lili-lines/ratatouille/README.md

# 🐭 Ratatouille

Lien du blog : https://lili-lines.github.io/ratatouille/

Micromouse with Analog Whiskers
