lili-lines/ratatouille/note.txt

lancer le blog
> bundle exec jekyll serve

selon la date du titre les articles sont affiche, Jekyll n'affiche pas les articles écrire dans le futur
> bundle exec jekyll serve --future

Ref compo :
. https://www.pjrc.com/store/teensy40.html
. https://arduino.blaisepascal.fr/codeur-absolu-as5600/
. gyro : https://components101.com/sensors/mpu6050-module

## References global

- [The Inception of Chedda: A detailed design and analysis of Micromouse](https://www.physics.unlv.edu/~bill/ecg497/Drew_Tondra_report.pdf)
- [Timothy Boger's Engineering Blog — Micromouse](https://timsengineeringblog.weebly.com/micromouse.html)
- [Ian Hoffman — Micromouse Project Introduction](https://ianmhoffman.github.io/Micromouse/)
- [Embedded System Engineering — Micromouse Robot](http://embeddedsystemengineering.blogspot.com/2015/03/micromouse-robot.html)
- [Micromouse exemple design](https://ukmars.org/contests/micromouse/)

. Post 3D print et pièce à construire
retour impression 3D : pour les petites pièce c'était pas tres précis
mais en recoupant eu cuteur ça passe.
et les trop petites pièces se décolle
. Post test moteur + vitesse : shema branchage
. Post composant : utiliser le power du labo + multimetre pour verif chaque IN/OUT

bio-inspiration

Ref :
. https://github.com/prometheux-ar/cyberpunk

Idées :
. Key Takeaways
. What I Learned This Week
. Life Hacks

Legend :
🚧 todo
🐭 for mouse
💡 idées, astuces
👀 resultats
📌 rappel
🔍 zoom
🎓 acquis

### Pour le post Takeaways, composants :
Fichier,	Contenu,	Rôle

_data/components.yml	
les infos (titres, textes, images, IN/OUT) 
ce que tu édites au quotidien

_includes/component-carousel.html	
la structure HTML (boucle Liquid)	
tu n'y touches presque jamais

assets/main.scss	
le CSS .compo-*	style global, 
réutilisable

### 🎨 Style preview — UMBRA theme

Normal text with a [link](#), some **bold**, and inline `code`. You can also
<mark>highlight</mark> an important word.

> ⚠️ Important message — a callout styled like a cyberpunk terminal.

```cpp
int v = analogRead(A0);   // code block, terminal look
```

<ul class="post-tags">
  <li><a href="#">#electronics</a></li>
  <li><a href="#">#algo</a></li>
  <li><a href="#">#whisker</a></li>
</ul>

---

Exemple concret : lire ta moustache (AS5600 → Teensy)
La moustache se plie → l'aimant tourne → l'AS5600 met une tension 
sur sa broche OUT. Convention : 0 V = angle mini, 
3,3 V = angle maxi. 
→ moustache à moitié pliée = ~1,65 V.
Ce fil arrive sur la broche A0 du Teensy.
Le ADC du Teensy mesure cette tension et la transforme en nombre : 
analogRead(A0) → ~2048 (sur 0–4095).
Le Teensy « reconnaît » l'info parce que ton code sait que 
« la tension sur A0 = l'angle de la moustache ». C'est toi qui as 
fixé cette convention en le programmant.

moustache pliée ─► AS5600 sort 1,65 V ─► A0 ─► ADC lit 2048 ─► 
                          "moustache à moitié pliée"
                         (la convention : V ∝ angle)

Information = what we want to know or command, e.g. "the whisker 
is bent", "go at 80%".
L'information est codée dans une grandeur physique du signal : 
une tension 3.3$V$, la vune durée, une suite de bits)
→ Le composant « reconnaît » parce qu'il applique la même 
convention que l'émetteur. C'est comme deux personnes qui 
parlent la même langue.

Signal = the physical carrier of the information on a wire: a 
voltage or a pulse (e.g. 3.3 V = "on"). It carries the information, 
not energy, so its current is tiny.

PARTI 2 MOUSTACHE AS5600

XP:
. aimant + structure stable (proto moustache)
. teensy
. as5600
. power = USB

⚠️ faire une structure ajustable : determiner l'espace optimale entre l'aimant et la puce

result:
. shema du proto
. lecture de la valeur pour chaque angle de la moustache
. estimation des seuils (~)

🚧 TODO: <br>
. mesure avec la piece 3D <br> 
. log the angle → value curve while bending the rod by known amounts, real grah data value (py)

#### 2.1 What do we do with the number ?
Once the angle is a number, we watch for the release: the moment a whisker, bent against a wall, springs back. Two cases:

1. the robot drifts slightly from the wall → the whisker releases slowly
2. the wall ends: intersection → the whisker releases suddenly

#### 2.2 Derivative + threshold
We tell the two apart with the derivative, how fast the signal changes: <br>
. slow release → small derivative <br>
. sudden release → large derivative, a spike <br>

So we put a threshold on the derivative: <br>
. above it → "The wall just ended, there is an opening here" <br>
. below → "I'm just drifting, keep following the wall"

Detecting one specific event by a criterion like this is called discrimination.

PROTOCOLE XP :
1. Baseline, moteur OFF, AVEC les 4 défenses → référence propre
2. AVEC les 4 défenses, moteur ON → compare à la référence
3. Retire le RC filter SEUL, moteur ON → compare, remets-le
4. Retire le découplage SEUL, moteur ON → compare, remets-le
5. Retire le réservoir SEUL, moteur ON → compare, remets-le
6. Casse la masse en étoile, moteur ON → compare, restaure-la

branchement UBS
ouvrir arduino

Tools → Board → Teensy 4.0        (vérifie que c'est coché)
Tools → Port → select le port du Teensy ("Teensy", COMx Serial Port)

Upload code 

Tools → Serial Monitor    (affiche les chiffres en texte)
Tools → Serial Plotter    (affiche un graphique en temps réel — plus visuel)

pour l'enregistrement des valeurs il faut fermer arduino et lancer le script python :
> python xp_log_whisker.py

XP :
. cablage
. branchement USB : code tourne
upload code
> serial monitor = lecture valeur moustache en continu
test tourner la moustache = valeur change
au multimetre :
  STBY	~3,3V (HIGH)
  AIN1	~3,3V (HIGH)
  AIN2	~0V (LOW)
  PWMA	une tension intermédiaire, le multimètre moyenne le PWM, ~1,5-2V pour un duty de 51%

. seulement apres = alim de labo = OUTPUT bouton

motor xp n°1 vitesse = 130, 130 / 255 ≈ 51% duty cycle, 7,4V × 0,51 ≈ 3,8V (bat 7.4V)
motor xp n°2 vitesse = 206
0,81 × 255 ≈ 206

vitesse moteur :
0   = moteur à l'arrêt (0% duty cycle)
128 = environ demi-vitesse (~50%)
255 = vitesse maximale (100% duty cycle)
