lili-lines/ratatouille/roadmap.md

## 🐭 Roadmap Micromouse : June 12 → August 22, 2026

### 🗓️ Week 1 — June 12 to 18

**Target**
- **Elec :** BOM + diagram
- **Mecha :** Design the moustache module x4: base plate of the whisker module + whisker arm + chassis + motor brackets ×2. <br>
*Lang&Tools : Fusion 360*
- **Algo :** maze-solving algo, clone simu [**mms**](https://github.com/mackorone/mms)
*Lang&Tools : Python, mms*
- **Test :** sim plan → real

**Progress files**
- BOM.md
- 3D files

### 🗓️ Week 2 — June 19 to 25

**Target**
- **Elec/Mecha :** assemble prototype mustache module (pivot + magnet + AS5600) and read the angle in analog mode on a test bench. Characterize the rod displacement → read value. <br>
*Lang&Tools : Python*
- **Algo :** full flood-fill in MMS : exploration, BFS from the center, re-flood. Plan now for the separation of exploration and speed runs <br>
*Lang&Tools : C++*

**Progress files**
- flood-Fill
- 1 mustache module : outputs a specific analog value corr to the bending
- angle → distance, curve plotted (py)

### 🗓️ Week 3 — June 26 to July 2

### 🗓️ Week 4 — July 3 to 9

### 🗓️ Week 5 — July 10 to 16

### 🗓️ Week 6 — July 17 to 23

### 🗓️ Week 7 — July 24 to 30

### 🗓️ Week 8 — July 31 to August 6

### 🗓️ Week 9 — August 7 to 13

### 🗓️ Week 10 — August 14 to 21
