lili-lines/ratatouille/_posts/2026-07-25-as5600-analog.md

---
layout: post
title: The whisker ⚞ • ⚟
date: 2026-07-25 10:00:00 +0200
tags: [electronics, hardware, experiment]
---

* TOC
{:toc}

First sensor on the bench: the whisker, from a magnet angle to a number. The contact process consists of 2 steps: first, read the whisker, then decide what it means.

## 1. Acquisition, from angle to a number

#### 1.1 AS5600 output
The AS5600 angle sensor can output its value in 3 ways[^1]:

| Mode | What the chip outputs | How you read it |
|---|---|---|
| **PWM** | a pulse whose width = the angle | a timer pin |
| **I2C** | a digital number in a register | the I2C bus |
| **Analog** 🐭 | a voltage (0–3.3 $V$) = the angle | an ADC (Analog-to-Digital Converter) pin |

**PWM (Pulse Width Modulation)** = a signal switched on/off very fast. The angle is encoded by the duration of the "on" time, not by the voltage level. It gives the full angle, but to read it you must time a whole pulse, so each reading waits one full cycle → slow read speed and a low sampling rate (few readings/s).

**I2C (Inter-Integrated Circuit)** = the AS5600 has a fixed I2C address (0x36) you cannot change, so two of them (left + right whisker) cannot share one bus: they would clash, or need an extra switching chip (a multiplexer).

🐭 **Analog**[^2] = each sensor gets its own wire to its own ADC pin. Two sensors = two pins, no clash. Analog is also faster: the read is instant, so the robot reacts quickly when a whisker hits a wall. And it is easy to clean: being an analog signal, a simple RC filter removes the motor noise. <br>

RC = a Resistor + a Capacitor wired together, it lets the slow useful signal pass and blocks the fast noise.

#### 1.2 Experiment, read the whiskers over USB

**Goal** <br>
The goal is to read the AS5600 angle on the Teensy, no motors yet, powered over USB.

<aside style="float:right; width:220px; margin:4px -300px 8px 18px; padding:10px 14px; background:#f6e9fb; border:1px solid #a21caf; border-radius:6px; font-size:0.9rem;">
<strong> 🧲 MAGNET, diametric or axial, how to know?</strong><br>
Bring another magnet (or a paperclip) close:
<ul style="margin:6px 0; padding-left:18px;">
<li>sticks mostly on the 2 flat faces → axial ❌</li>
<li>sticks on one side of the round face and repels the opposite side → diametric ✅</li>
</ul>
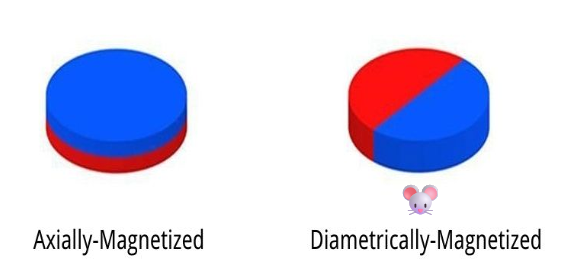
[picture p10: assets/img/magnet.png]

<span style="font-size:0.75rem;">Image source: <a href="https://www.stanfordmagnets.com/what-is-the-magnetization-direction-for-permanent-magnets.html" target="_blank" rel="noopener">Stanford Magnets</a></span>
</aside>

**Material**
<div class="two-col">
<div class="col">
. Teensy 4.0 + USB cable<br>
. 1–2 AS5600 modules + a diametric Ø4 magnet <br>
. 830-point breadboard (MB-102) <br>
. male-to-male Dupont jumper wires<br>
. soldering iron + solder <br>
</div>
<div class="col" style="flex:0.5;">
Software: <br>
. Arduino IDE <br>
</div>
</div>
<br>

**Setup** <br>
Wiring per whisker ×2, so two ADC pins, 14/A0 & 15/A1:

<figure style="margin:0;">
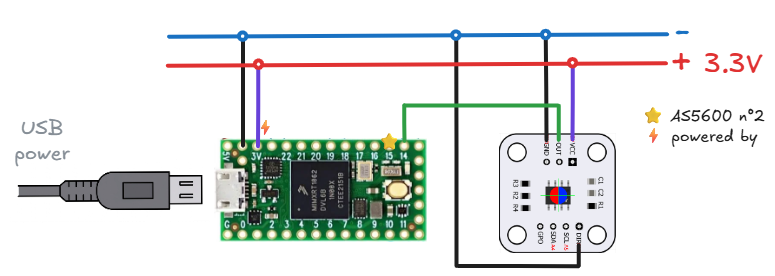
[picture p11: assets/img/xp_as5600.png]
  
  <figcaption style="text-align:center; font-size:0.85rem;">Breadboard example for 1 whisker (14/A0)</figcaption>
</figure>

. VCC = the + power pin 3.3V <br>
. GND = ground, the − pin common reference <br>
. OUT = the signal output, just speaks, 0 to 3.3 V depending on the angle <br>
. DIR = GND, it sets the counting direction

<aside style="float:right; width:240px; margin:4px -300px 8px 18px; padding:10px 14px; background:#0c0c0c; border:1px solid #333333; border-radius:5px; font-family:'Cascadia Code','Consolas','Courier New',monospace; font-size:0.75rem; color:#cccccc; line-height:1.5;">
<strong style="color:#e5e5e5;">Arduino IDE memo</strong><br><br>
<span style="color:#23d18b;"> >File → Preferences → "Additional boards manager URLs"</span> → paste:<br>
<span style="color:#29b8db;">https://www.pjrc.com/teensy/package_teensy_index.json</span><br>
<span style="color:#23d18b;"> >Tools → Board → Boards Manager</span> → search "Teensy" → Install<br>
<span style="color:#23d18b;"> >Tools → Board → Teensy → Teensy 4.0</span><br>
Your code runs <span style="color:#dcdcaa;">Serial.print(rawL)</span> → it sends a number 0 to 4095 several times per second.<br>
<span style="color:#23d18b;"> >Tools → Port</span> → you should be able to tick a port (often "Teensy" or COMx)<br><br>
<span style="color:#23d18b;"> >File → Examples → 01.Basics → Blink</span> → a code window opens<br>
Click <span style="color:#23d18b;">Upload</span> the arrow, top left<br>
Then the LED blinks
</aside>

**Protocol** <br>
. solder the header pins on the Teensy and on the AS5600 modules <br>
. wire as in the diagram: VCC → 3.3 V, GND → GND, DIR → GND, OUT → A0 <br>
. turn the magnet by hand in front of the chip and watch the value <br>
. read the signal on the Serial Monitor & Plot

. upload on the Teensy: <br>
[xp1_as5600.cpp]({{ site.repo }}/algo/xp1_as5600.cpp) <br>

**Success criteria** <br>
. at rest the value does not drift <br>
. a full turn of the magnet sweeps the whole scale, not a fraction of it. If it is truncated, the magnet is too far or off-centre <br>
. back to the same magnet position → back to the same value, approximately <br>

For this first experiment the magnet is turned by hand & the values are read by eye on the Serial Monitor, so everything here is approximate. So the criteria are validated qualitatively. The precise angle & value curve comes later, once the whisker sits on a fixed structure.

**Result**

The wiring in pictures:

<div style="display:flex; gap:8px;">
  <figure style="flex:1; margin:0;">
    
    <figcaption style="text-align:center; font-size:0.85rem;">converted female cable to male by adding a connector pin</figcaption>
  </figure>
  <figure style="flex:1; margin:0;">
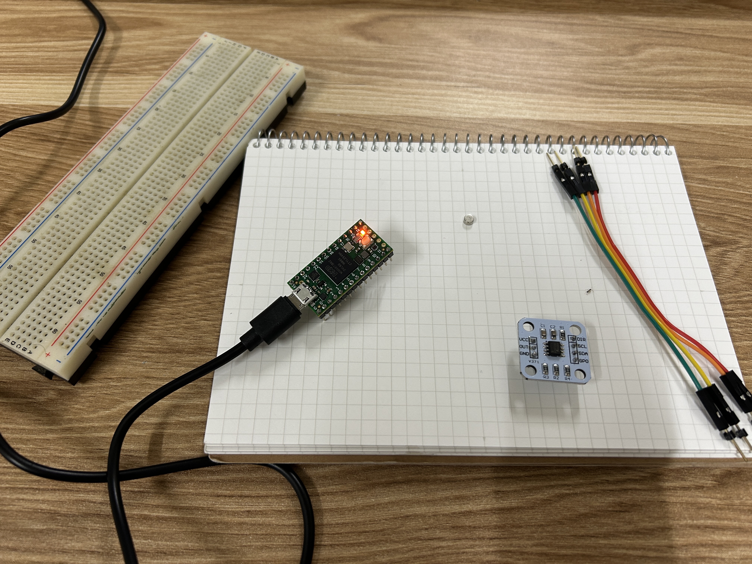
[picture p13: assets/img/xps_as2.jpg]
    
    <figcaption style="text-align:center; font-size:0.85rem;">the components</figcaption>
  </figure>
  <figure style="flex:1; margin:0;">
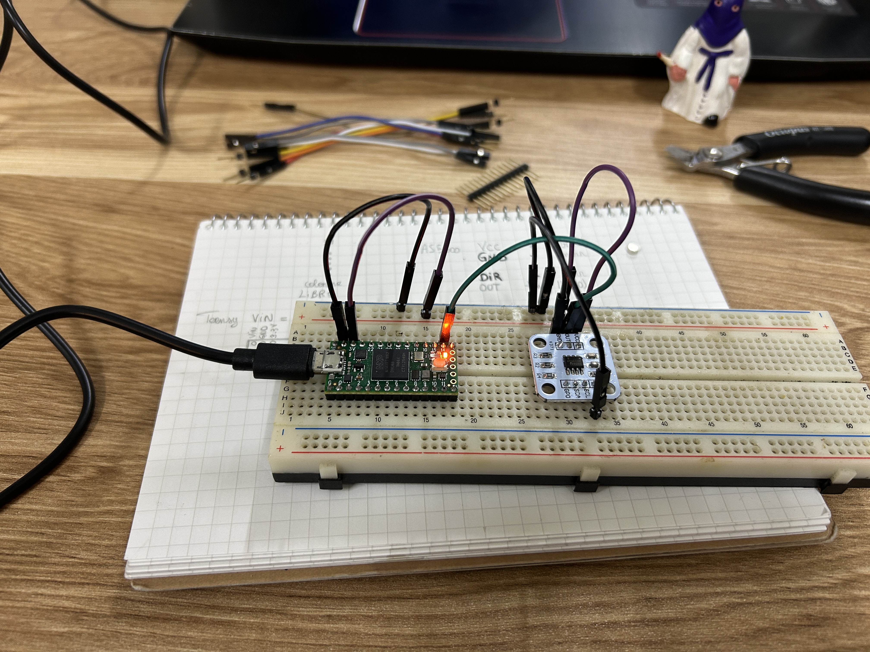
[picture p14: assets/img/xps_as1.JPG]
    
    <figcaption style="text-align:center; font-size:0.85rem;">the connection</figcaption>
  </figure>
  <figure style="flex:1; margin:0;">
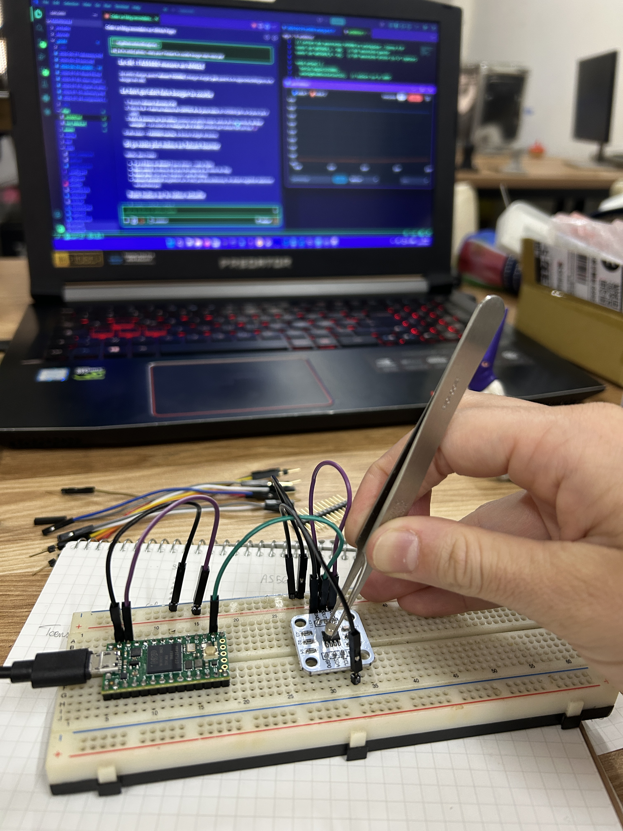
[picture p15: assets/img/xps_as0.JPG]
    
    <figcaption style="text-align:center; font-size:0.85rem;">magnet reading test</figcaption>
  </figure>
</div>

The 3 criteria are met: <br>
. at rest the value holds still <br>
. a full turn of the magnet sweeps the whole range <br>
. coming back to the same position gives back the same value

<div style="display:flex; flex-wrap:wrap; gap:16px; align-items:flex-start; margin:24px 0;">
  <figure style="flex:1; min-width:260px; margin:0;">
    <div style="position:relative; width:100%; aspect-ratio:16/9; border-radius:6px; overflow:hidden;">
      <iframe src="https://x.com/i/videos/tweet/2100535141982482580" style="position:absolute; inset:0; width:100%; height:100%; border:0;" allowfullscreen allow="autoplay; fullscreen; picture-in-picture"></iframe>
    </div>
    <figcaption style="text-align:center; font-size:0.85rem;">Reading the diametric magnet with the AS5600 — <a href="https://x.com/lili_lines/status/2100535141982482580">see on X</a> analogRead(A0) returns 0…4095. The sketch sets analogReadResolution(12) because the AS5600 is natively 12-bit. </figcaption>
  </figure>
  <figure style="flex:1; min-width:260px; margin:0;">
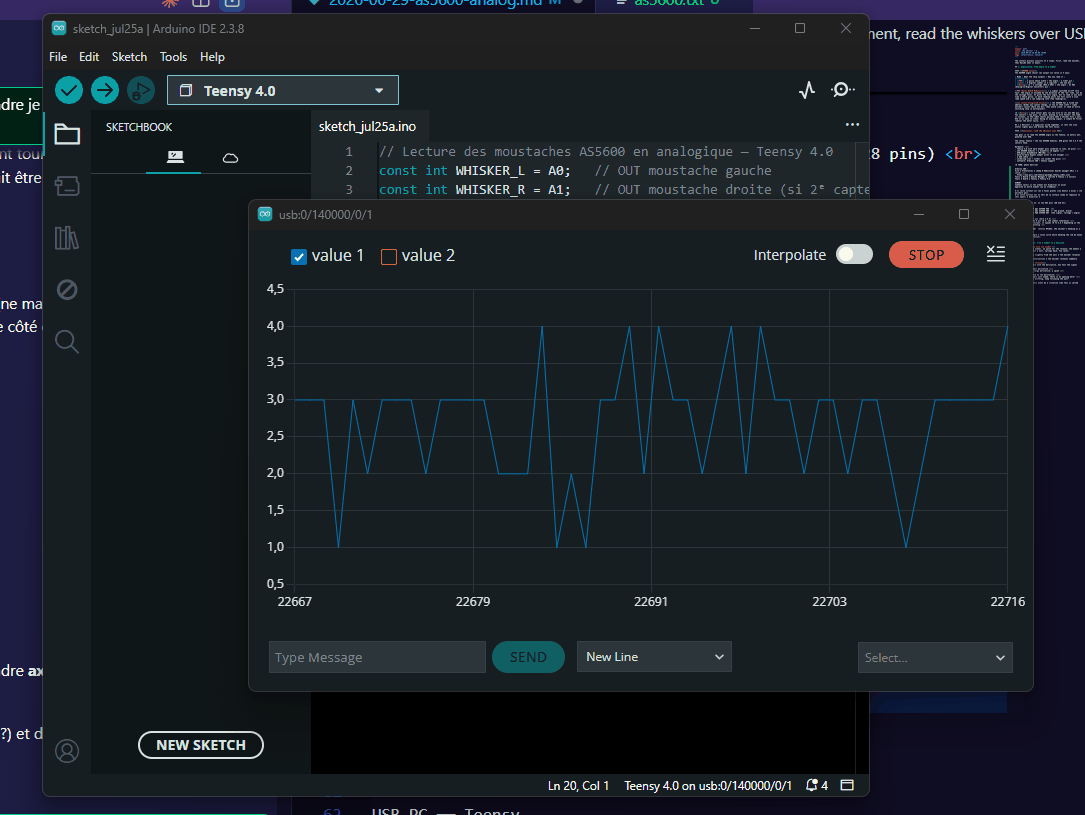
[picture p16: assets/img/as5600.gif]
    
    <figcaption style="text-align:center; font-size:0.85rem;">AS5600 reading the magnet angle</figcaption>
  </figure>
</div>

## 2. Interpretation, from a number to a decision

**Material** <br>
. same as section 1

**Goal** <br>
Quantify and visualise what a push and a release of a whisker look like.

**Protocol** <br>
<div class="two-col">
<div class="col" markdown="1">
. set the AS5600 rest value around 2048 <br>
. record the baseline at rest <br>
. imitate a fast release of the whisker <br>
. imitate a slow release of the whisker <br>
. for the front whisker, a simple push
</div>
<div class="col" markdown="1">
Upload on the Teensy: <br>
[xp1_as5600.cpp]({{ site.repo }}/algo/xp1_as5600.cpp) <br>
Run the script to record the values in a CSV <br>
[xp1_log_as5600_2.py]({{ site.repo }}/algo/xp1_log_as5600_2.py)
</div>
</div>

**Success criterion** <br>
The 3 actions must be visible in the data.

**Results** <br>

<figure style="margin:0;">
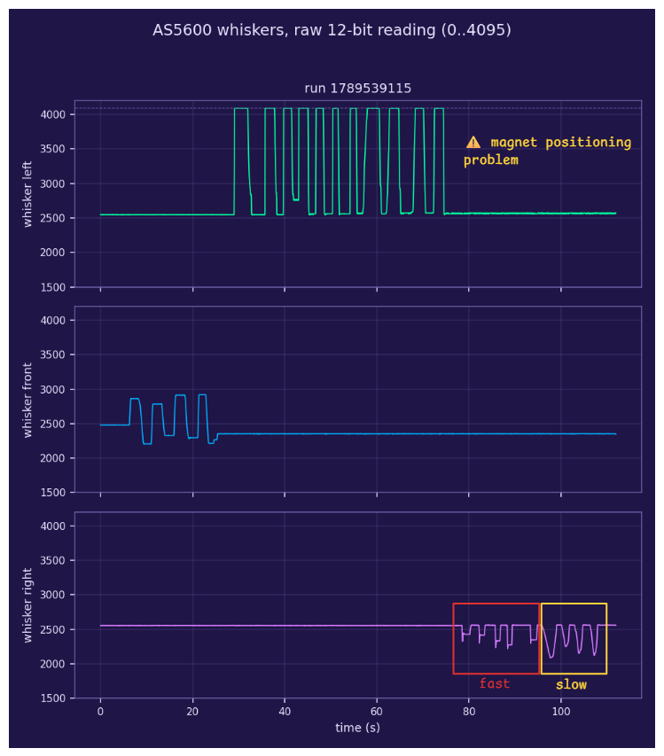
[picture p17: assets/plot_xp/xp1_as5600_plot.png]
The three whiskers pushed and released one after the other, raw 12-bit reading
  
  <figcaption style="text-align:center; font-size:0.85rem;">The three whiskers pushed and released one after the other: front t = 6-26s, left 29-75s, right 78-108s. Each plot on its own range. Data: [xp1_as5600_log_1789539115.csv]({{ '/assets/data_xp/xp1_as5600_log_1789539115.csv' | relative_url }})</figcaption>
</figure>

The criteria are met: the data show the difference between a fast movement steep slope & slow gentle slope. They also give the thresholds: at rest the noise is under 10 counts, a push moves the value by 250 to 470, so a contact is a deviation from rest of more than 150, and the return to rest marks the release. <br>
One problem shows up on the left magnet: a contact sends the value to 4090, the maximum of the ADC, the signal is clipped. The magnet position is to be reviewed for the v2. The whisker reads well at rest. Now, how the signal behaves with the motors ON.

<br>

[^1]: [RobTillaart/AS5600 — Arduino library documentation](https://github.com/RobTillaart/AS5600/blob/master/README.md), the three output modes, and why the address forces our hand: *"The I2C address of the AS5600 is always 0x36 and cannot be changed"*, while the AS5600L variant can
[^2]: [AS5600 analog out problem — Digi-Key TechForum](https://forum.digikey.com/t/as5600-angle-magnetic-sensor-analog-out-problem/3325), the fix when OUT stays stuck high on the common breakout board
