lili-lines/ratatouille/_posts/2026-07-28-clean-signal-under-pwm.md

---
layout: post
title: Clean whisker signal, PWM
date: 2026-07-28 10:00:00 +0200
tags: [electronics, hardware, signal, experiment]
---

<div class="learned">
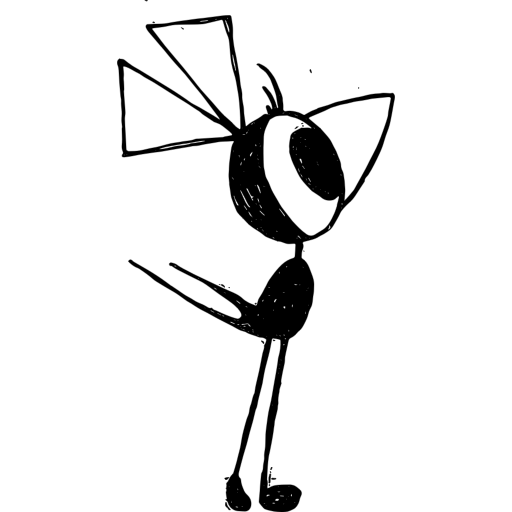
[picture p18: assets/img/line.png]

<div class="learned-text" markdown="1">
**What I learned** <br>
The noise on the whisker line is real (~3.5 mV rms, the same at 10-bit and 12-bit). One defender matters: the star ground, which alone gives the cleanest reading, the RC filter and the capacitors make no measurable difference on the breadboard. The experiment gives the value of the normal noise, ~90 counts peak-to-peak, which becomes the whisker tolerance for the rest of the project.
</div>
</div>

* TOC
{:toc}

First, what PWM is. Then a close look at how the AS5600 sensors behave with the motor ON, testing one by one how well each noise defender in the circuit does its job.

## 1. Pulse Width Modulation (PWM)

Continuously varying the motor's voltage is hard. Instead, the Teensy generates a PWM signal, a simple on/off command 3.3 V logic. The motor driver TB6612FNG follows it and switches the motor's 7.4 V supply on/off thousands of times per second.
What sets the power is the duty cycle = the share of time the signal stays **on**. <br>
80% **on** ≈ 80% max speed. Fast, and with no voltage regulation needed.

<div class="two-col">
<div class="col" style="text-align:center">
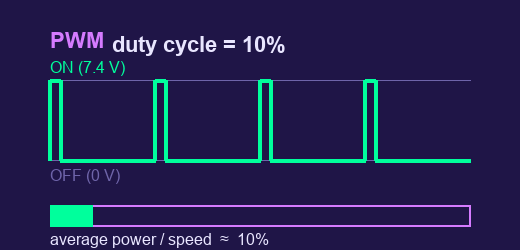
[picture p19: assets/img/pwm_duty.gif]
PWM duty cycle animation

</div>
<div class="col" style="text-align:center">
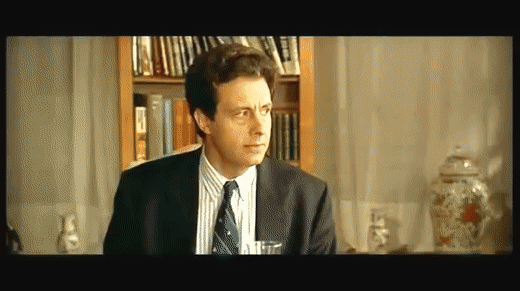
[picture p20: assets/img/jour_nuit.gif]
Day / night analogy

<br><small><em>Les Visiteurs, 1993 - jour, nuit, jour, nuit</em></small>
</div>
</div>

These fast switches create electrical noise that leaks into the whole circuit and can pollute the AS5600 whisker's fragile analog signal → the reading shakes. This is the signal side and the power side of [Signal vs power]({% post_url 2026-07-07-signal-vs-power %}) sharing the same circuit, and here the power side wins.

🐭 In the MicroMouse: this is the "PWM-limited so the average stays ≈ 6 V" line from the BOM. The battery is 7.4 V, but at a duty cycle of ~81% the average the motor sees ≈ 6 V.

## 2. Clean whisker signal under PWM

It means the reading stays clean while the motors run, that's the challenge, since a clean signal at standstill is easy.

The noise defenses[^2]:
- the RC filter, resistor + capacitor, on each whisker line,
- the decoupling capacitors next to each chip[^1],
- the reservoir capacitor on the motor rail,
- the star ground, one common ground point.

#### 2.1 Experiment

**Goal** <br>
Read the AS5600 signal while the motors are ON, and test how well the noise filters work.

**Material** <br>
. a bench power supply: voltage 7.4 V, current limit 300-500 mA <br>

<div class="two-col">
<div class="col">
. Teensy <br>
. 1-2 AS5600 + magnet <br>
. 1 motor N20 <br>
. driver <br>
. Breadboard + Dupont wires <br>
. Multimeter, check the voltages before wiring everything together <br>
</div>
<div class="col">
The noise defenses: <br>
. RC filter / whisker (R 1 kΩ + C 100 nF) <br>
. decoupling capacitor (100 nF) next to each chip <br>
. reservoir capacitor (≥ 470 µF) <br>
. wiring: star ground, one common GND point <br>
</div>
</div>

<div style="display:flex; flex-wrap:wrap; gap:16px; align-items:flex-start;">
  <figure style="flex:1; min-width:260px; margin:0;">
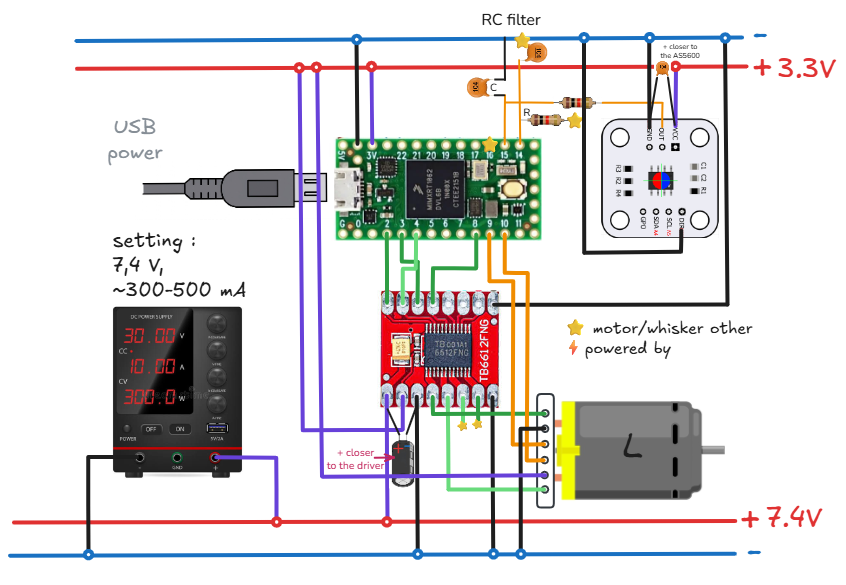
[picture p21: assets/img/xp_signal_PWM.png]
Wiring schematic of the experiment
    
    <figcaption style="text-align:center; font-size:0.85rem;">Schematic to wire the components of the experiment</figcaption>
  </figure>
  <figure style="flex:1; min-width:260px; margin:0;">
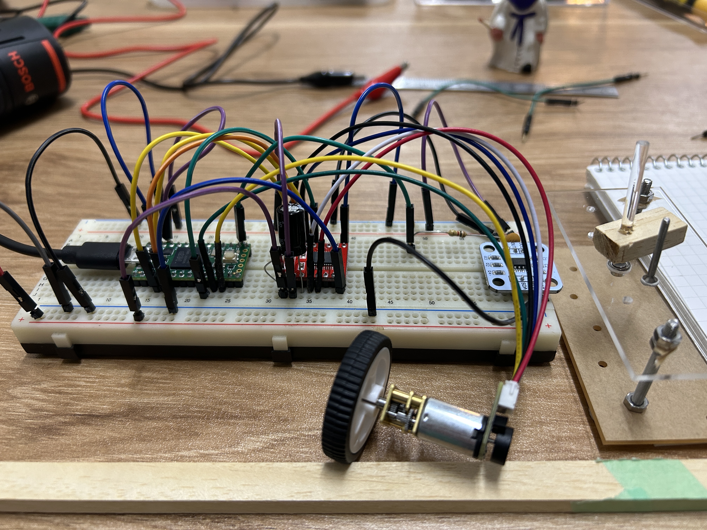
[picture p22: assets/img/IMG_9324.JPG]
The experiment on the breadboard: Teensy, driver, reservoir capacitor, RC filter, AS5600 and the N20 motor
    
    <figcaption style="text-align:center; font-size:0.85rem;">The breadboard, the magnet on its holder facing the AS5600</figcaption>
  </figure>
</div>

**Protocol:** <br>
Each step changes only one thing at a time, at 2 motor speeds, PWM 130 and 206. <br>

<div class="two-col">
<div class="col">
. baseline = motor OFF, with 4 defenders <br>
. 4 defenders, motor ON PWM running <br>
. no defenders, motor ON <br>
. star ground only, motor ON <br>
</div>
<div class="col">
. remove RC filter only, motor ON <br>
. remove decoupling capacitor only, motor ON <br>
. remove reservoir capacitor only, motor ON <br>
. break star ground (daisy-chain), motor ON <br>
</div>
</div>
<br>

Upload on the Teensy: <br>
[xp2_pwm.cpp]({{ site.repo }}/algo/xp2_pwm.cpp) <br>
To record the data: [xp2_pwm_log.py]({{ site.repo }}/algo/xp2_pwm_log.py) <br>
To extract the stats: [xp2_compare_12bit.py]({{ site.repo }}/algo/xp2_compare_12bit.py)

**Success criterion** <br>
With the motor ON, removing a defender makes the reading measurably noisier than with all four

**Result** <br>
A first run was done at 10-bit (see Appendix A). Since the AS5600 is a 12-bit sensor, the experiment was redone at 12-bit, `analogReadResolution(12)` 0–4095.

<figure style="margin:0;">
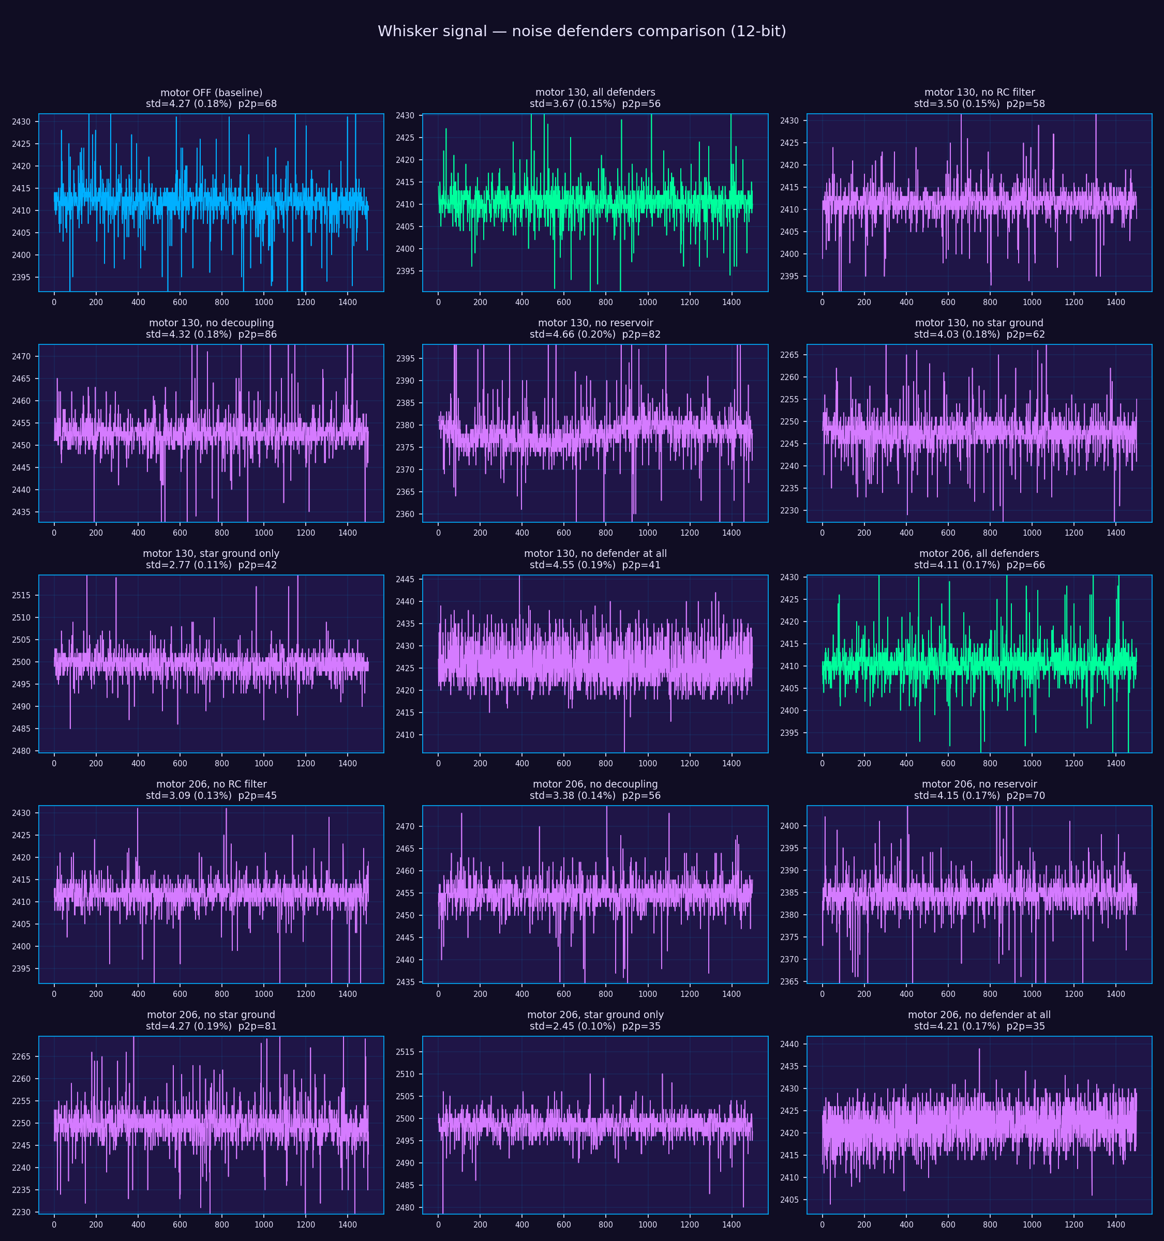
[picture p23: assets/plot_xp/xp_compare_all_12b.png]
Whisker signal for the 11 conditions at 12-bit, each centered on its own mean
  
  <figcaption style="text-align:center; font-size:0.85rem;">12-bit, in blue the baseline, in green all defenders, in purple one defender removed at a time.</figcaption>
</figure>
<br>

<figure style="margin:0;">
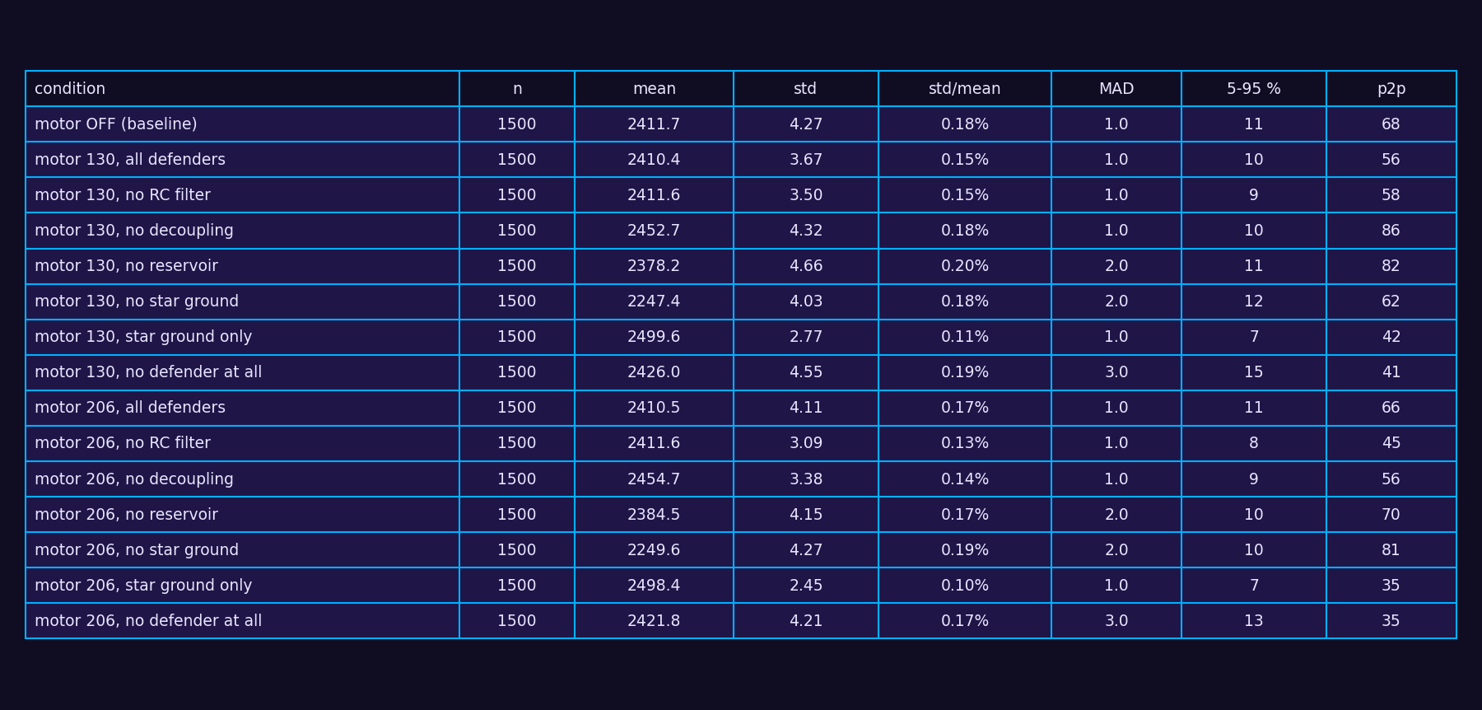
[picture p24: assets/plot_xp/xp_stats_table.png]
Table of the mean, standard deviation, relative std and peak-to-peak per condition at 12-bit
  
  <figcaption style="text-align:center; font-size:0.85rem;">The same numbers as a table. std/mean rather than std alone, because the magnet moves a little between conditions. MAD = median absolute deviation, the constant fuzz, blind to the rare spikes. 5-95 % = width of the band that holds 90 % of the samples. Data: the 15 recordings and the stats table, in [data_xp/as5600_12bit]({{ site.repo }}/assets/data_xp/as5600_12bit)</figcaption>
</figure>
<br>

The noise is real, std ~3.5 mV, and the defenders do not all matter. One stands out: the star ground. Alone, it gives the cleanest reading of the whole table, std 2.5-2.8 mV, 5-95 % band 7 counts, peak-to-peak 35-42, better than the four defenders together. Removing it is what hurts: the constant fuzz (MAD) doubles and the band widens to 12 counts. The RC filter, the decoupling and the reservoir capacitors make no measurable difference on this breadboard. <br>
Success criterion partly met: removing the star ground makes the reading measurably noisier; removing any other defender does not.

<br>

What the experiment gives instead is the value of the normal noise: motor ON or OFF, the reading stays within ~90 counts peak-to-peak. This is the whisker tolerance used in [Flash the critter]({% post_url 2026-08-20-flash-the-critter %}). It was measured on a breadboard with one unloaded motor, so it must be checked again on the assembled mouse. The whisker is settled. The other question a mouse must answer: Where's Wally?

<br>

[^1]: [TI — Four ways to improve your ADC system power supply rejection](https://e2e.ti.com/blogs_/archives/b/precisionhub/posts/four-ways-to-protect-your-adc-system-power-supply-rejection)
[^2]: [Solo — Electrical Noise Reduction Techniques for Motor Controllers](https://www.solomotorcontrollers.com/blog/electrical-noise-reduction/)

<details class="appendix" markdown="1">
<summary>Appendix A — the 10-bit run, for comparison</summary>

<figure style="margin:0;">
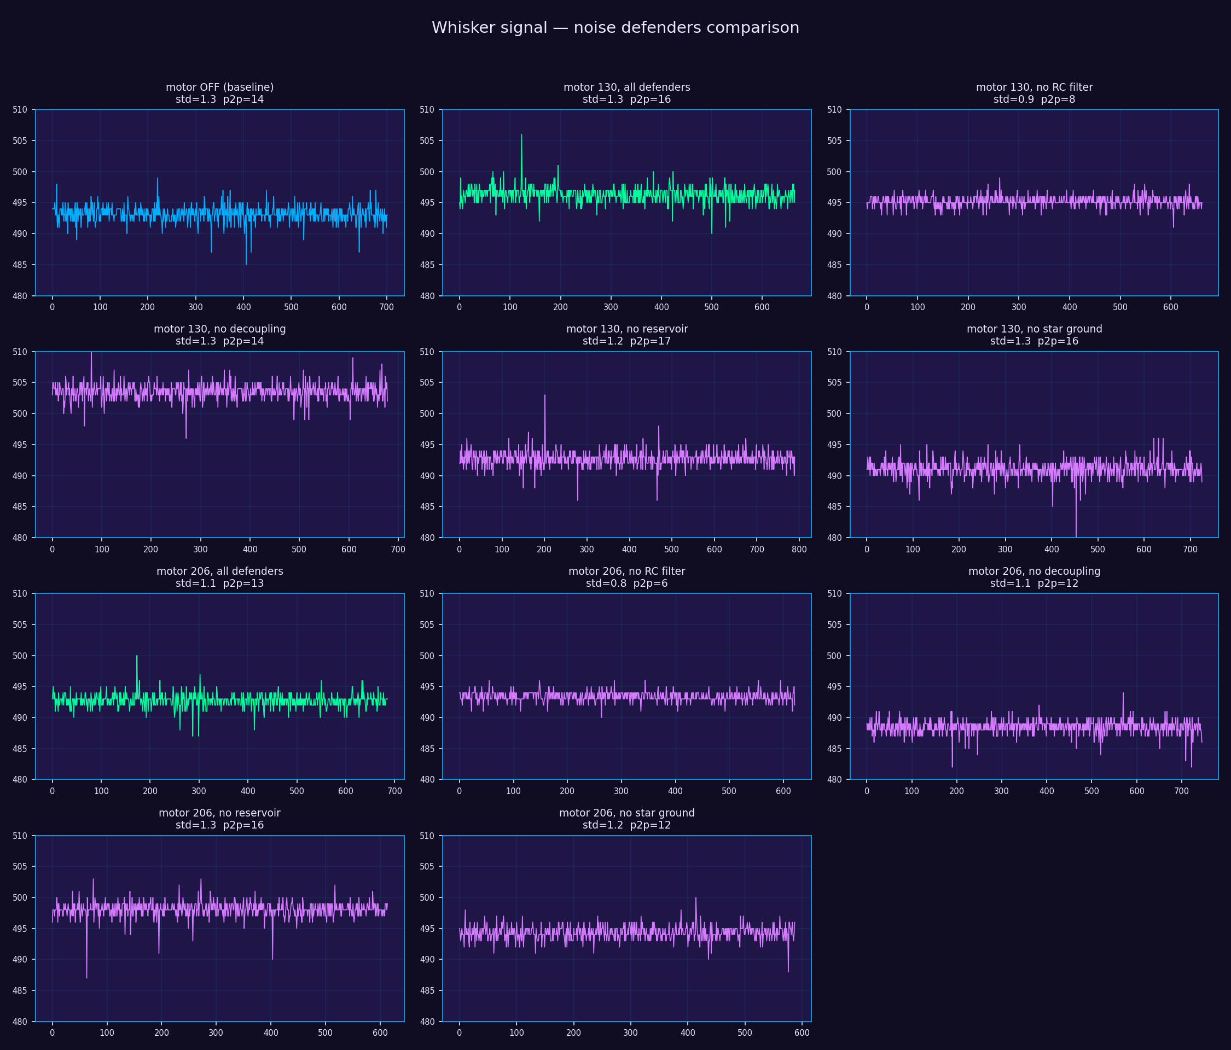
[picture p25: assets/plot_xp/xp_compare_all.png]
Whisker signal for the 11 conditions, with std and peak-to-peak
  
  <figcaption style="text-align:center; font-size:0.85rem;">10bits precision, in blue the baseline, in green all defenders, in purple one defender removed at a time</figcaption>
</figure>
<br>

<figure style="margin:0;">
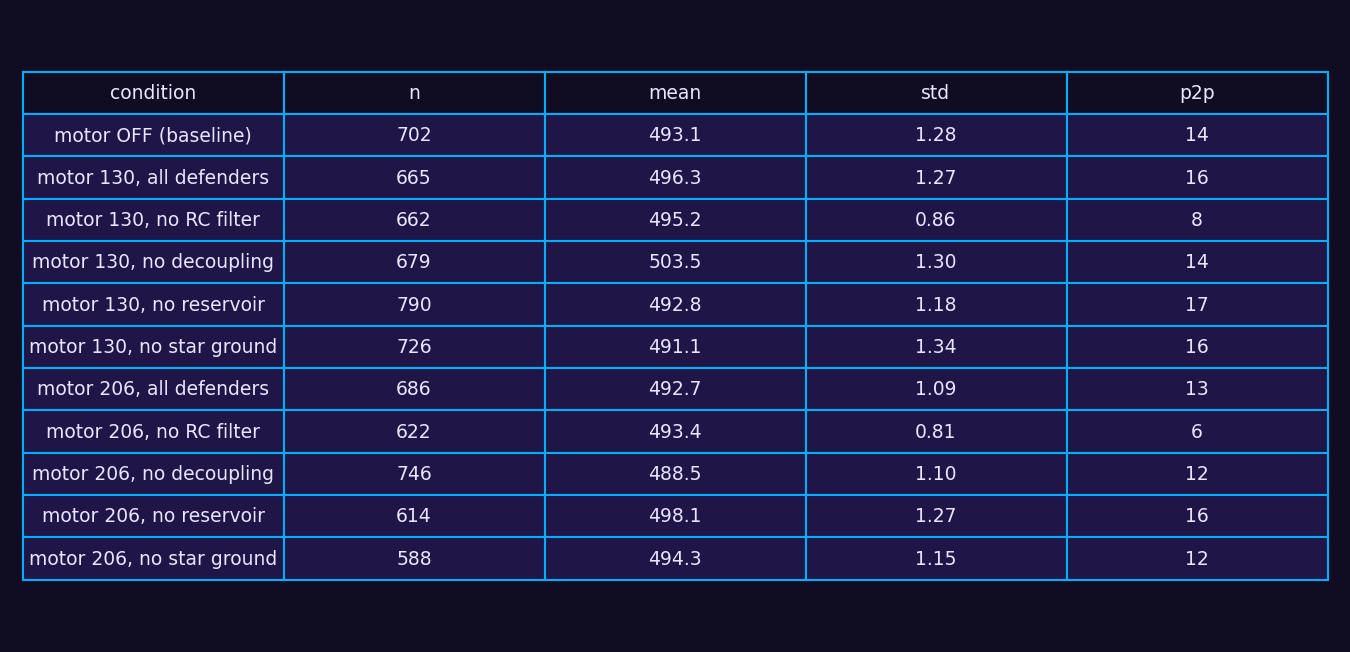
[picture p26: assets/plot_xp/xp_stats_table_10b.png]
Table of the mean, standard deviation and peak-to-peak per condition
  
  <figcaption style="text-align:center; font-size:0.85rem;">The same numbers as a table</figcaption>
</figure>
<br>
</details>

*[MAD]: Median Absolute Deviation, gives the thickness of the background noise
