lili-lines/ratatouille/_posts/2026-08-01-odometry.md

---
layout: post
title: Odometry ? 🧭
date: 2026-08-01 10:00:00 +0200
tags: [hardware, navigation, experiment]
---

<div class="learned">

<div class="learned-text" markdown="1">
**What I learned** <br>
The gyro has a bias, −2°/s at rest: measured at startup and subtracted, only 0.007°/s remain. The encoders give 1151 counts per wheel turn, so 0.087 mm per tick, and they only see the wheel, not the floor. The position they compute is the middle of the axle, not the nose.
</div>
</div>

* TOC
{:toc}

This post is about how the mouse knows its position in the maze. Two kinds of sensors give two things: the wheel encoders the position $(x, y)$, the Inertial Measurement Unit (IMU) the orientation, the heading. I also test the reading and the calibration of each one on the breadboard.

⏰ Plan B, without wheel encoder: an optical flow sensor PMW3901 that measures displacement. Its advantage is being more precise, but it must be mounted on a mast at ≥80 mm above the ground.

## 1. IMU and wheel encoder sensors

The mouse has 3 sensors to know its position and navigate in the maze. 2 wheel encoders measuring the distance travelled by their wheel. These sensors give the position $(x, y)$, the one of the point halfway between the 2 wheels, at the axle[^2]. And the IMU gyro, which gives the heading, which way the robot faces. <br>
Each one covers the other's weakness, encoders drift when a wheel slips, so spin without moving, and the gyro drifts slowly over time.

#### 1.1 Experiment

**Goal** <br>
Wire the gyro and the wheel encoder to the Teensy. Do the first calibrations and check that they return a correct position and heading. For the gyro, correct the bias shown at rest. For the wheel encoder, compute the Counts Per Revolution (CPR).

**Material**
<div class="two-col">
<div class="col">
. Teensy + USB cable <br>
. gyro MPU-6050 / GY-521, IMU, I2C bus, address 0x68 <br>
. breadboard + dupont wires <br>
. ruler, protractor, floor marking <br>
. 1-2 N20 motors with built-in hall encoder <br>
. driver TB6612FNG <br>
</div>
<div class="col">
Software: <br>
. Arduino IDE, serial monitor <br>
. Python <br>
</div>
</div><br>
**Setup**
<div style="display:flex; flex-wrap:wrap; gap:16px; align-items:flex-start;">
  <figure style="flex:1; min-width:260px; margin:0;">
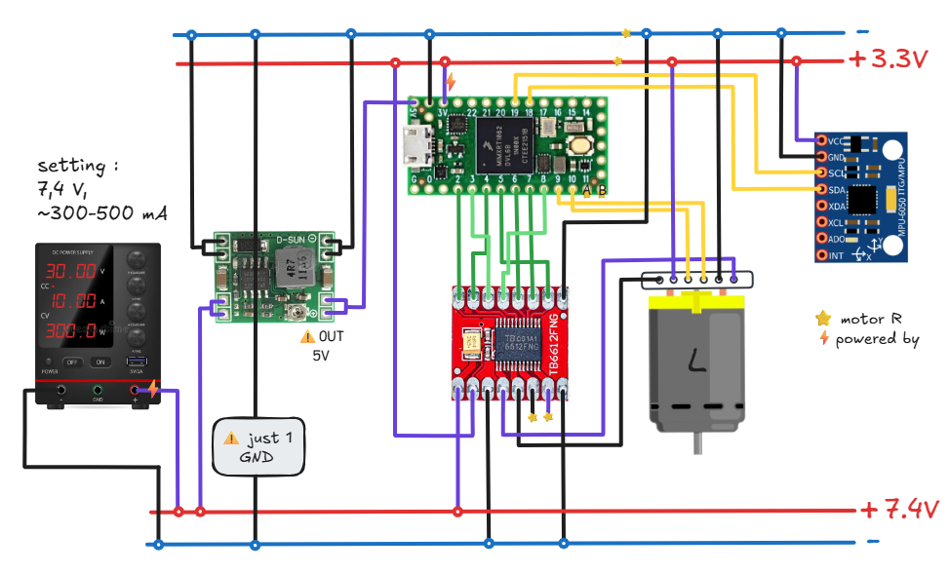
[picture p27: assets/img/xp_odometre_A.png]
Wiring schematic with N20 and hall encoder
    
    <figcaption style="text-align:center; font-size:0.95rem;">Schematic to wire the components of the experiment with N20 & hall encoder</figcaption>
  </figure>
  <figure style="flex:1; min-width:260px; margin:0;">
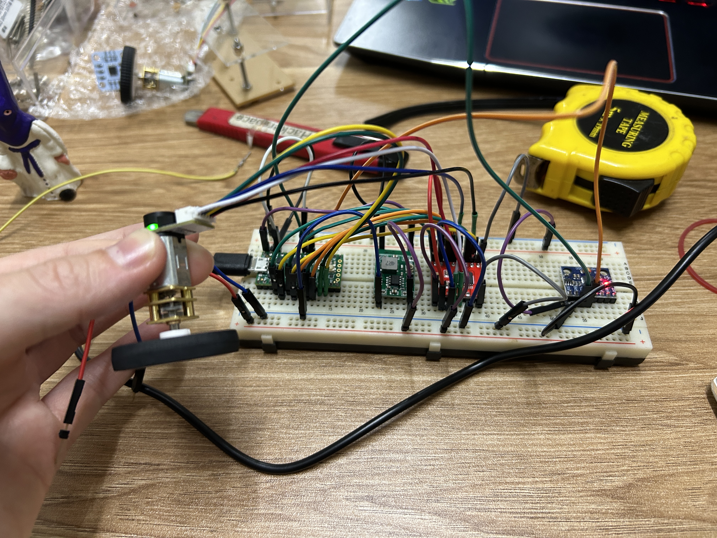
[picture p28: assets/img/xp2_odometrie.JPG]
Gyro and encoder wired on the breadboard
    
    <figcaption style="text-align:center; font-size:0.95rem;">The wiring on the breadboard</figcaption>
  </figure>
</div><br>
<div class="two-col">
<div class="col" markdown="1">
**Protocol** <br>
. gyro without calibration, to watch the drift at rest <br>
. calibrated gyro, the bias is measured at startup then subtracted <br>
. encoder alone, turn the wheel by hand for 10 full turns to get the CPR <br>
. Known rotation, turn the robot on itself by a known angle. Compare with the heading computed by the gyro. <br>
. measure the angle with the motor running

Upload on the Teensy: <br>
[xp3_gyro.cpp]({{ site.repo }}/algo/xp3_gyro.cpp) <br>
[xp3_odometry_a.cpp]({{ site.repo }}/algo/xp3_odometry_a.cpp) <br>
[xp3_encoder_cpr.cpp]({{ site.repo }}/algo/xp3_encoder_cpr.cpp) <br>

</div>
<div class="col" markdown="1">
**Success criteria** <br>
. the gyro bias is corrected <br>
. the CPR of the wheel encoder is obtained <br>
. the angles computed by the Teensy match the real measured angles, with an acceptable error of ±5° for this first test. The real tolerance, ±2°, is derived from the error budget in [Flash the critter]({% post_url 2026-08-20-flash-the-critter %})
</div>
</div>

**Results**
<div class="two-col">
<div class="col">
<figure style="margin:0;">
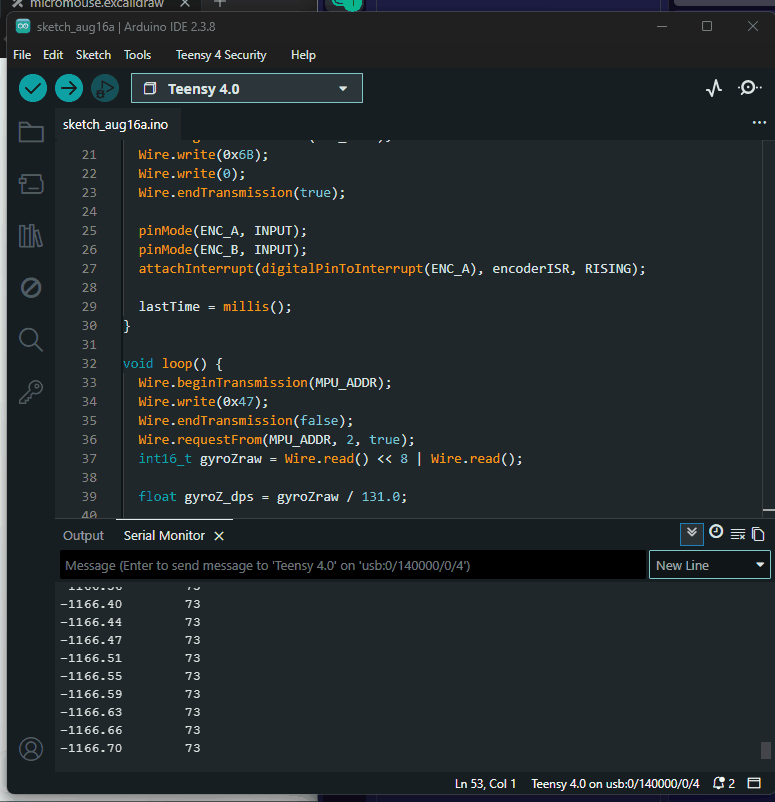
[picture p29: assets/img/xp_gyro_hall.gif]
Serial Monitor before the bias correction
  
  <figcaption style="text-align:center; font-size:0.95rem;">Serial Monitor, before the gyro correction, on the left the gyro heading, on the right the wheel encoder</figcaption>
</figure>
</div>
<div class="col" markdown="1">
We can see the gyro bias: (→ The gyro bias is visible:) the sensor returns -2°/s between each value while the gyro is not moving.
To correct this, we calibrate the gyro value at startup, then in the loop we subtract the bias before integrating: (→ To correct this, I calibrate the gyro value at startup, then in the loop I subtract the bias before integrating:)

```cpp
float gyroZ_dps = (gyroZraw / 131.0) - gyroZ_bias;
```

After this correction there is still a drift, but a small one: even calibrated, the gyro drifts slowly. To correct this in the v2 we can use the wheel encoder. (→ The v2 can correct this with the wheel encoders.)
</div>
</div><br>

<div class="two-col">
<div class="col" markdown="1">
init value ~ 0 & turn of 90° clockwise <br>
value = -88.87 <br>
error = |headingDeg_measured − real_angle| <br>
error = |90 − 88.87| = 1.13° < 5° so ✅ <br>
</div>
<div class="col" markdown="1">
Now let's compute the CPR, for this we turn the wheel by hand, exactly 10 full turns. (→ Now the CPR: I turn the wheel by hand, exactly 10 full turns.) <br>
init value -166 <br>
value after 10 turns -11677 <br>
CPR = (final value − init value) / 10 <br>
CPR[^1] ≈ 1151
</div>
</div>

So we can now compute the mm per count: (→ From this, the mm per count:)
the number of mm the mouse travels in one wheel turn, circumference ≈ 100mm (Ø32mm) <br>
mm per count = 100mm / 1151 ≈ 0.087mm per pulse

```cpp
const float MM_PER_TICK = 100.0 / 1151.0;               // ≈ 0.087 mm
const long TICKS_TARGET = (long)(300.0 / MM_PER_TICK);  // 30cm → 3452 ticks
```

This converts a distance in mm into a number of pulses, which is the unit of the wheel counter. So the mouse will count up to 3452 to travel 30cm.

#### 1.2 Reading the logs

Three recordings, with `MOTOR_SPEED` at 0, then 130, then 206.

Upload on the Teensy: [xp3_odometry_b.cpp]({{ site.repo }}/algo/xp3_odometry_b.cpp), it sends the heading and the counter to the serial port <br>
Record in CSV: [xp3_log_odometry.py]({{ site.repo }}/algo/xp3_log_odometry.py) <br>
Plot: [xp3_plot_odometry.py]({{ site.repo }}/algo/xp3_plot_odometry.py) <br>

<figure style="margin:0;">
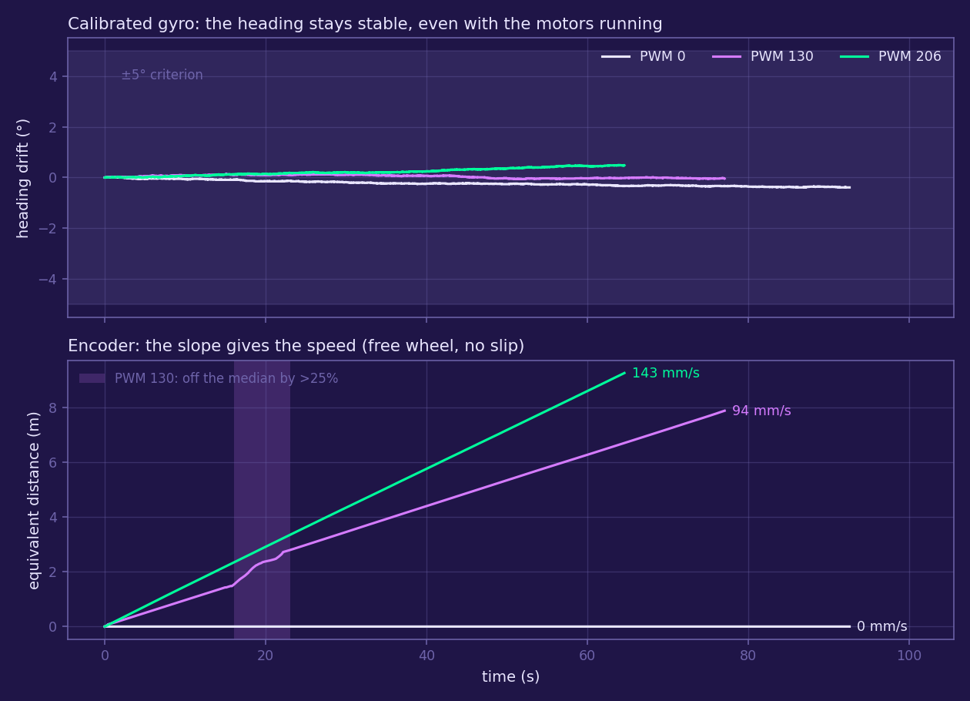
[picture p30: assets/plot_xp/xp_odometry_plot.png]
Heading and distance for three motor speeds
  
  <figcaption style="text-align:center; font-size:0.95rem;">Heading and distance for three motor speeds, after the bias correction. The highlighted zone shows that something released the wheel. Data: [data_xp/odometry]({{ site.repo }}/assets/data_xp/odometry)</figcaption>
</figure>
<br>

For the gyro, the 3 curves stay within the thickness of the line around 0. The maximum drift is 0.48° in 65 s, so 0.007°/s, against the −2°/s read before calibration. The ±5° criterion is met. And the motor noise does not significantly disturb the heading.

For the encoder, the mouse is on a stand and the wheels turn free, so this is the rotation converted into mm and not a real travel. The slope is the forward speed of the wheel, median over 1 s windows: <br>
PWM 130 = 94 mm/s <br>
PWM 206 = 143 mm/s <br>

<br>

All sensors validated on the breadboard. Time to connect everything together and build the mouse.

<br>

[^1]: [Pololu — Quadrature encoders](https://www.pololu.com/docs/0J83/5.4)
[^2]: [Calculating Wheel Odometry for a Differential Drive Robot](https://automaticaddison.com/calculating-wheel-odometry-for-a-differential-drive-robot/)

<details class="appendix" markdown="1">
<summary>Appendix A — plan B with the PMW3901, not used in the end</summary>

Material: <br>
. 1-2 simple N20 motors (no encoder) <br>
. driver TB6612FNG <br>
. PMW3901 optical flow sensor + mast (≥80 mm above the ground) <br>

The PMW3901 needs enough light and a minimum height (≥80 mm) to focus, and it also drifts over long distances.

<figure style="margin:0;">
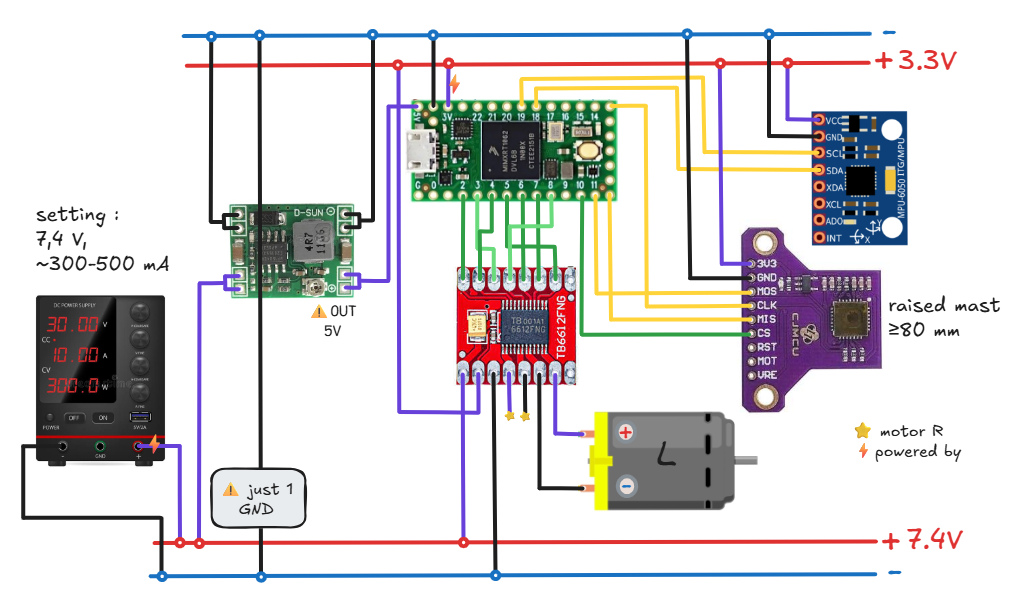
[picture p31: assets/img/xp_odometre_B.png]
  
  <figcaption style="text-align:center; font-size:0.95rem;">Schematic to wire the components of the experiment with PMW3901</figcaption>
</figure>
<br>

The idea was the same as with the wheel encoders: use it together with the gyro instead of trusting one sensor alone. PMW3901 for the distance, gyro for the heading, each one doing what it does best.
</details>
