lili-lines/ratatouille/index.md

---
layout: home
title: Micromouse
---

Micromouse with Analog Whiskers. Project posts, step by step. <br>

<a href="https://sites.google.com/gm.lhu.edu.tw/tmirc2026/News?authuser=0" target="_blank" rel="noopener"
   style="text-decoration:none; border-bottom:1px solid #a21caf;">🏁 TMIRC 2026 link contest</a>

<figure style="margin:0;">
  maze
</figure>
