lili-lines/ratatouille/assets/img/river/river_back2.pdf

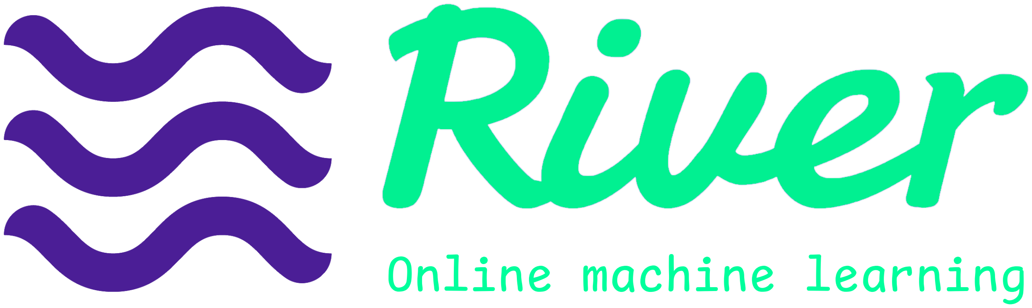
[picture p34: figure]
Online machine learning

from river import model
for x, y in stream:

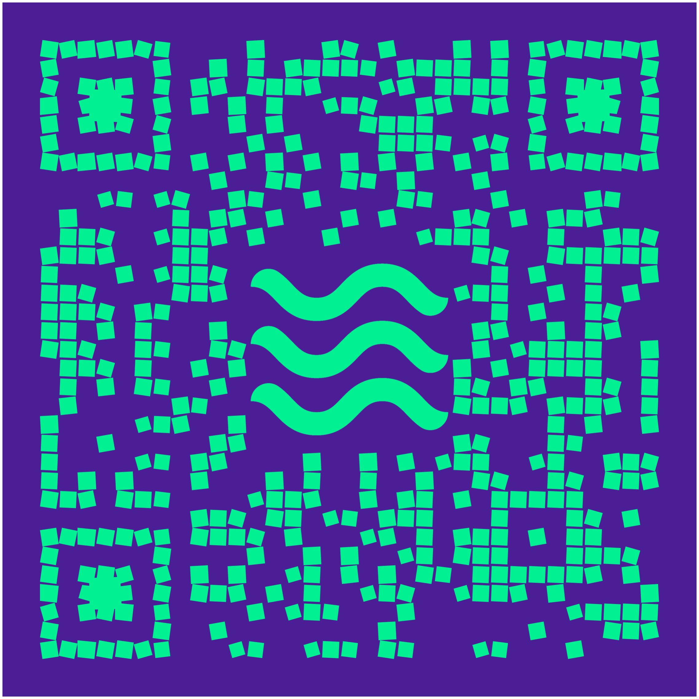
[picture p35: figure]

model.predict_one(x) | # learn
model.learn_one(x, y) | # forever

python & rust
