lili-lines/ratatouille/assets/img/river/river_front2.pdf

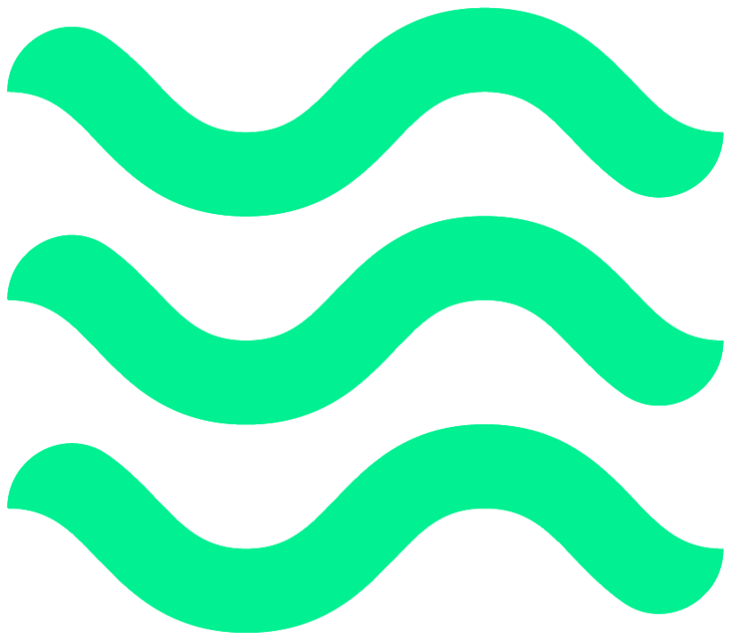
[picture p36: figure]
