lili-lines/ratatouille/as5600_3Dprint.gif

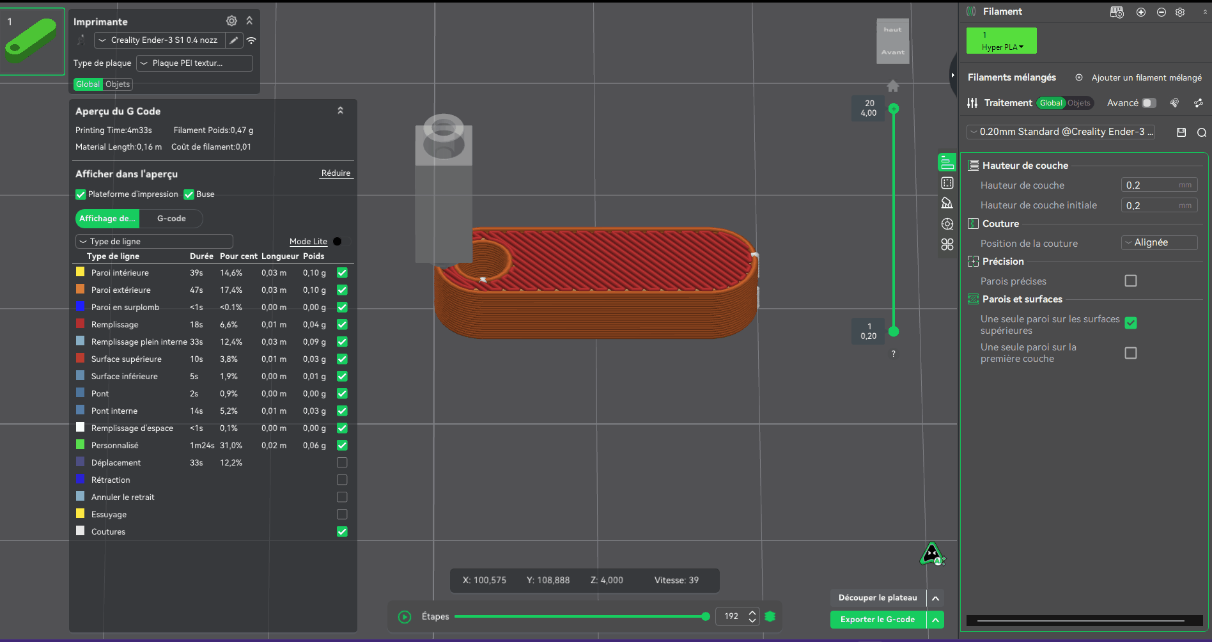
as5600_3Dprint.gif
