lili-lines/ratatouille/assets/img/alim_labo.jpg

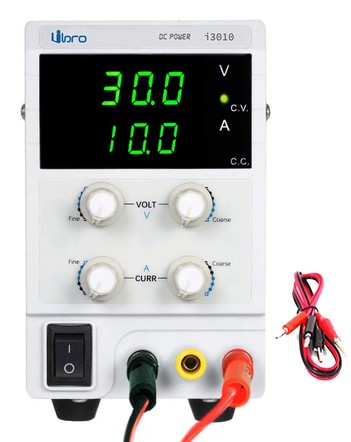
assets/img/alim_labo.jpg
