lili-lines/ratatouille/assets/img/arduino_xp_gyro.jpg

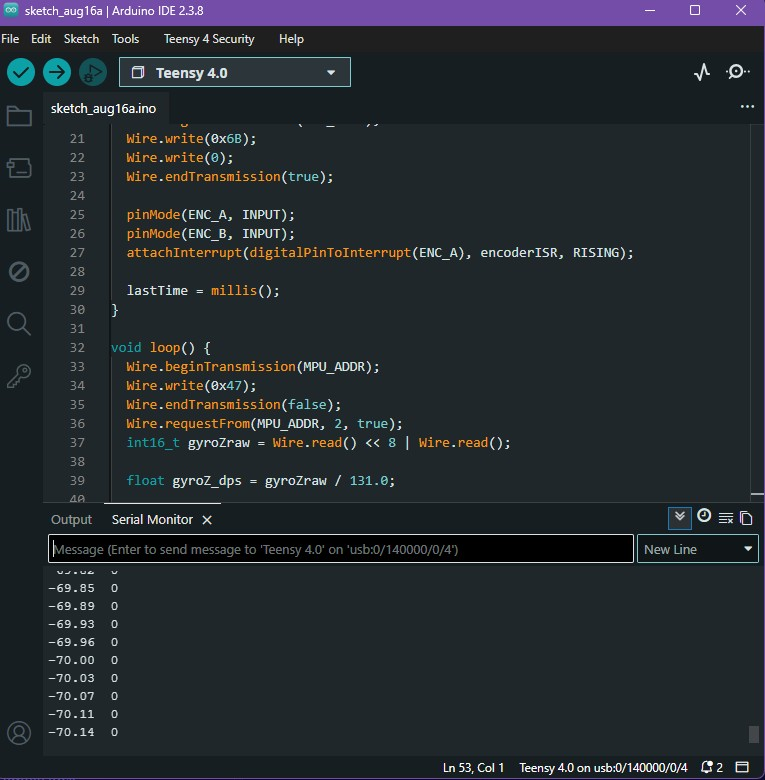
assets/img/arduino_xp_gyro.jpg
