lili-lines/ratatouille/assets/img/as56_soudure.png

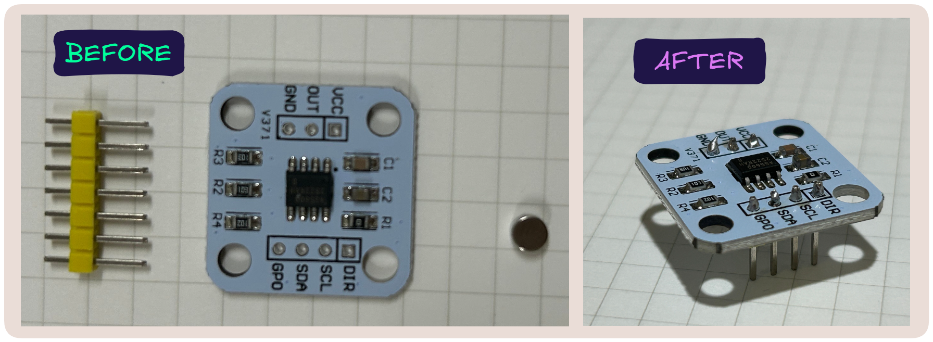
assets/img/as56_soudure.png
