lili-lines/ratatouille/assets/img/as5600.jpg

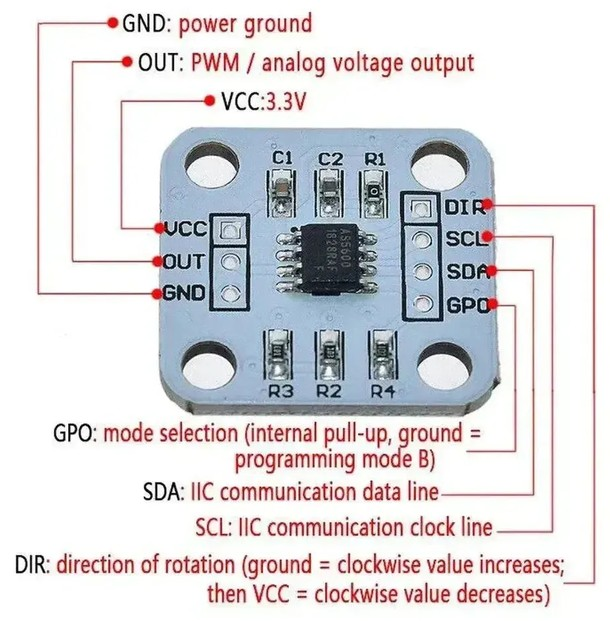
assets/img/as5600.jpg
