lili-lines/ratatouille/assets/img/AS5600_angle.png

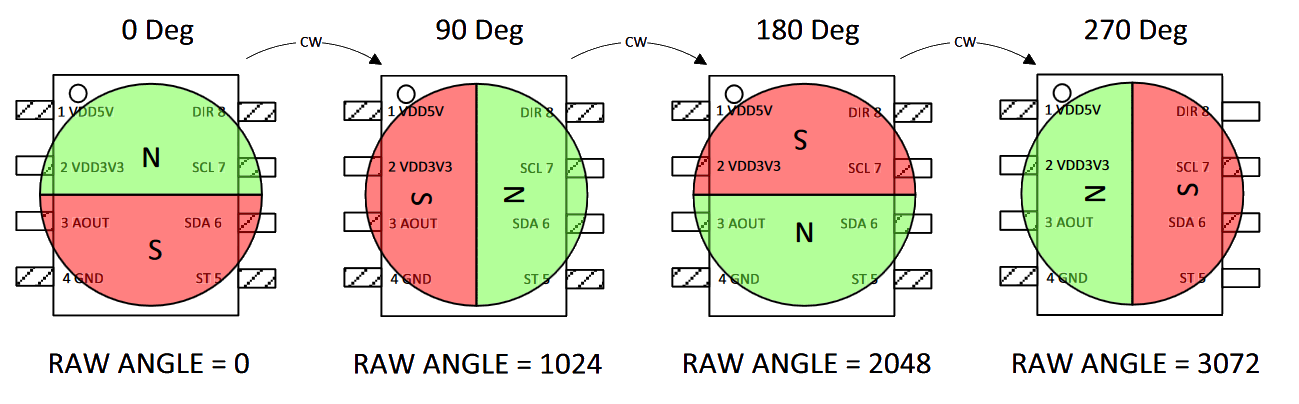
assets/img/AS5600_angle.png
