lili-lines/ratatouille/assets/img/battery_lipo.jpg

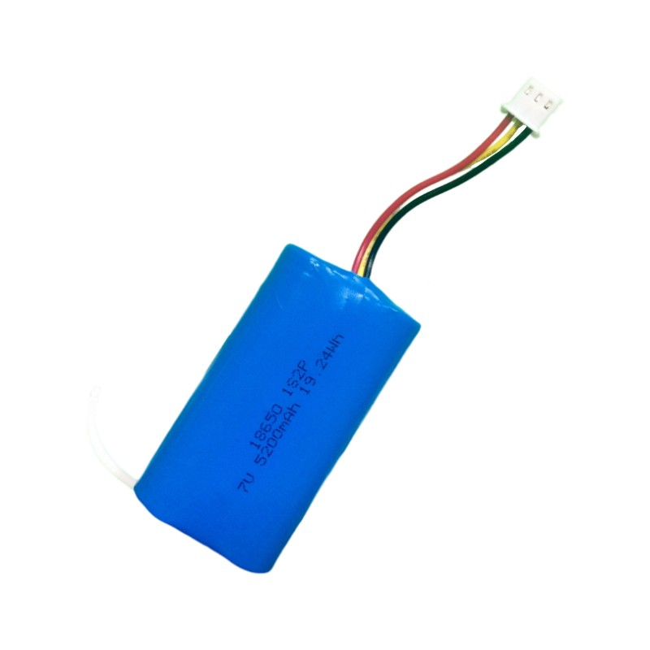
assets/img/battery_lipo.jpg
