lili-lines/ratatouille/assets/img/breadboard.jpg

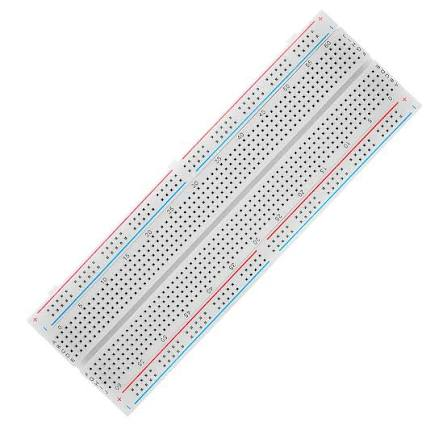
assets/img/breadboard.jpg
