lili-lines/ratatouille/assets/img/check_system_lecture.gif

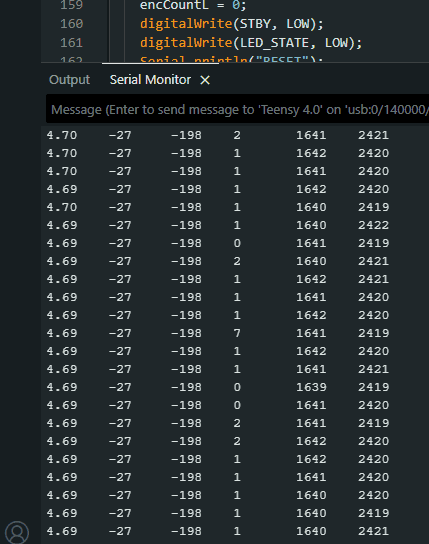
assets/img/check_system_lecture.gif
