lili-lines/ratatouille/assets/img/condensateur.jpg

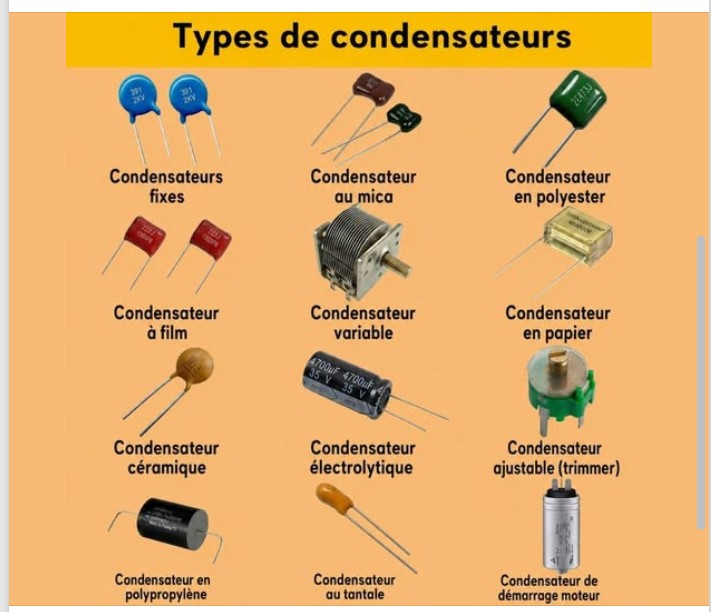
assets/img/condensateur.jpg
