lili-lines/ratatouille/assets/img/condensateur_reservoir470uF25V.jpg

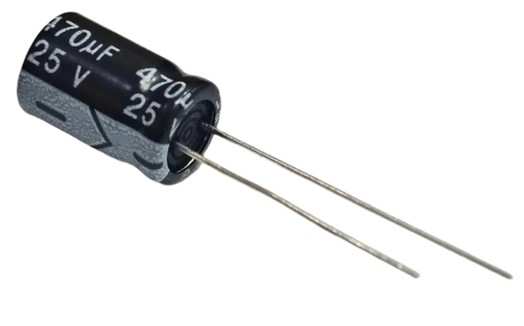
assets/img/condensateur_reservoir470uF25V.jpg
