lili-lines/ratatouille/assets/img/driver_schema.jpg

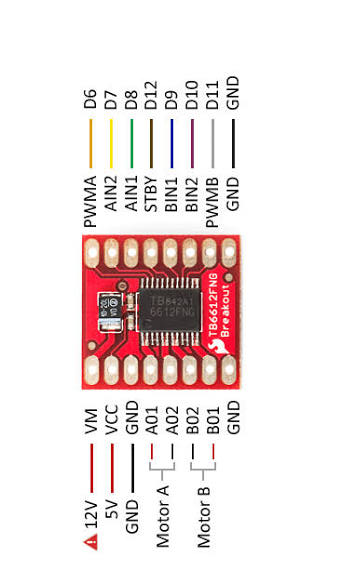
assets/img/driver_schema.jpg
