lili-lines/ratatouille/assets/img/driver_schema_h.jpg

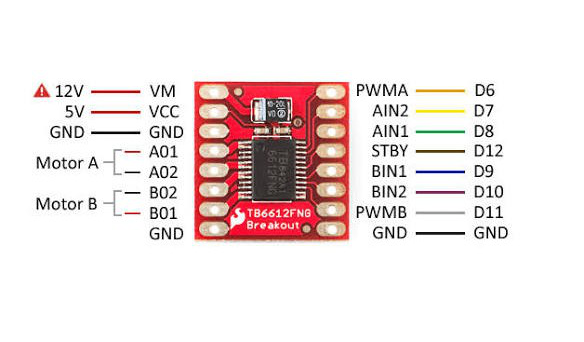
assets/img/driver_schema_h.jpg
