lili-lines/ratatouille/assets/img/driver_soudure.png

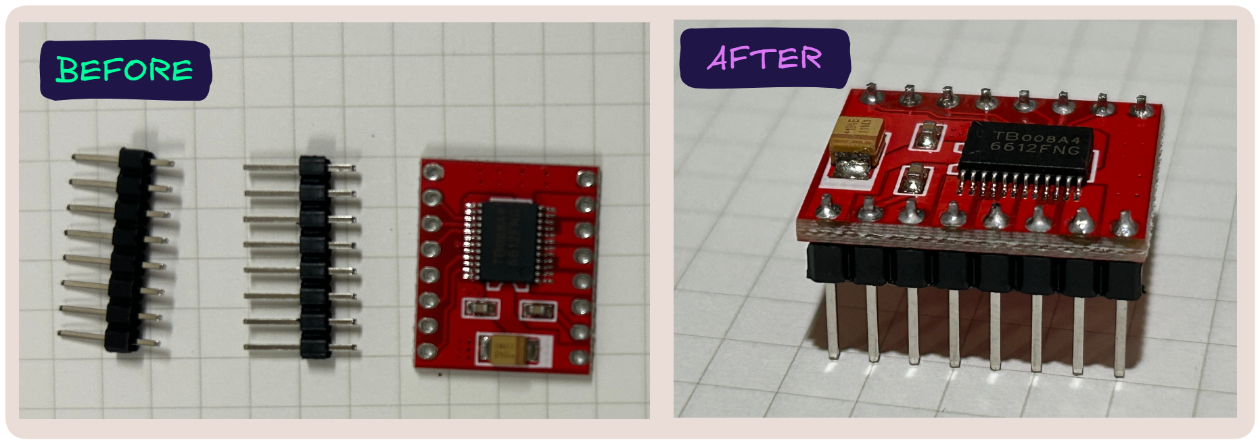
assets/img/driver_soudure.png
