lili-lines/ratatouille/assets/img/ecran_arduino2.jpg

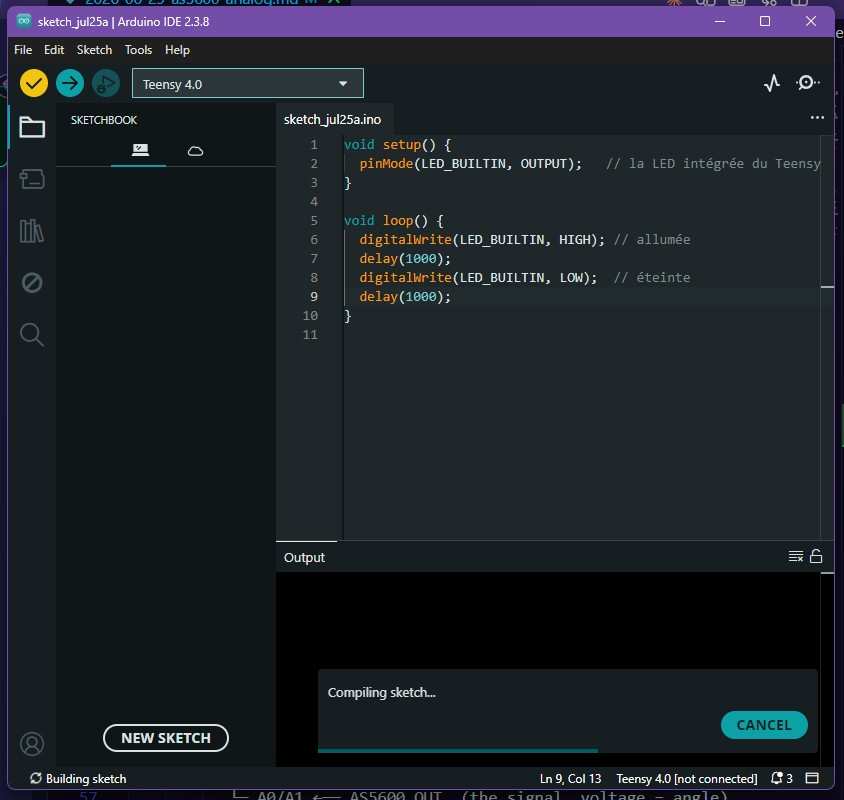
assets/img/ecran_arduino2.jpg
