lili-lines/ratatouille/assets/img/ecran_arduino.jpg

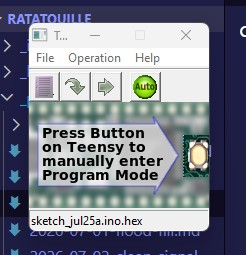
assets/img/ecran_arduino.jpg
