lili-lines/ratatouille/assets/img/exemple_board_schema.jpg

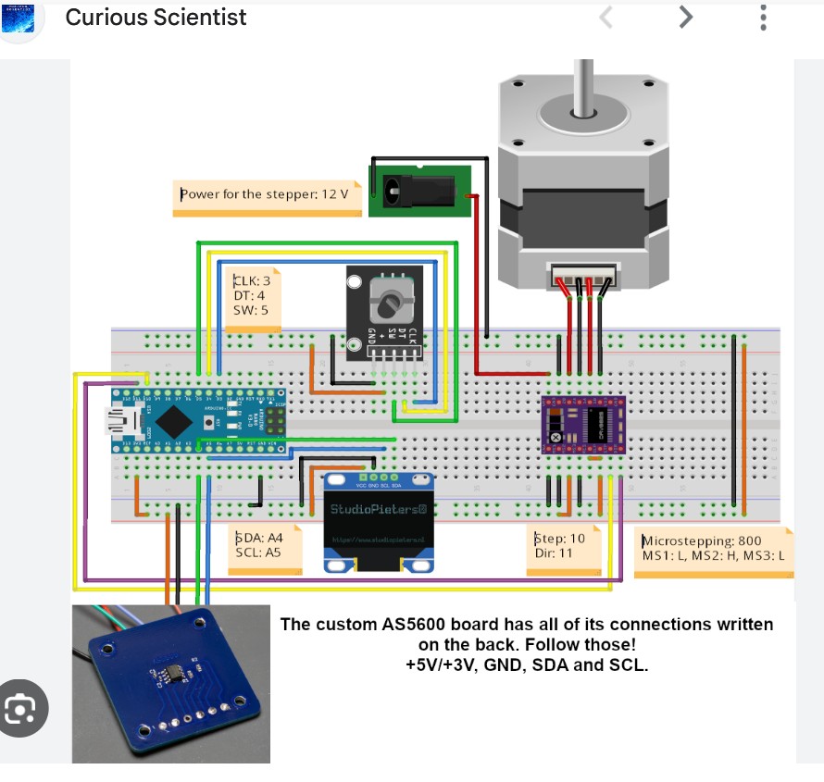
assets/img/exemple_board_schema.jpg
