lili-lines/ratatouille/assets/img/gyro_soudure.png

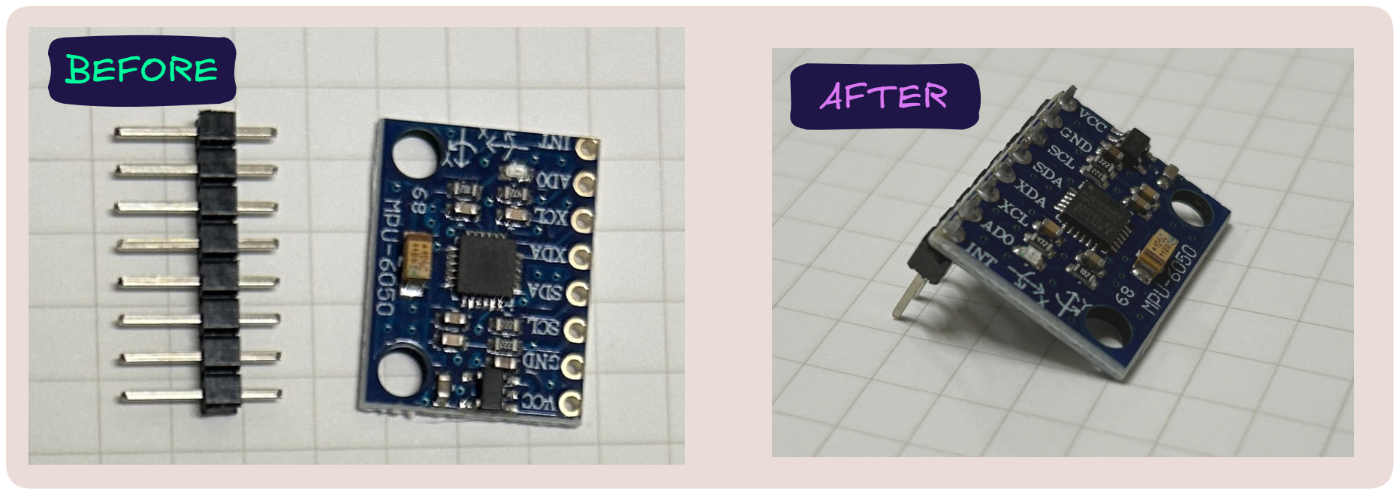
assets/img/gyro_soudure.png
