lili-lines/ratatouille/assets/img/IMG_8894.jpg

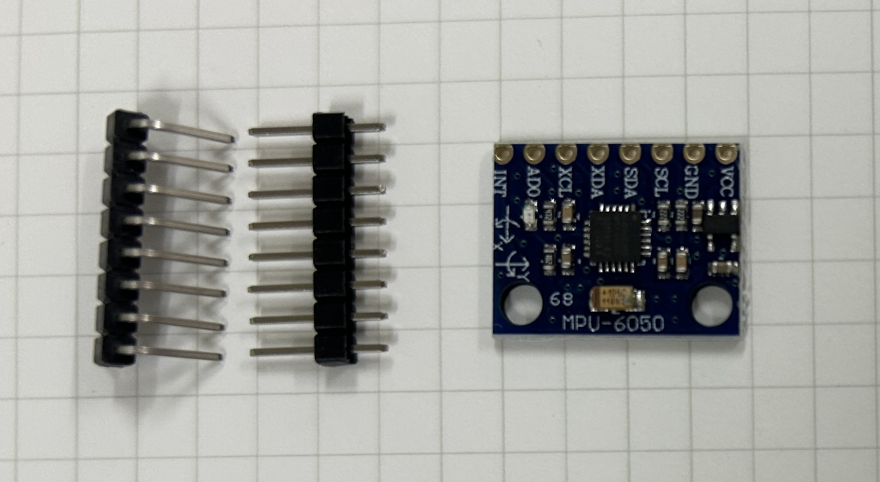
assets/img/IMG_8894.jpg
