lili-lines/ratatouille/assets/img/IMG_8901.jpg

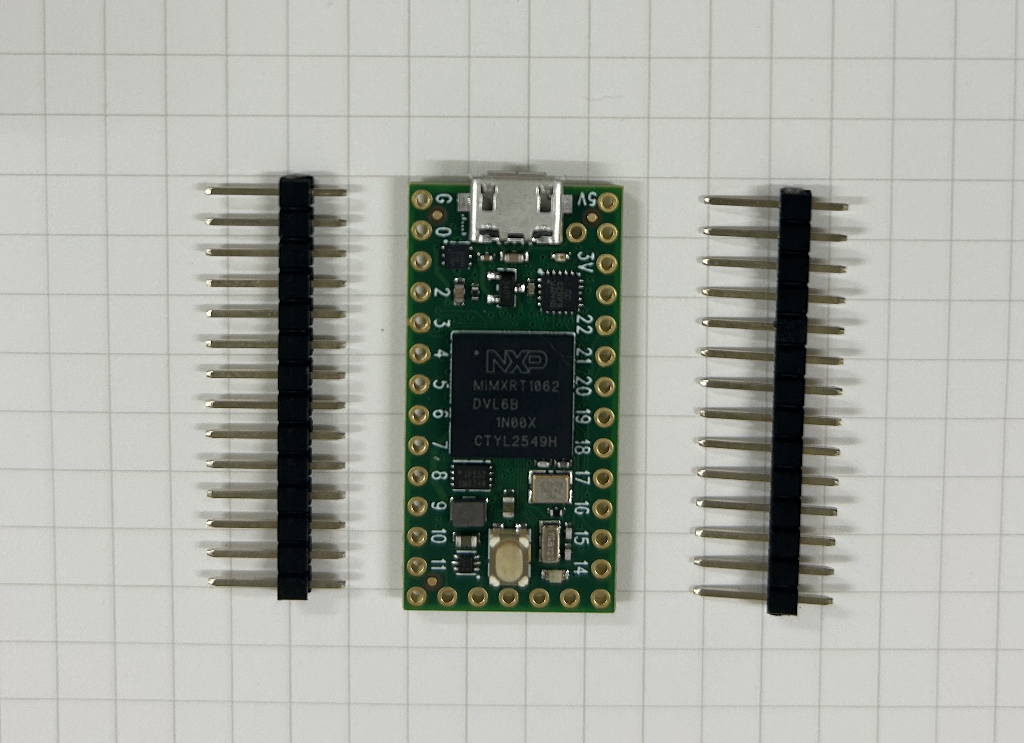
assets/img/IMG_8901.jpg
