lili-lines/ratatouille/assets/img/IMG_8908.jpg

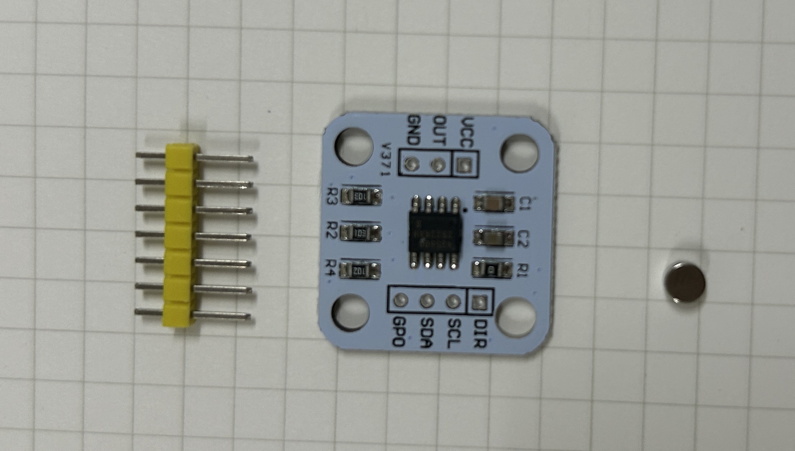
assets/img/IMG_8908.jpg
