lili-lines/ratatouille/assets/img/IMG_8918.jpg

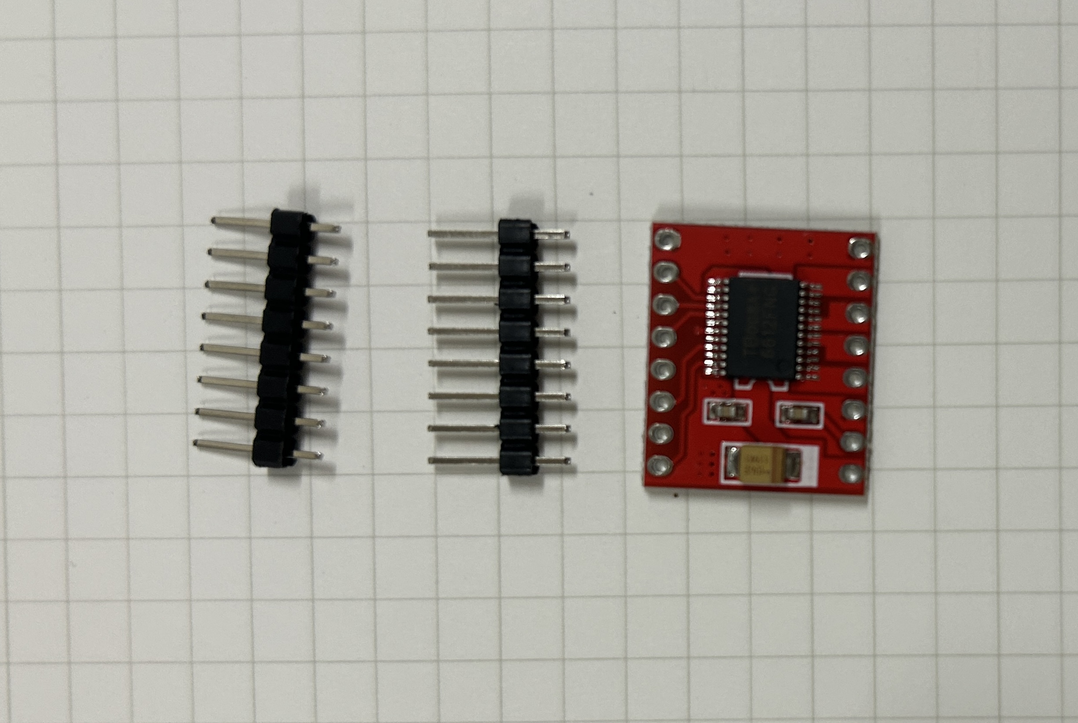
assets/img/IMG_8918.jpg
