lili-lines/ratatouille/assets/img/IMG_8960.JPG

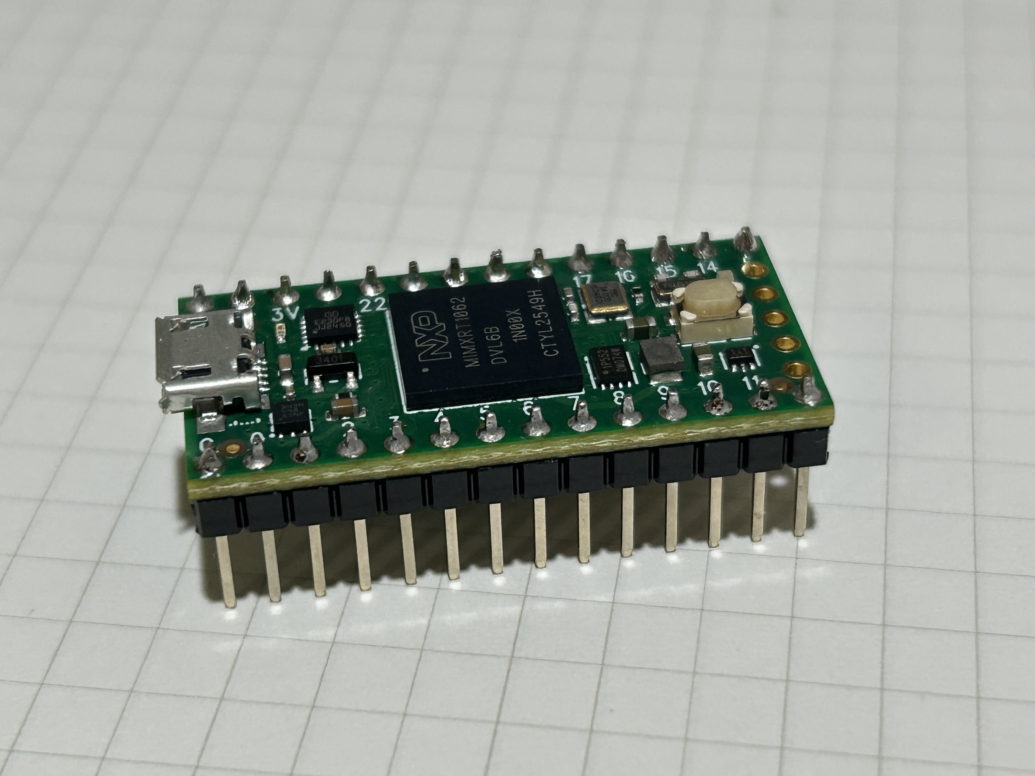
assets/img/IMG_8960.JPG
