lili-lines/ratatouille/assets/img/IMG_8961.JPG

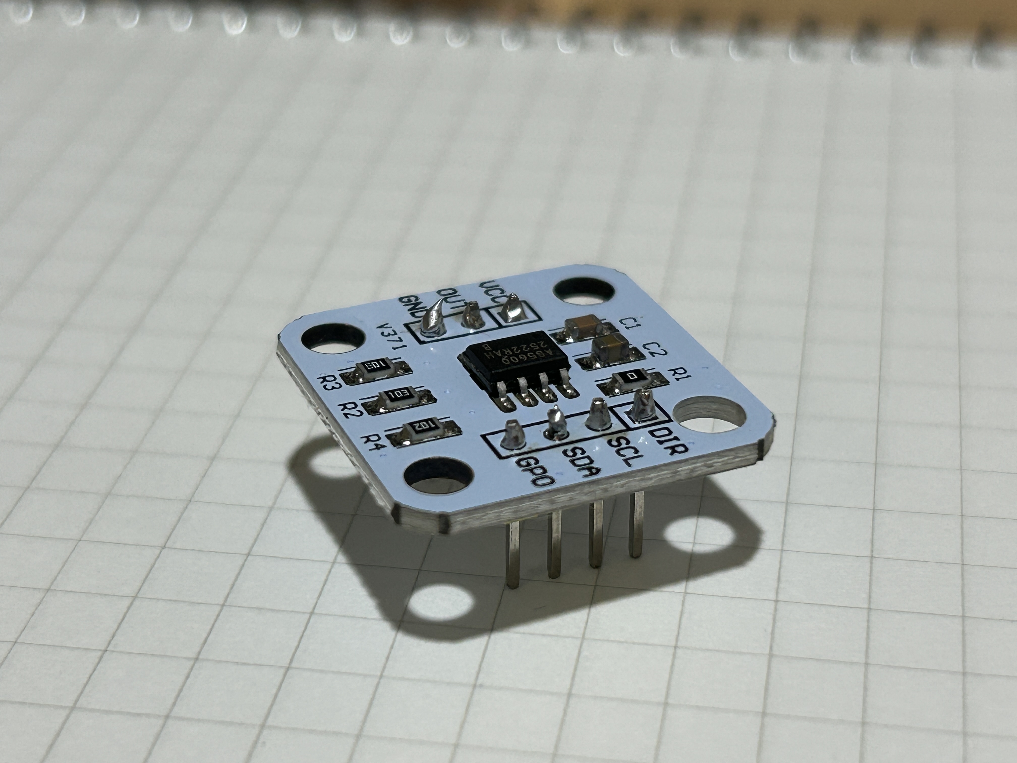
assets/img/IMG_8961.JPG
