lili-lines/ratatouille/assets/img/IMG_8962.jpg

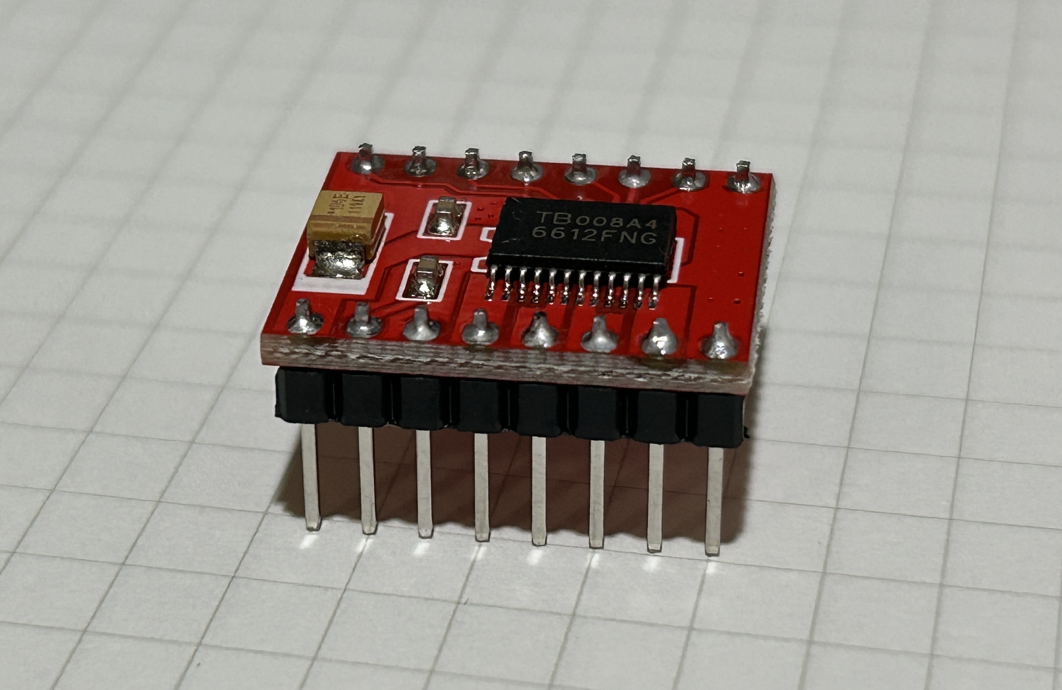
assets/img/IMG_8962.jpg
