lili-lines/ratatouille/assets/img/IMG_9719.JPG

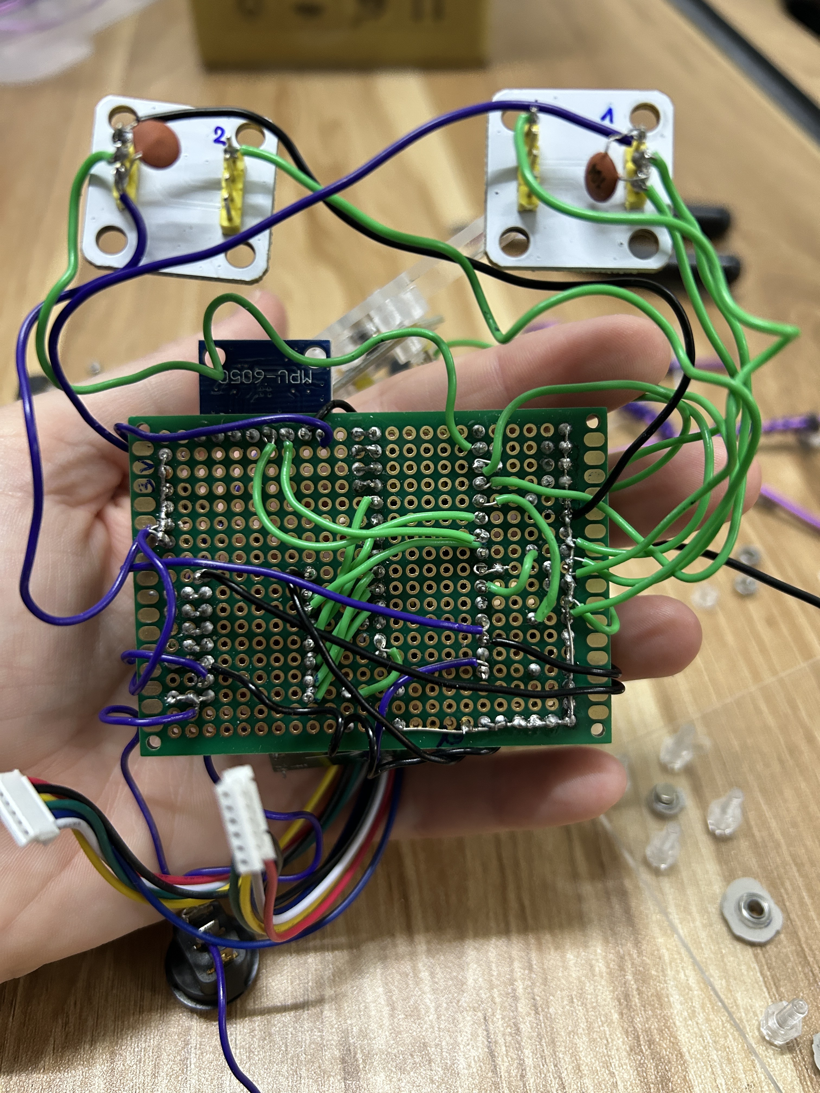
assets/img/IMG_9719.JPG
