lili-lines/ratatouille/assets/img/LiPo.jpg

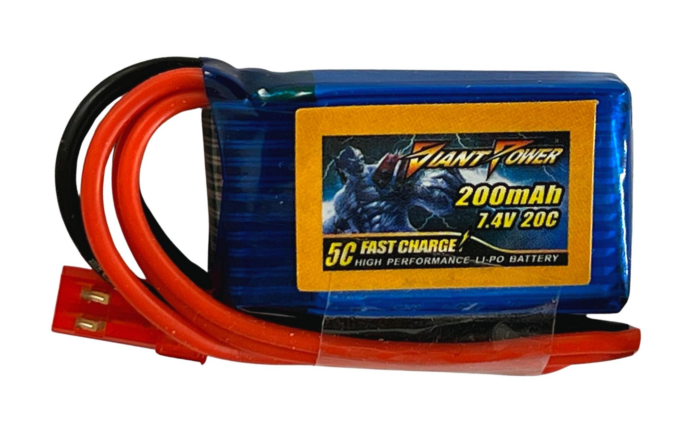
assets/img/LiPo.jpg
