lili-lines/ratatouille/assets/img/micorusb.jpg

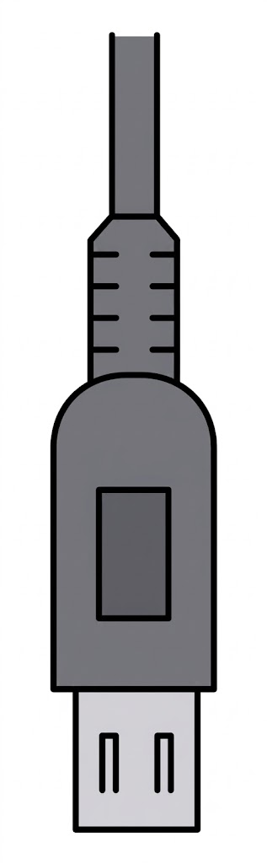
assets/img/micorusb.jpg
