lili-lines/ratatouille/assets/img/micro_ball.jpg

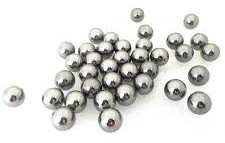
assets/img/micro_ball.jpg
