lili-lines/ratatouille/assets/img/micro_sd_module.jpg

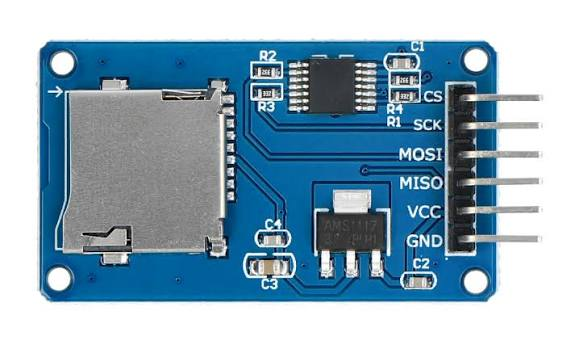
assets/img/micro_sd_module.jpg
