lili-lines/ratatouille/assets/img/micro_spring.png

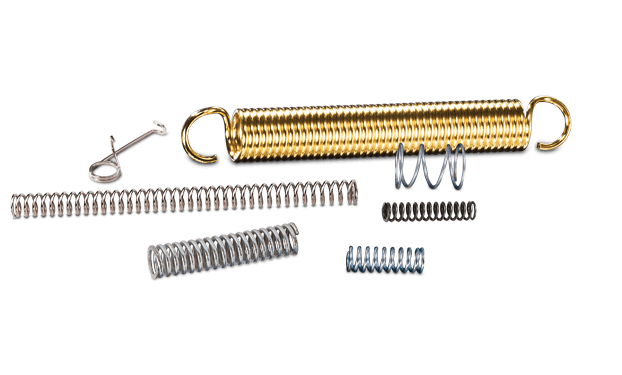
assets/img/micro_spring.png
