lili-lines/ratatouille/assets/img/motorN20.jpg

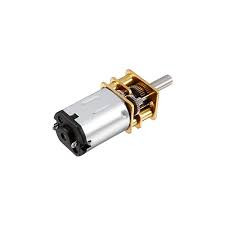
assets/img/motorN20.jpg
