lili-lines/ratatouille/assets/img/moustache.png

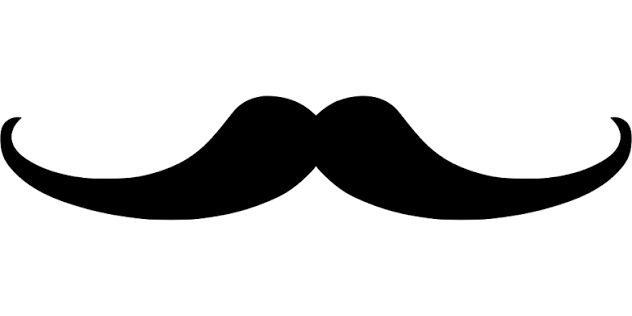
assets/img/moustache.png
