lili-lines/ratatouille/assets/img/MR63_bearing.jpg

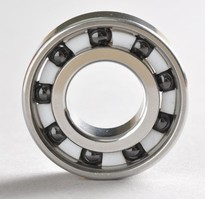
assets/img/MR63_bearing.jpg
