lili-lines/ratatouille/assets/img/N20-Gear-motor_encoder_pinout_3.jpg

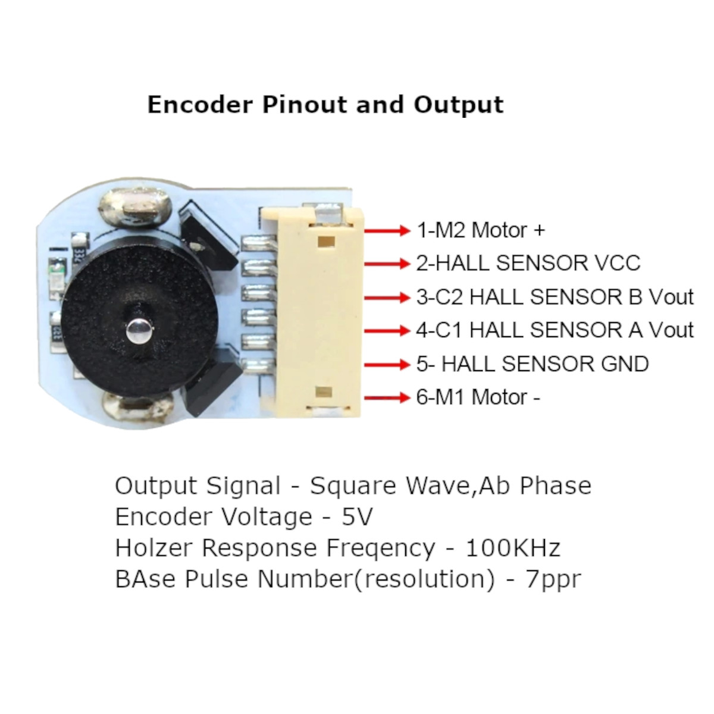
assets/img/N20-Gear-motor_encoder_pinout_3.jpg
