lili-lines/ratatouille/assets/img/pandas.gif

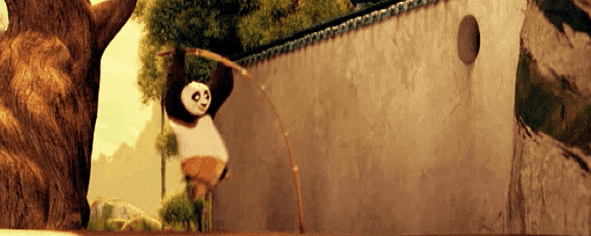
assets/img/pandas.gif
