lili-lines/ratatouille/assets/img/PMW3901_schema.png

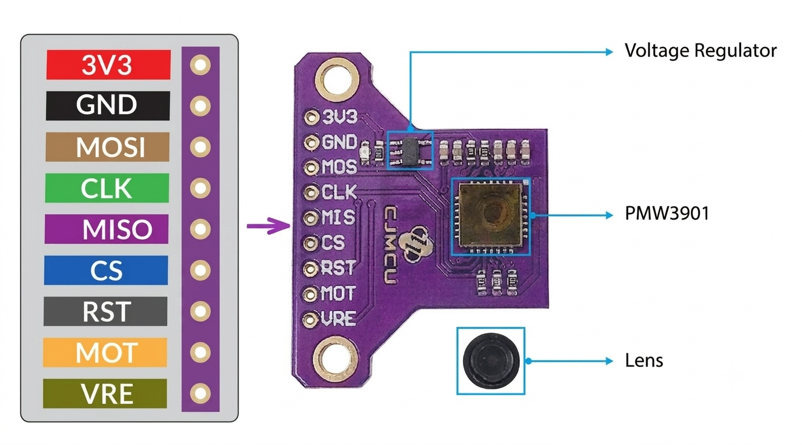
assets/img/PMW3901_schema.png
