lili-lines/ratatouille/assets/img/river/app_3Dprint_river.gif

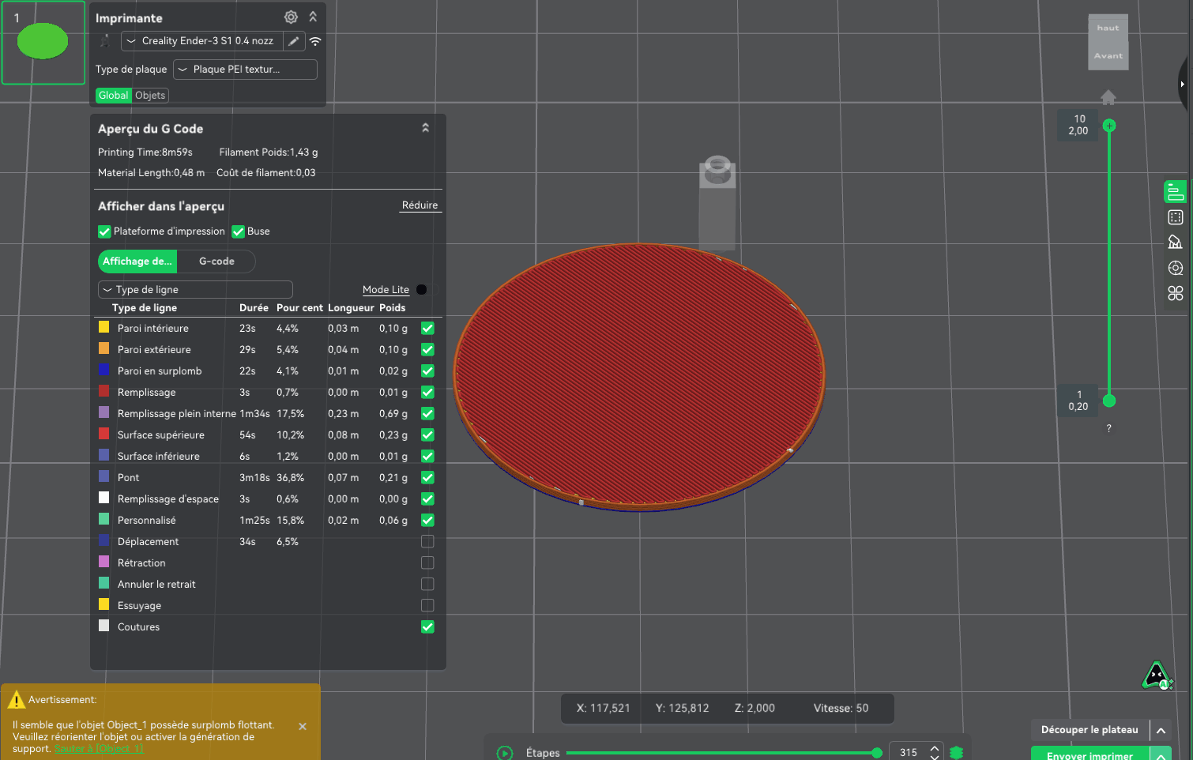
assets/img/river/app_3Dprint_river.gif
