lili-lines/ratatouille/assets/img/river/https_riverml_citron.png

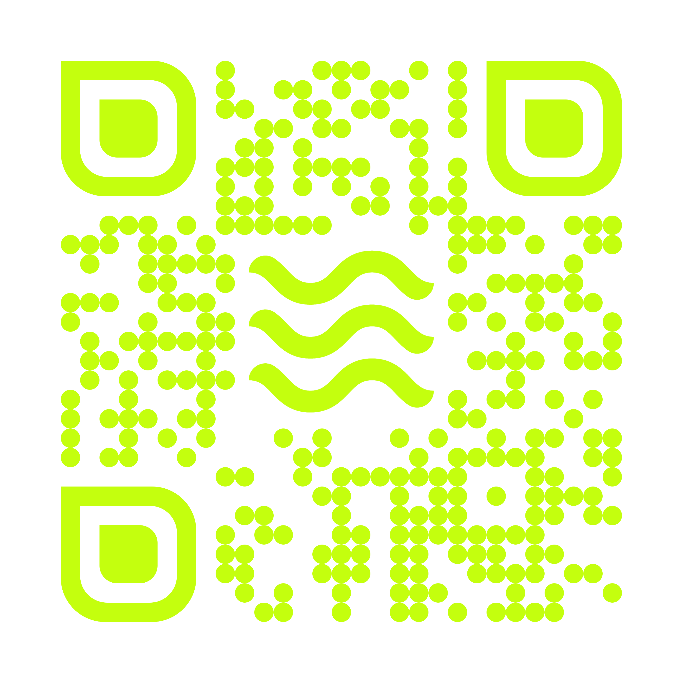
assets/img/river/https_riverml_citron.png
