lili-lines/ratatouille/assets/img/river/river.png

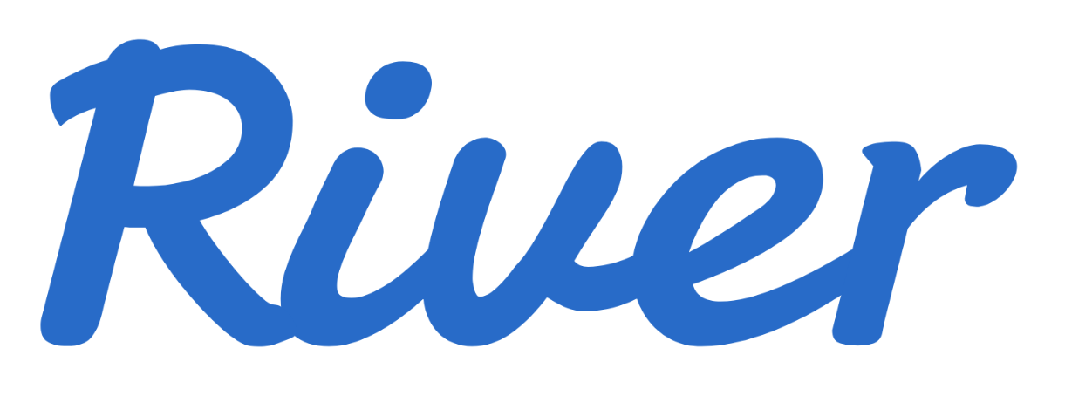
assets/img/river/river.png
