lili-lines/ratatouille/assets/img/river/river_trans - Copie (2) - Copie.png

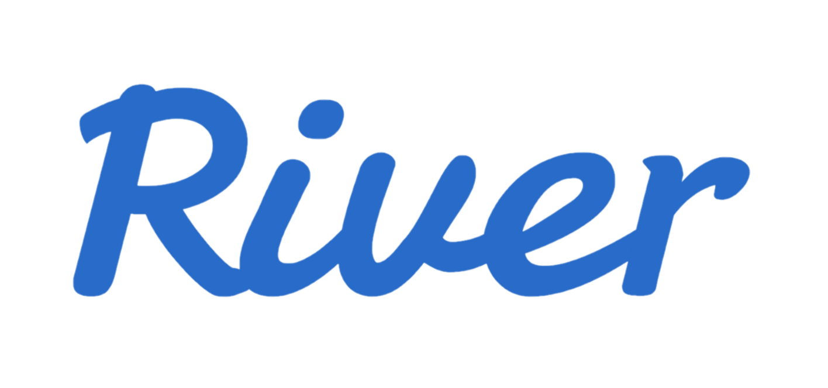
assets/img/river/river_trans - Copie (2) - Copie.png
