lili-lines/ratatouille/assets/img/Résistance_1kΩ.jpg

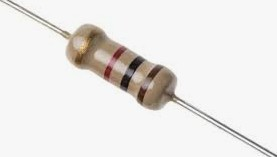
assets/img/Résistance_1kΩ.jpg
