lili-lines/ratatouille/assets/img/Résistance_1kΩ_schema.jpg

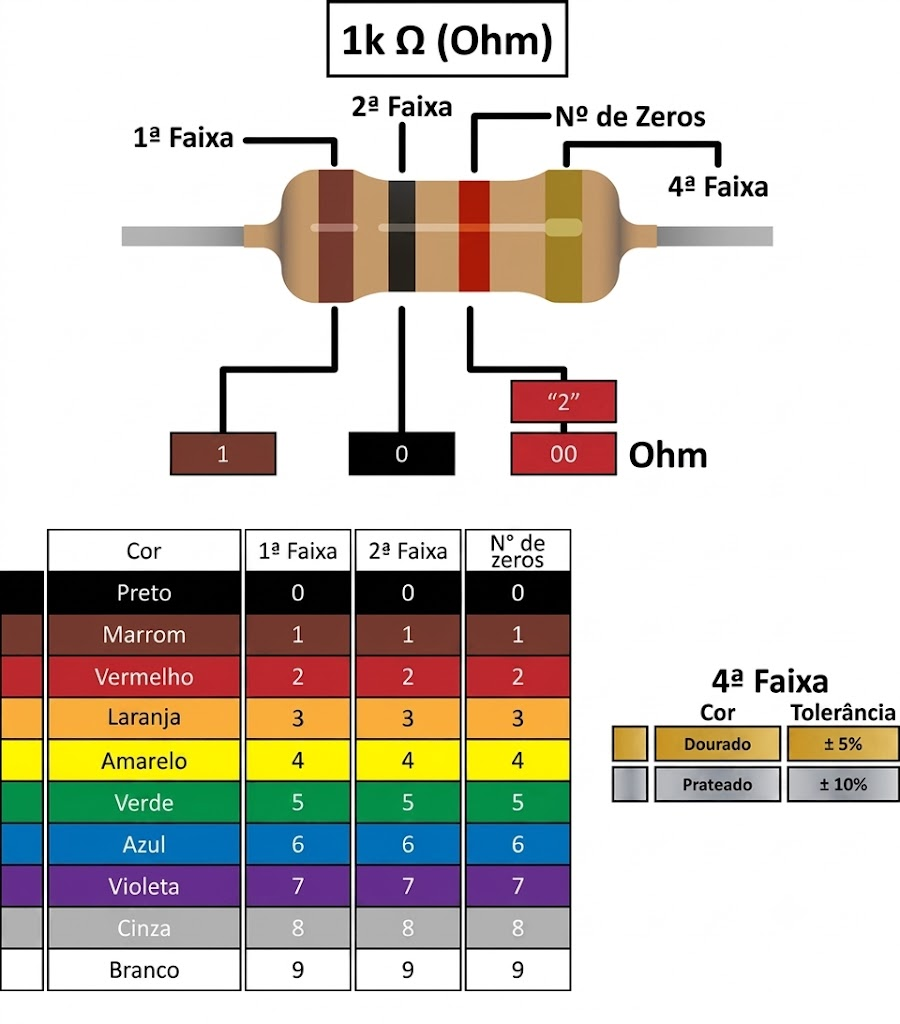
assets/img/Résistance_1kΩ_schema.jpg
