lili-lines/ratatouille/assets/img/shema_moustache.png

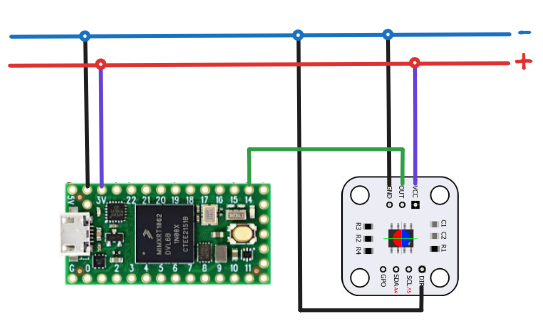
assets/img/shema_moustache.png
