lili-lines/ratatouille/assets/img/teensy.png

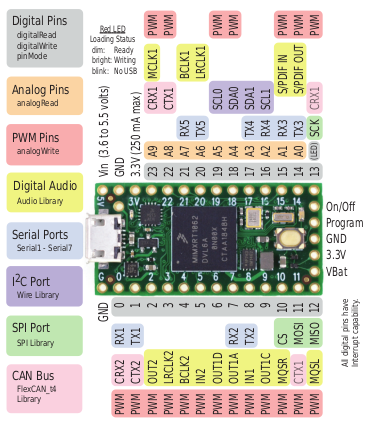
assets/img/teensy.png
