lili-lines/ratatouille/assets/img/teensy_soudure.png

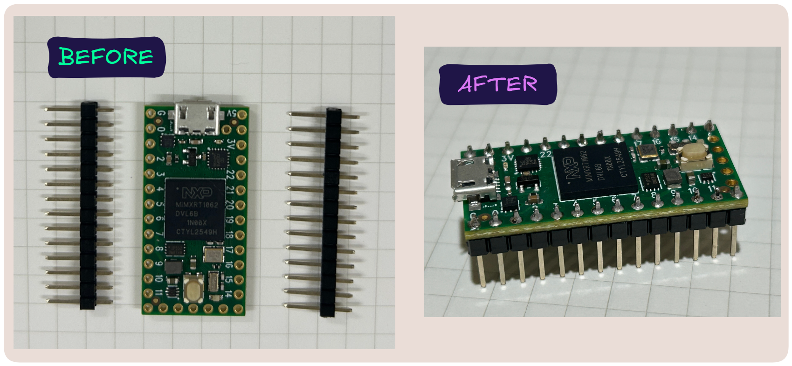
assets/img/teensy_soudure.png
