lili-lines/ratatouille/assets/img/vis.png

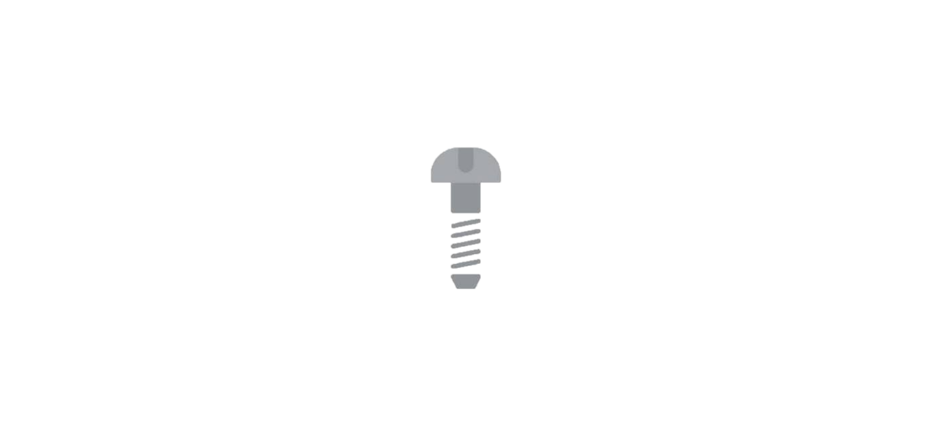
assets/img/vis.png
