lili-lines/ratatouille/assets/img/vis_ecrou.png

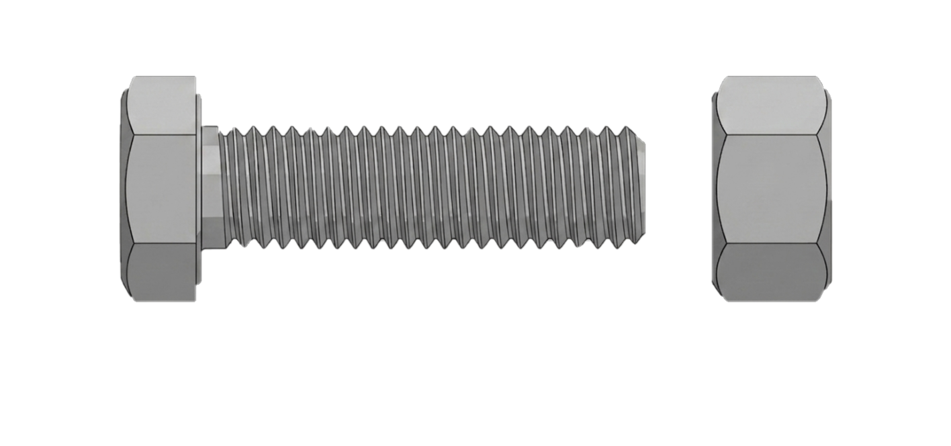
assets/img/vis_ecrou.png
