lili-lines/ratatouille/assets/plot_xp/xp_stats_table_12bit.png

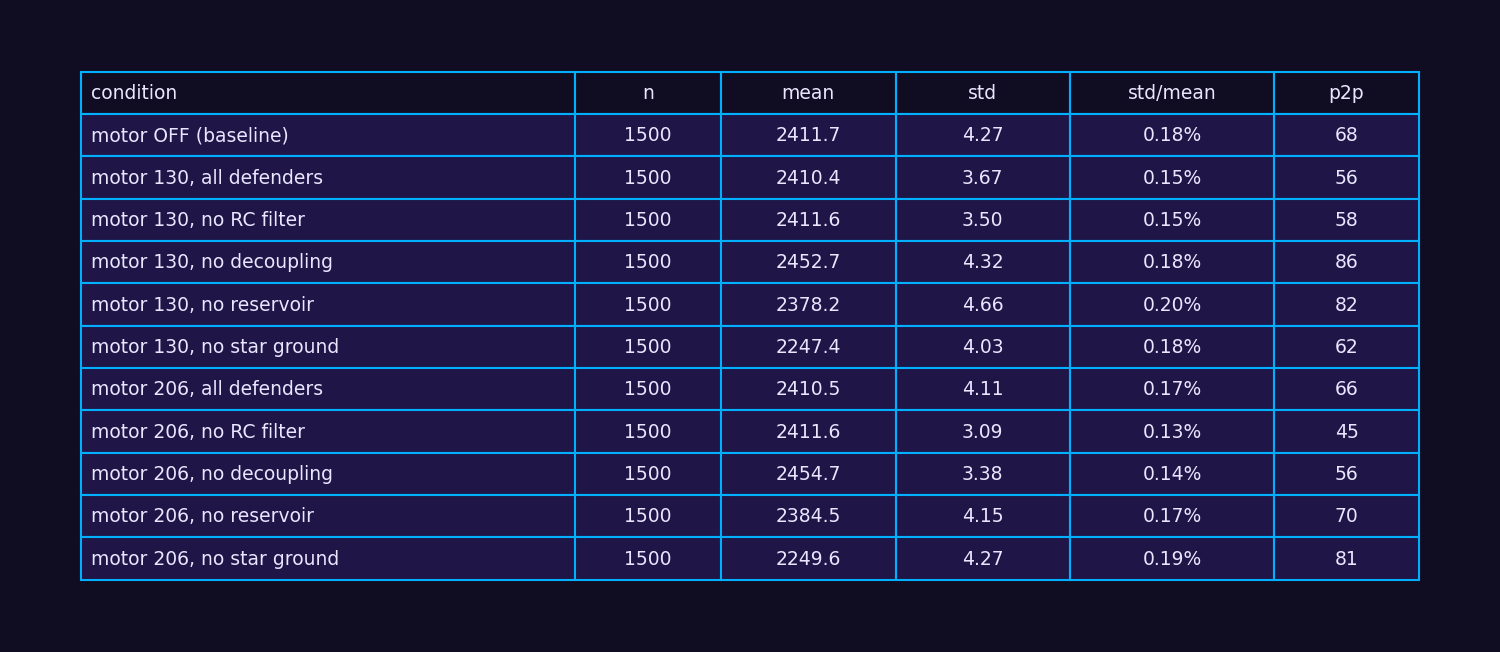
assets/plot_xp/xp_stats_table_12bit.png
