lili-lines/ratatouille/_posts/2026-06-28-bom.md

---
layout: post
title: Bill of Materials (BOM)
date: 2026-06-28 08:00:00 +0200
tags: [electronics, hardware]
---

* TOC
{:toc}

Every component of the analog whisker mouse, chosen with the takeaways above in mind, plus the equipment for the experiments.

Legend : ⚠ attention, 🛈 info, → OUT, ← IN

## 1. Ratatouille anatomy 🐭

#### 1.1 Brain

<div style="display:flex; gap:16px;" markdown="1">
<div class="bom-col" markdown="1">
**MCU** <br>
Teensy 4.0, 35×18 mm, ←5V →3.3V →sensors, 0.1A, ~3g <br>
**⚠** power VIN 3.6–5.5V, logic NOT 5V-tolerant <br>
**🛈** logic = signals/info & power = energy

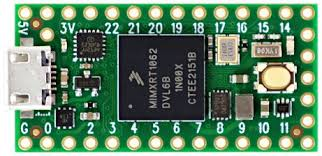
[picture p86: assets/img/teensy40.jpg]
Teensy 4.0

</div>
<div class="bom-col" markdown="1">
**Buck** <br>
MP1584, 22×17 mm, ←7.4V →5V →Teensy VIN, 0.02A core, ~2g <br>
**⚠** 5V to be set with a multimeter

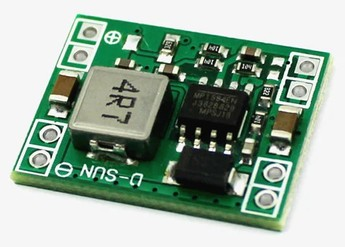
[picture p87: assets/img/MP1584.jpg]
MP1584 buck

</div>
</div>
<br>

**Σ $A$ (1.1) brain = 0.12 $A$**

#### 1.2 Movement
Listed in the order energy flows to the ground. <br>
driver → motors → wheels

<div style="display:flex; gap:16px; align-items:center;" markdown="1">
<div style="flex:1;" markdown="1">
**Driver** <br>
TB6612FNG 2 H-bridge, 20×15mm, 0.01A logic, 2g <br>
**⚠** 1.2A continuous, 3.2A peak per motor, STBY = HIGH 3.3V <br>
**🛈** chopped = on/off fast
</div>
<div style="flex:1;" markdown="1">

|IN | OUT |
| <small>VM 7.4V ← switch, <br> VCC 3.3V + PWM ← Teensy </small> | <small>chopped 7.4V → motors ×2</small> |

</div>
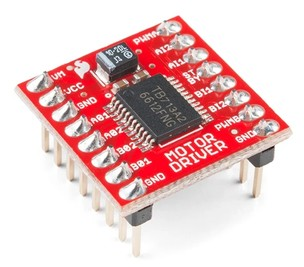
[picture p88: assets/img/driver.jpg]
TB6612FNG driver

</div>

<div style="display:flex; gap:16px; align-items:center;" markdown="1">
<div style="flex:1;" markdown="1">
**Motors** <br>
N20 ×2, 6V-3A, ~50–100:1, hall encoder, 12g <br>
**🛈** 6V → keep the PWM duty ~81 % ⇔ 7.4 × 0.81 = 6V <br>
hall encoder = the magnetic revolution counter, torque=power, quadrature=signal
</div>
<div style="flex:1;" markdown="1">

|IN | OUT |
| <small>chopped 7.4V ← driver (means ~6V)</small> | <small>torque → wheels, quadrature 3.3V → Teensy</small> |

</div>
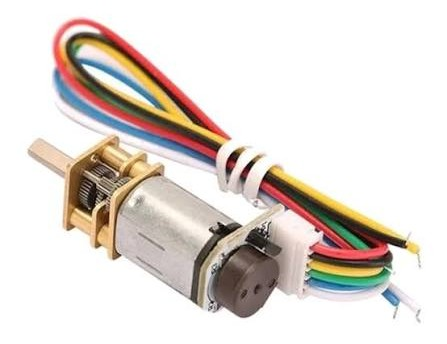
[picture p89: assets/img/motorN20_encoder.jpg]
N20 motor with encoder

</div>

<div style="display:flex; gap:16px;" markdown="1">
<div class="bom-col" markdown="1">
**Wheels** <br>
Wheels ×2, N20 Ø32 mm silicone, 5g each <br>
**🛈** Ø32 mm, circumference → 1 turn ≈ 100 mm → sets the mm per tick for odometry, torque ← motors motion on the floor

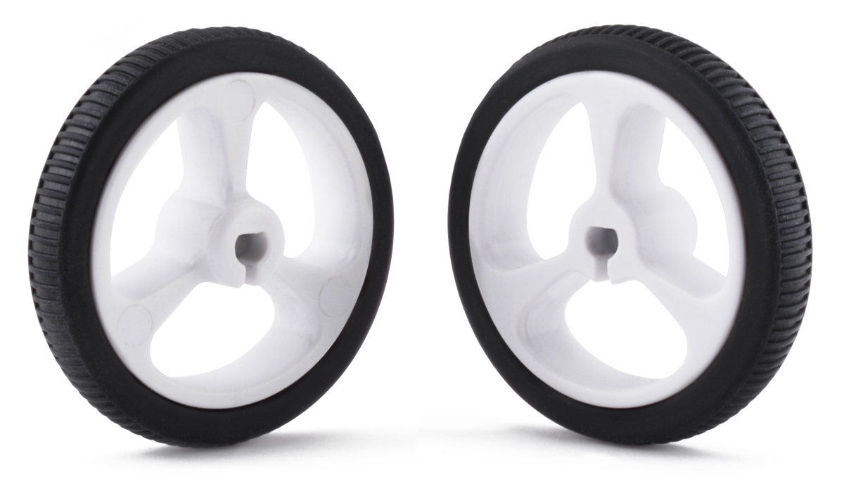
[picture p90: assets/img/wheels.jpg]
Silicone wheels

</div>
<div class="bom-col" style="flex:0.6;" markdown="1">
**Ball caster** <br>
Rear support, 3rd contact point, 4g

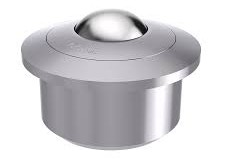
[picture p91: assets/img/ball_caster.jpg]
Ball caster

</div>
</div>
<br>

**Σ $A$ (1.2) movement = 3.01 $A$**

#### 1.3 Analog whiskers
Listed in the order the information travels. <br>
Wall → mechanics → to a number Teensy electric part

<div style="display:flex; gap:16px; align-items:flex-start;" markdown="1">
<figure style="margin:0; flex:1; min-width:0;">
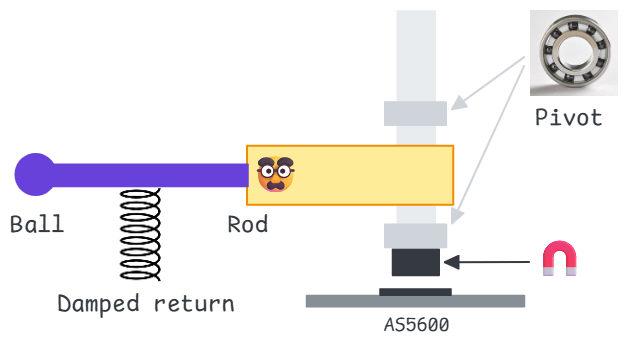
[picture p92: assets/img/whisker_bom.png]
Whisker chain: ball, rod, damped return, pivot, magnet, AS5600
  
</figure>
<div style="flex:0.5; min-width:0;" markdown="1">
**Pivot** MR63 bearing, 3×6×2.5mm, torque ← rod, rotation → magnet, 0.2g <br>
**Micro-ball** Low-friction tip, wall contact, 0.1g <br>
**Whisker rod** alu Ø0.5 mm, force ← tip, torque → pivot, 1g <br>
**🛈** too soft = no signal, too stiff = it pushes the robot away, candidates tested: alu, copper, piano wire, plastic
</div>
</div>

<div style="display:flex; gap:16px; align-items:center;" markdown="1">
<div style="flex:1;" markdown="1">
**Whisker damped return** <br>
micro-spring, rotation ← pivot, 0.1g <br>
**🛈** too strong = the whisker won't bend, too weak = it oscillates
</div>
</div>

<div style="display:flex; gap:16px; align-items:center;" markdown="1">
<div style="flex:1;" markdown="1">
<div style="display:flex; gap:16px; align-items:center;" markdown="1">
<div style="flex:1;" markdown="1">
**Magnetic angle sensor** <br>
AS5600 ×2, 12-bit, module 24×15 mm, 0.03A, 2g
</div>
<div style="flex:1;" markdown="1">

| IN | OUT |
| <small>3V ← Teensy, field ← magnet</small> | <small>analog 0–3.3V → MCU pin ADC/3.3V</small> |

</div>
</div>

**Magnet** <br>
Diametric Ø4 mm, rotation ← pivot, magnetic field → AS5600, 0.2g <br>
**🛈** must be diametrically magnetized, smaller magnet → reduce the air gap to the AS5600 <br>
</div>
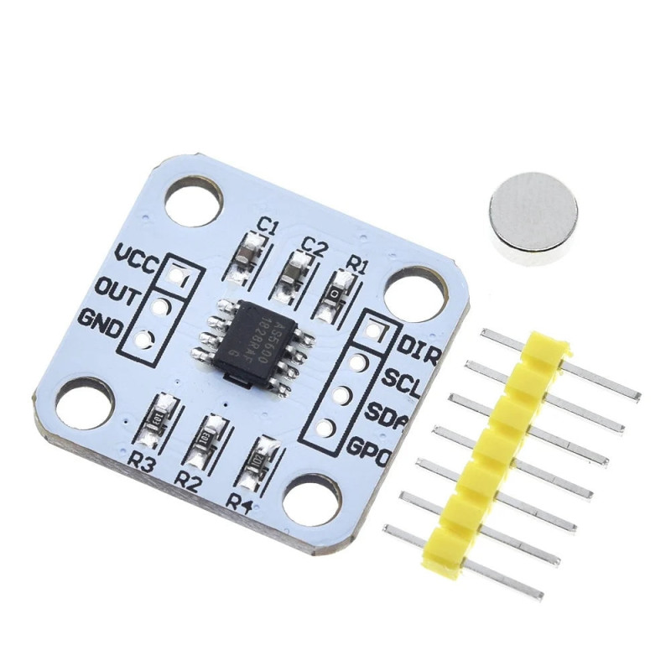
[picture p93: assets/img/sensor_AS5600.jpg]
AS5600 sensor

</div>

**Σ $A$ (1.3) whiskers = 0.03 $A$**

#### 1.4 Inertial sensing
Ratatouille 🐭 needs to know two things: how far it has come, and which way it's looking. So 1 sensor for each. <br>
**🛈** 2 sensors are complementary, the encoders give distance but drift when a wheel slips, while the gyro gives heading but drifts over time. Fusing them gives a stable position + heading.

<div style="display:flex; gap:16px; align-items:center;" markdown="1">
<div style="flex:1;" markdown="1">
**Wheel encoders** <br>
×2, hall, built into the N20 motors, resolution CPR <br>
**🛈** N20 = low resolution, read both channels (A+B) to keep precision, they lie when a wheel slips
</div>
<div style="flex:0.8;" markdown="1">

| IN | OUT |
| <small>3.3V ← Teensy, wheel rotation</small> | <small>quadrature pulses 3.3V → Teensy, 0.02A</small> |

</div>
</div>

<div style="display:flex; gap:16px; align-items:center;" markdown="1">
<div style="flex:1;" markdown="1">
**Gyro / IMU** <br>
MPU-6050 / GY-521, 6-axis gyro + accelerometer, 21×16 mm, 2g <br>
IN: 3.3V ← Teensy <br>
OUT: I2C data 3.3V-0.004A, address 0x68 → Teensy <br>
**🛈** I2C only, no SPI, the gyro drifts slowly over time
</div>
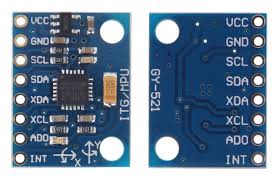
[picture p94: assets/img/gyro_MPU-6050.jpg]
MPU-6050 IMU

</div>

**Σ $A$ (1.4) inertial = 0.024 $A$**

#### 1.5 Structure

**🛈** These parts were designed and 3D printed, but not used in the end. For the v1 the laser-cut acrylic was simpler and faster to iterate on, see [Mechanical Design]({% post_url 2026-08-12-mechanical-design %}). The constraints listed below still apply, whatever the fabrication method.

<div style="display:flex; flex-wrap:wrap; gap:24px; align-items:flex-start;">
<div style="flex:1.5; min-width:260px;">
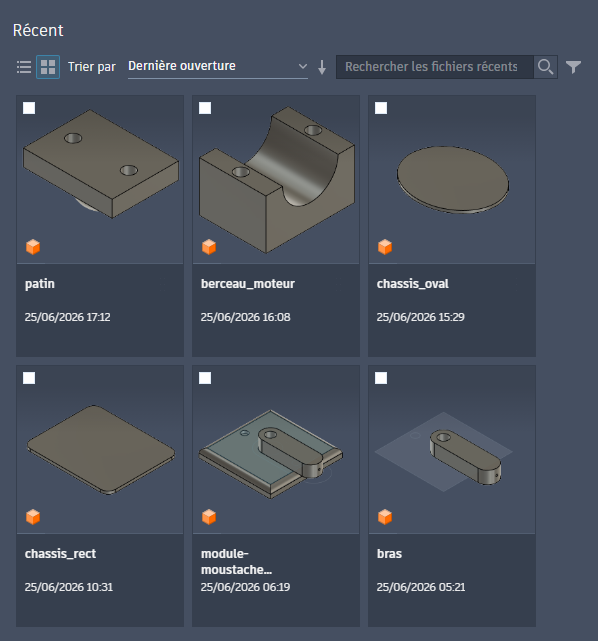
[picture p95: assets/img/3dprint.png]
3D printed parts
  
</div>
<div style="flex:1; min-width:200px;" markdown="1">

| # | Part | Status |
|---|---|---|
| 1 | Base plate | ✅ |
| 2 | Whisker arm | ✅ |
| 3 | Oval chassis | ✅ |
| 4 | Motor brackets ×2 | ✅ |
| 5 | Rear skid | ✅ |

**Motor brackets ×2**: hold the N20 motors, the 2 axes must be parallel and at the same height <br>
**Whisker module ×2**: carry the AS5600 + pivot + magnet, must hold the magnet 0.5–3 mm above the AS5600 centre, on the pivot axis <br>

</div>
</div>

**Chassis**: carries every other part <br>
**Screws**: use nylon nuts, nyloc: plain nuts unscrew themselves with the vibrations <br>
**Wiring**: dupont + perfboard, connects everything <br>

**Σ $A$ (3) chassis = 0 $A$**

## 2. Electronic anatomy

#### 2.1 Power

Total current draw Σ $A$ & total weight Σ g

<div style="display:flex; gap:16px; align-items:flex-start;" markdown="1">
<div style="flex:0.9; min-width:0;" markdown="1">

| Section | Σ $A$ | Σ g |
|---|---|---|
| 1.1 Brain | 0.12 | 5g |
| 1.2 Movement | 3.01 | 40g |
| 1.3 Analog whiskers | 0.03 | 5g |
| 1.4 Inertial sensing | 0.024 | 2g |
| 2.1 Power | — | 52g |
| 2.2 Signal | 0 | 2g |
| 3. Chassis | 0 | 10g |
| **TOTAL (peak)** | **3.2** | **116g** |

</div>
<div style="flex:1; min-width:0;" markdown="1">
The total ~3.2A, that's what sizes the battery C-rating, switch, 2A(T) fuse, wiring. Logic + sensors draw < 0.2A, the motors draw the most current. <br>
At 10C the min is 320 mAh, 0.32Ah × 10 = 3.2A, to have a margin so I look for 500 mAh, 0.5Ah × 10 = 5A max, above the peak.
The supplier only had 800 mAh, a comfortable margin and more runtime. <br>
</div>
</div>

**Power chain** <br>
<span style="font-family:monospace; white-space:pre;">7.4V (LiPo) → fuse → switch ─┬→ driver (VM) → motors
                             └→ MP1584 → 5V → Teensy → 3.3V → sensors</span>

<div style="display:flex; gap:16px; align-items:center;" markdown="1">
<div style="flex:1;" markdown="1">
**Battery** <br>
LiPo 2S, 55×30×12mm, 3PIN 7.4V SM 800mAh 10C, 48g (cf. calculation above) <br>
**⚠** 7.4V nominal [6.0-8.4] <br>
**🛈** C-rating[^1] = how fast the battery empties, e.g. 1C = 1h <br>
Max current (A) = Capacity (Ah) × C-rating ⇔ 0.8Ah × 10 = 8A <br>
So the battery can supply 8A max.
</div>
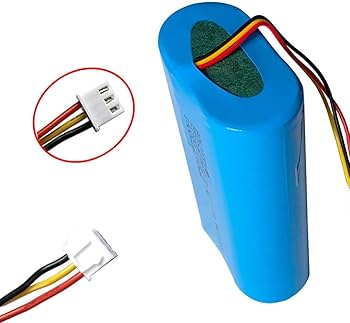
[picture p96: assets/img/battery.jpg]
LiPo 2S battery

</div>

<div style="display:flex; gap:16px; align-items:center;" markdown="1">
<div style="flex:1;" markdown="1">
**Protection** <br>
Fuse 5×20 mm, ⇆ 7.4V, 0A passive, 2A slow-blow, 250V, 3g with holder <br>
**🛈** with T (Time-lag), transparent with small metallic mass inside + it requires a holder to connect <br>
**⚠** 2A is below the 3.2A peak on purpose, the time-lag absorbs the brief stall peaks
</div>
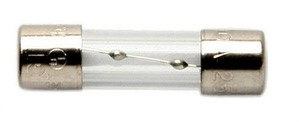
[picture p97: assets/img/fuse.jpg]
Fuse

</div>

<div style="display:flex; gap:16px; align-items:center;" markdown="1">
<div style="flex:1;" markdown="1">
**Slide switch ON/OFF** <br>
10mm, simple SPST, 2 pins, ⇆ 7.4V, 0A passive, min ≥ 3A & ≥ 10V, 1g
</div>
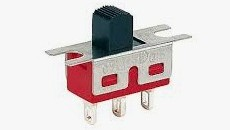
[picture p98: assets/img/slide_switch.jpg]
Slide switch

</div>

#### 2.2 Signal
Motor noise has 4 defenders.

<div style="display:flex; gap:16px;" markdown="1">
<div class="bom-col" markdown="1">
**Reservoir capacitor** <br>
≥ 470 µF electrolytic, Ø10×12 mm, 2g <br>
7.4V rail, across Voltage Motor (VM) at the driver absorbs the motor current spikes → stable VM rated ≥ 16V, polarised: + on VM, − on GND
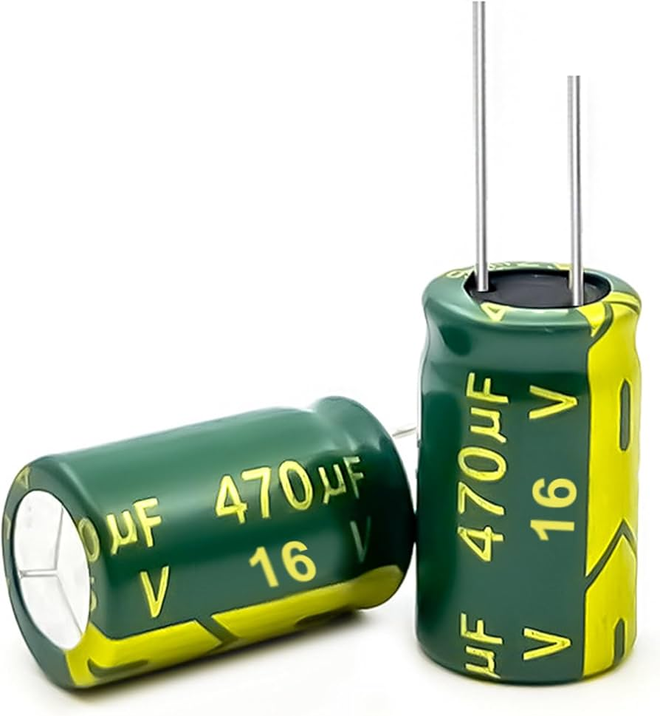
[picture p99: assets/img/cap_470uF.jpg]
Reservoir capacitor 470uF

</div>
<div class="bom-col" markdown="1">
**Decoupling** <br>
100 nF per chip, 3.3V rail at each chip <br>
stable local 3.3V → that chip, sits a few mm from the chip's VDD+/GND- pins <br>
**🛈** each chip has its own decoupling capacitor

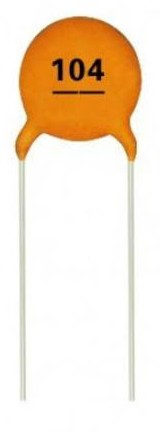
[picture p100: assets/img/Condensateur_decouplage_100nF.jpg]
Decoupling capacitor 100nF

</div>
</div>

<div style="display:flex; gap:16px; align-items:center;" markdown="1">
<div style="flex:1;" markdown="1">
**RC filter** <br>
R 1 kΩ + C 100 nF <br>
IN/OUT: noisy analog 0–3.3V ← AS5600, clean analog → Teensy ADC <br>
cut-off frequency (fc) = 1/(2πRC) = 1.6kHz, $+$ the whisker's useful speed, $-$ the PWM noise <br>

**🛈** if you pick R or C wrong, the cut-off moves: <br>
. fc too low → cut the whisker signal <br>
. fc too high → let the noise through <br>

</div>
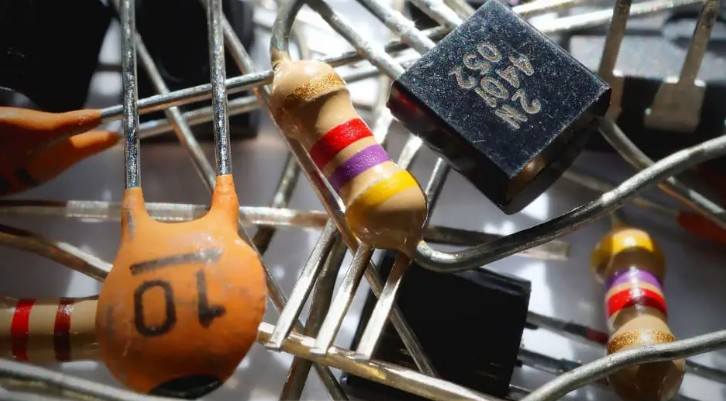
[picture p101: assets/img/RC_filter.jpg]
RC filter

</div>

<div style="display:flex; gap:16px; align-items:center;" markdown="1">
<div style="flex:1;" markdown="1">
**Wiring** <br> 
Star ground, all GND returns one single common point <br>
never daisy-chain the motor GND through the sensor GND
</div>
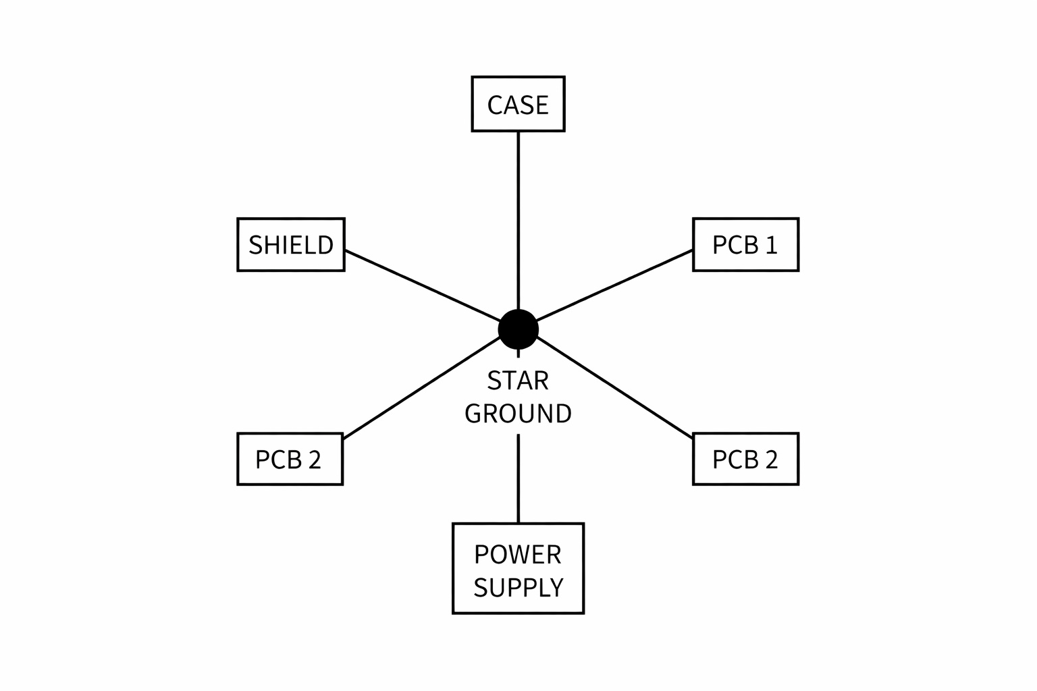
[picture p102: assets/img/start_ground.jpg]
Star ground wiring

</div>

**Σ $A$ (2.2) signal = 0 $A$**

## 4. Tools & software

<div class="two-col">
<div class="col" markdown="1">
**Software** <br>
. Fusion 360 — CAD (3D parts) <br>
. mms — maze algorithm simulator <br>
. Arduino — firmware (Teensy) <br>
. Python — signal analysis & telemetry <br>
</div>
<div class="col" markdown="1">
**Languages** <br>
. C++ — firmware + mms <br>
. Python — signal modeling / analysis <br>
</div>
</div>

**Hardware tools**
- 3D printer
- soldering iron
- multimeter
- bench power supply + banana plug to alligator clip
- breadboard 830-point (MB-102) + Dupont wires
- a charger for the battery

#### Shopping

[Guanghua Electronic Plaza 光華 國際電子廣場](https://maps.app.goo.gl/CivSX8b6aPFQH9BA9) : Taipei electronics market<br>
[shopee](https://shopee.tw/) : for ordering the parts I couldn't find on the market <br>
[ATB 通伯樂器音響 松山店 (阿通伯樂器)](https://maps.app.goo.gl/3gjMFyeZHsfKmeCv9) : thanks for the recycled musical instrument strings 🎶

| Part | Qty | Price (NT$) |
|---|---|---|
| Teensy 4.0 | 1 | 888 |
| MP1584 buck (5 V fixed) | 1 | 66 |
| LiPo 2S 800 mAh 10C | 1 | 300 |
| To charge LiPo | 1 | 310 |
| Slide switch (≥ 3 A) | 1 | 20 |
| Fuse 2 A slow-blow + holder | 1 | 40 |
| TB6612FNG driver | 1 | 150 |
| N20 motor 6 V + encoder | 2 | 225 |
| Wheels Ø32 mm silicone | 2 | 49.4 |
| Ball caster / PTFE skid | 1 | 50 |
| AS5600 module + diametric magnet Ø4 mm | 3 | 84.5 |
| MR63 bearing (set) | 1 | 337 |
| Micro-spring (set) | 1 | 100 |
| MPU-6050 / GY-521 | 1 | 94 |
| LED kit | 1 | 82 |
| Capacitor reservoir 470 µF 25 V (set) | 1 | 40 |
| Resistor 1 kΩ (set) | 1 | 30 |
| Decoupling capacitor 100 nF (set) | 1 | 20 |
| Perfboard double-sided FR4 | 1 | free |
| Dupont wires (set) | 1 | 50 |
| Hookup wires (set) | 1 | 60 |
| Laser cutting | 1 | 600 |
| banana plug & alligator clip | 1 | 45 |
| Micro SD | 1 | 300 |
| Module micro SD | 1 | 40 |
| Screw + nut M2 & M3 (metal & plastic set) | 1 | 150 |
| 3M tape | 1 | 169 |
| Metal file | 1 | 70 |
| Rod Ø0.5 mm | 1 | 60 |
| Hackerspace sub | 1 | 1000 |
| **Total** | | 5858.3 |

<br>

Good practice is order every part twice, to have spare components. While the parts are on order, work can start on the algorithm that will lead the mouse to the centre of the maze.

<br>

[^1]: [SparkFun — How to Power a Project](https://learn.sparkfun.com/tutorials/how-to-power-a-project/all)

<details class="appendix" markdown="1">
<summary>Appendix A — plan B, if the motors do not have a built-in encoder</summary>

<div style="display:flex; gap:16px; align-items:center;" markdown="1">
<div style="flex:1;" markdown="1">
**Optical flow sensor** <br>
PMW3901, XY translation, 0.009A, ~1.5g <br>
**🛈** z-axis focus range ≥80 mm, needs ≥100 Lux, mount on a raised mast pointing straight down
</div>
<div style="flex:1;" markdown="1">

|IN | OUT |
| <small>3.3V ← Teensy, ground image ← lens</small> | <small>dx, dy motion 3.3V SPI → Teensy</small> |

</div>
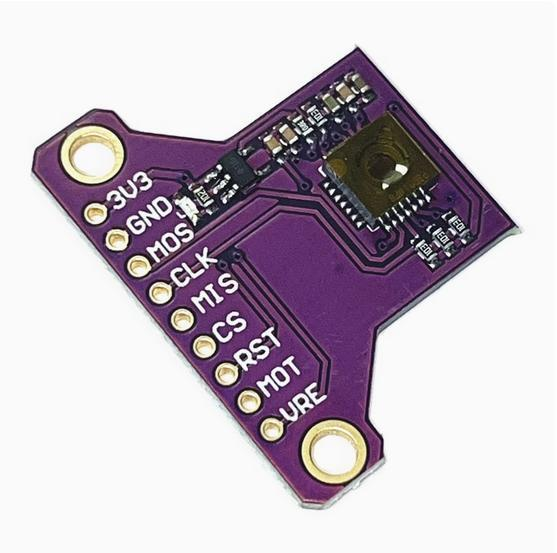
[picture p103: assets/img/PMW3901.jpg]
PMW3901 optical flow sensor

</div>

<div style="display:flex; gap:16px; align-items:center;" markdown="1">
<div style="flex:1;" markdown="1">
**Lighting for PMW3901** <br>
Red/IR/Blue, LED ×1-2, 5mm 20mA, 0.02A, ~0.3g each <br>
**🛈** use a 220Ω resistor from the 7.4 V rail (R = (7.4 − 3.2) / 0.02 = 210 Ω) red/blue = Vf ≈ 2.0V → 270Ω, IR = Vf ≈ 1.4V → 300Ω <br>
</div>
<div style="flex:1;" markdown="1">

|IN | OUT |
| <small>7.4V ← rail, through a series resistor 220Ω 1/4W</small> | <small>light onto the floor, ~15-45° grazing angle</small> |

</div>
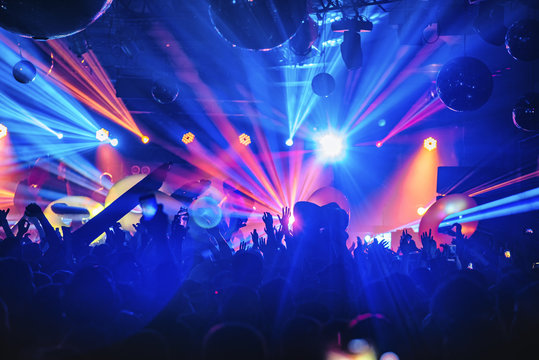
[picture p104: assets/img/led.jpg]
LED lighting

</div>

*[ADC]: Analog-to-Digital Converter
*[buck]: step-down converter
*[CPR]: Counts Per Revolution (encoder resolution)
*[FR4]: fiberglass board material
*[GND]: Ground (0 V reference)
*[I2C]: Inter-Integrated Circuit (2-wire bus)
*[IMU]: Inertial Measurement Unit
*[LDO]: Low Drop-Out regulator
*[LiPo]: Lithium-ion Polymer
</details>

*[MCU]: Microcontroller Unit
*[PCB]: Printed Circuit Board
*[PWM]: Pulse Width Modulation
*[RC]: Resistor + Capacitor filter
*[SPI]: Serial Peripheral Interface
*[STBY]: Standby (LOW = asleep, HIGH = awake)
*[VCC]: logic supply voltage
*[VIN]: Voltage In (power input pin)
*[VM]: Voltage Motor (driver motor supply)
*[2S]: 2 cells in series
*[across]: in parallel, between the two pins
*[2A(T)]: The 2A fuse is below that 3.2 A peak on purpose: being slow-blow (T), it lets the brief stall peaks through but cuts on a sustained overload or a short, which is exactly what we want (→ what is needed) if the robot stays jammed against a wall.
