lili-lines/ratatouille/_posts/2026-07-24-component-takeaways.md

---
layout: post
title: 🥡 Takeaways, component
date: 2026-07-24 10:00:00 +0200
tags: [electronics]
---

Photo + explication composants & soudure si besoin : <br>
. teensy <br>
. as5600 <br>
. gyro <br>
. driver <br>
. motor <br>
. interupteur <br>

couleur fil :
. noir- /rouge+
. autre couleur pour les commandes

pour le teste avec la battery de laboratoire :
To test the full power chain instead, feed 7.4 V through the MP1584 with the current limit set to 300–500 mA as a safety cap
⚠️ pour ne pas tout griller on va vérifier la sorite réel de chaque composant du circuit avant de tout relier ensemble

. Pour chaque composant :
  une photo avec sur la photo situer l'in/out avec les cristères
  in-/in+ : 1 ou + à respecter pour ne pas griller le truc
  out-/out+ : 1 ou + attention au prochain composant
  une photo de la vérif avec un multimètre
  quel composant avant et quel composant aprés

. Faire un cercle avec les composant pour avoir une vue d'ensemble

> The signal vs power topic moved to its own post: [Signal vs Power]({{ '/2026/07/07/signal-vs-power.html' | relative_url }}).
