lili-lines/ratatouille/assets/img/river/Object_1.3mf

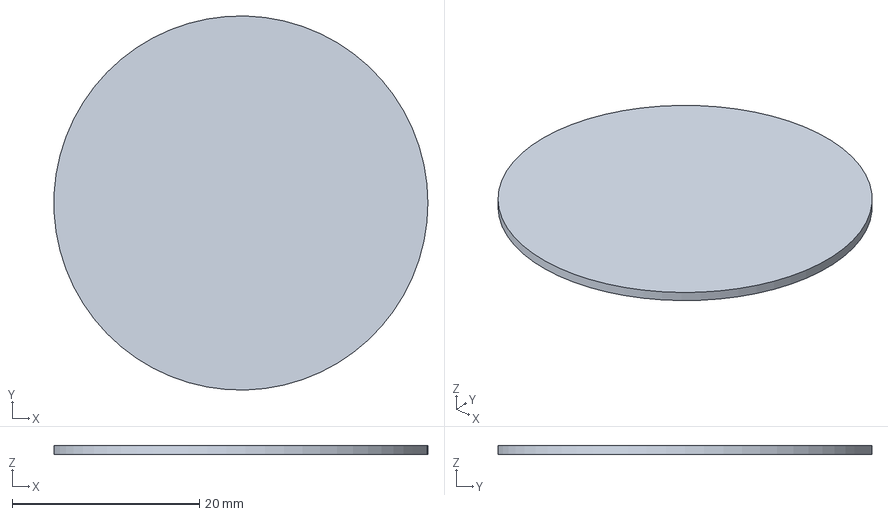
[picture p110: CAD file, 2026-09-18]
assets/img/river/Object_1.3mf
40.0 x 40.0 x 1.00 mm
