lili-lines/ratatouille/mecha/bras.stl

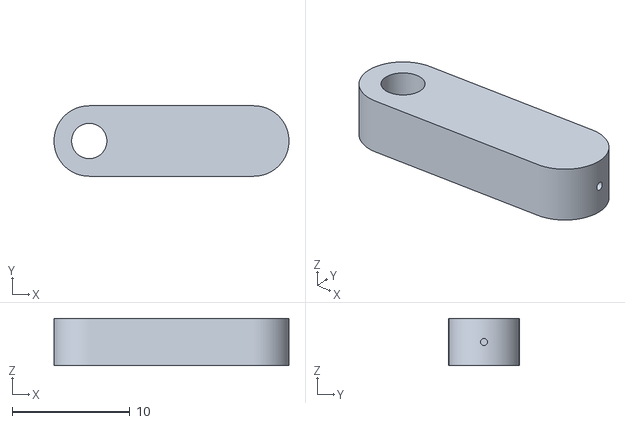
[picture p111: CAD file, 2026-08-03]
mecha/bras.stl
20.0 x 6.00 x 4.00
