lili-lines/ratatouille/mecha/module-moustache2.stl

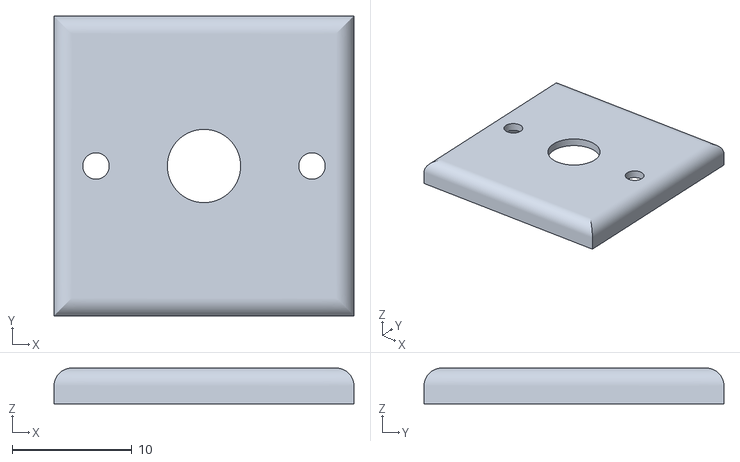
[picture p112: CAD file, 2026-08-03]
mecha/module-moustache2.stl
25.0 x 25.0 x 3.00
