lili-lines/ratatouille/assets/img/river/jeton_river3d.3mf

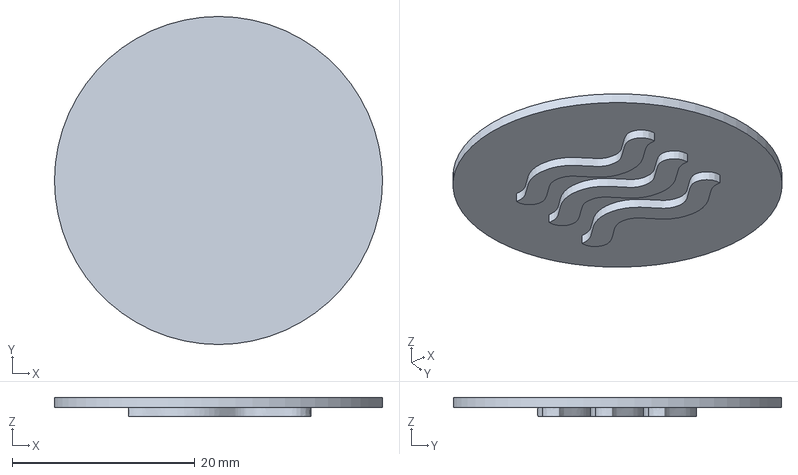
[picture p113: CAD file, 2026-09-13]
assets/img/river/jeton_river3d.3mf
35.9 x 35.9 x 2.10 mm
