lili-lines/ratatouille/mecha/berceau_motor.stl

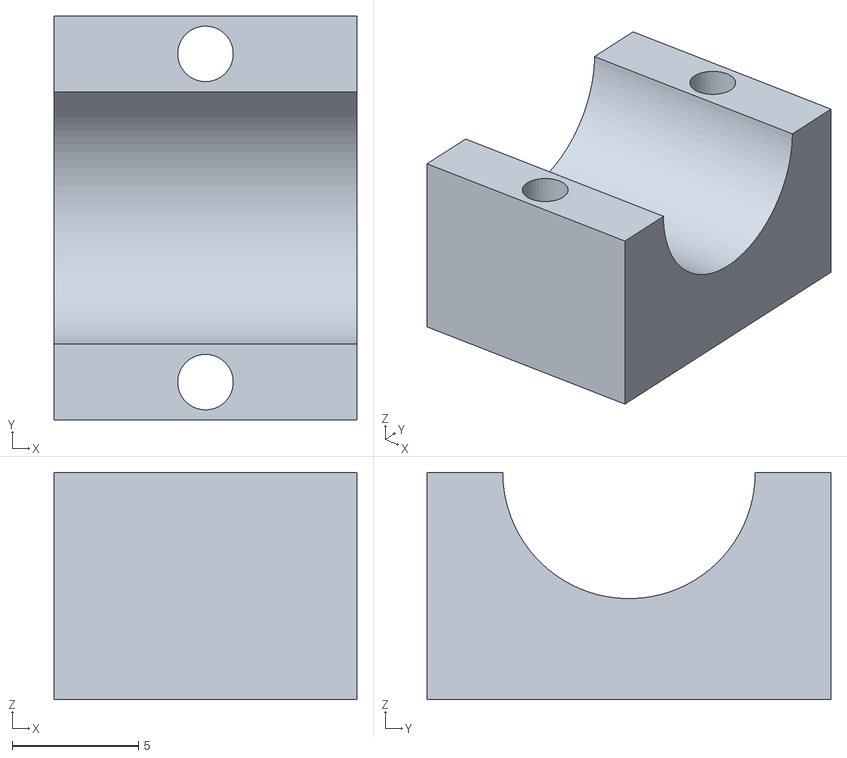
[picture p114: CAD file, 2026-06-29]
mecha/berceau_motor.stl
12.0 x 16.0 x 9.00
