lili-lines/ratatouille/(list of files, cad)

Other CAD files:
assets/img/river/Object_12.3mf
assets/img/river/river.FCStd
assets/img/river/jeton_corps.FCStd
assets/img/river/jeton_corps.3mf
