lili-lines/ratatouille/_posts/2026-08-15-wiring.md

---
layout: post
title: The wiring
date: 2026-08-15 10:00:00 +0200
tags: [electronics, hardware]
---

* TOC
{:toc}

Now the delicate step, soldering all the components together[^1]. This is where the cards from [The component]({% post_url 2026-07-02-component-takeaways %}) come in, to get the right pins connected. No room for error here, one wrong connection can burn a component for good.

#### 1. Tools

<div style="display:flex; flex-wrap:wrap; gap:12px; align-items:flex-start;">
  <figure style="flex:1; min-width:180px; margin:0;">
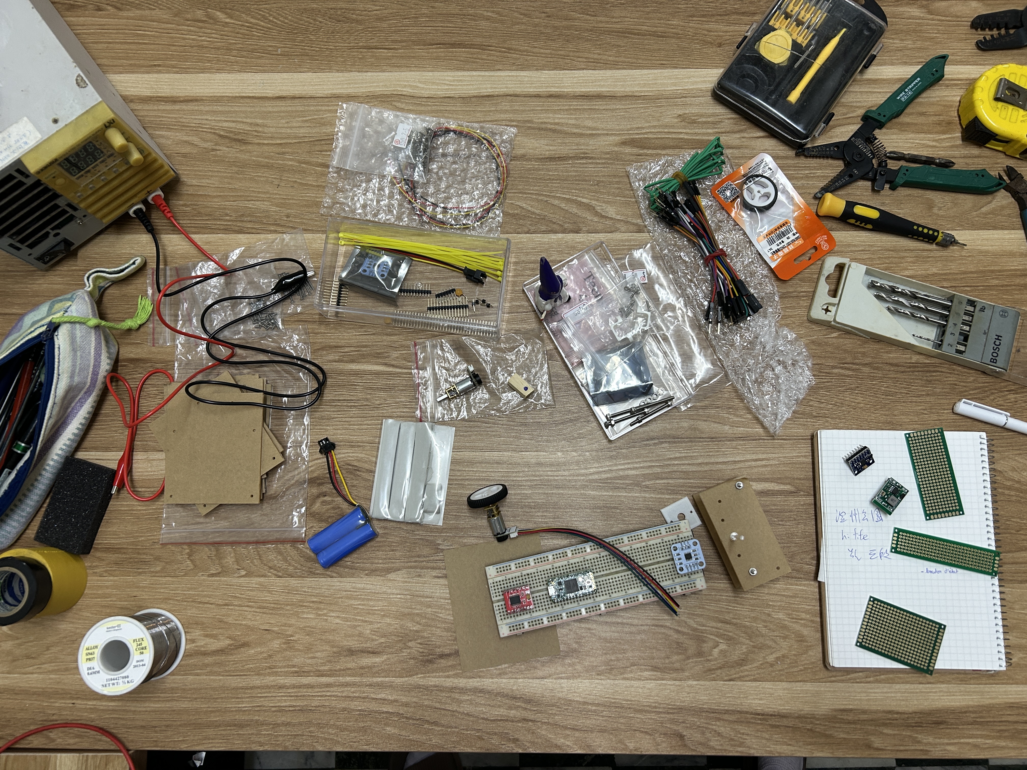
[picture p115: assets/img/IMG_9300.JPG]
the material
    
    <figcaption style="text-align:center; font-size:0.85rem;">material</figcaption>
  </figure>
  <figure style="flex:1; min-width:180px; margin:0;">
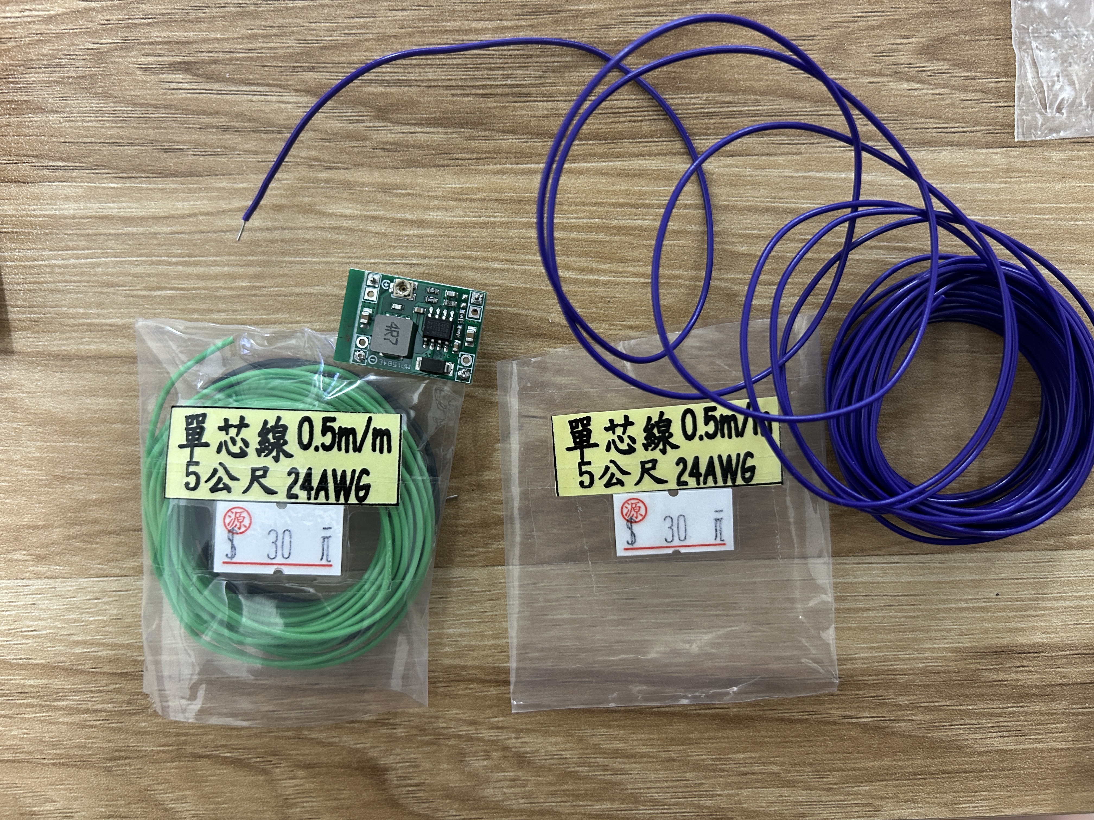
[picture p116: assets/img/IMG_9360.JPG]
0.5 m wires in 24 AWG
    
    <figcaption style="text-align:center; font-size:0.85rem;">0.5 m wires, 24 AWG</figcaption>
  </figure>
  <figure style="flex:1; min-width:180px; margin:0;">
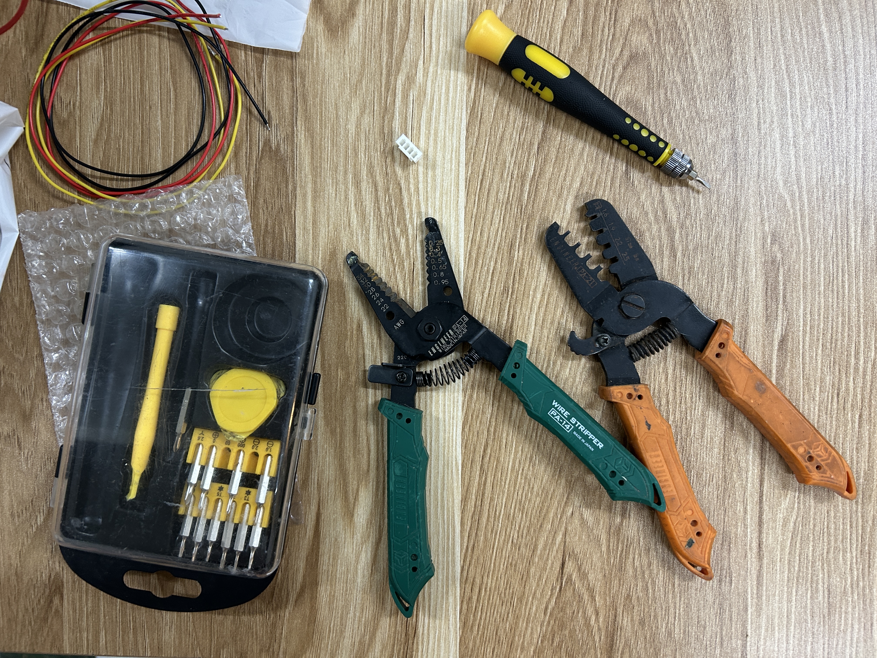
[picture p117: assets/img/IMG_9290.JPG]
tools to cut and solder the wires
    
    <figcaption style="text-align:center; font-size:0.85rem;">the tools to strip and crimp the wires</figcaption>
  </figure>
</div>

#### 2. The battery, wiring for charging

<div style="display:flex; flex-wrap:wrap; gap:12px; align-items:flex-start;">
  <figure style="flex:1; min-width:150px; margin:0;">
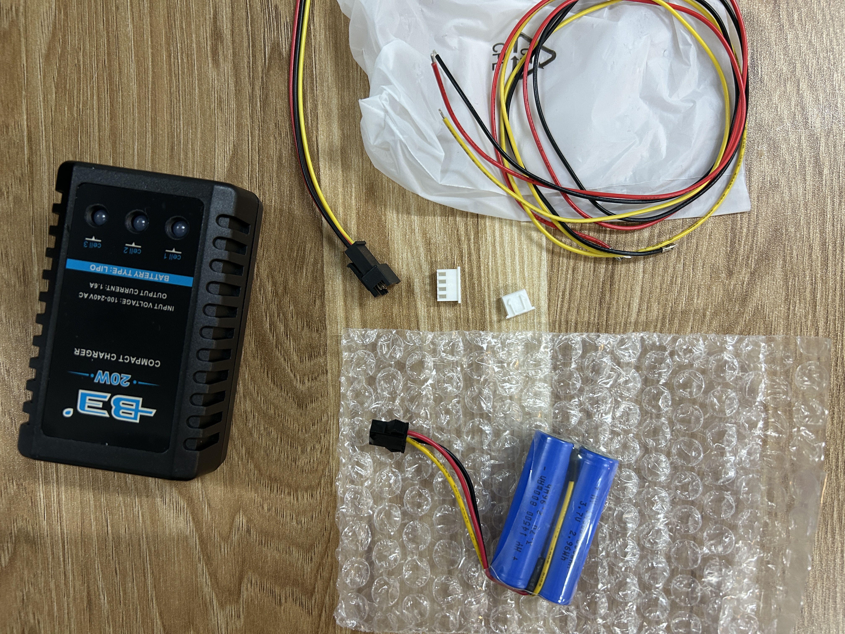
[picture p118: assets/img/IMG_9287.JPG]
charger, cable and battery
    
    <figcaption style="text-align:center; font-size:0.85rem;">charger, cable, battery</figcaption>
  </figure>
  <figure style="flex:1; min-width:150px; margin:0;">
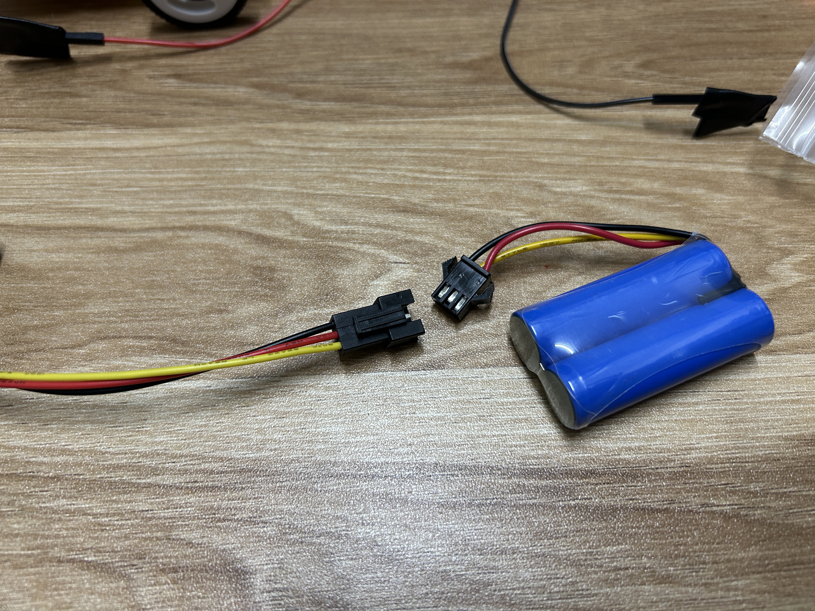
[picture p119: assets/img/IMG_9430.JPG]
the wire colours do not line up
    
    <figcaption style="text-align:center; font-size:0.85rem;">we notice that the wire colours do not line up (→ the wire colours do not line up)</figcaption>
  </figure>
  <figure style="flex:1; min-width:150px; margin:0;">
repositioning the wires
    
    <figcaption style="text-align:center; font-size:0.85rem;">so we change the positions to match the colours with the charger's (→ so I move the pins to match the charger's colours)</figcaption>
  </figure>
  <figure style="flex:1; min-width:150px; margin:0;">
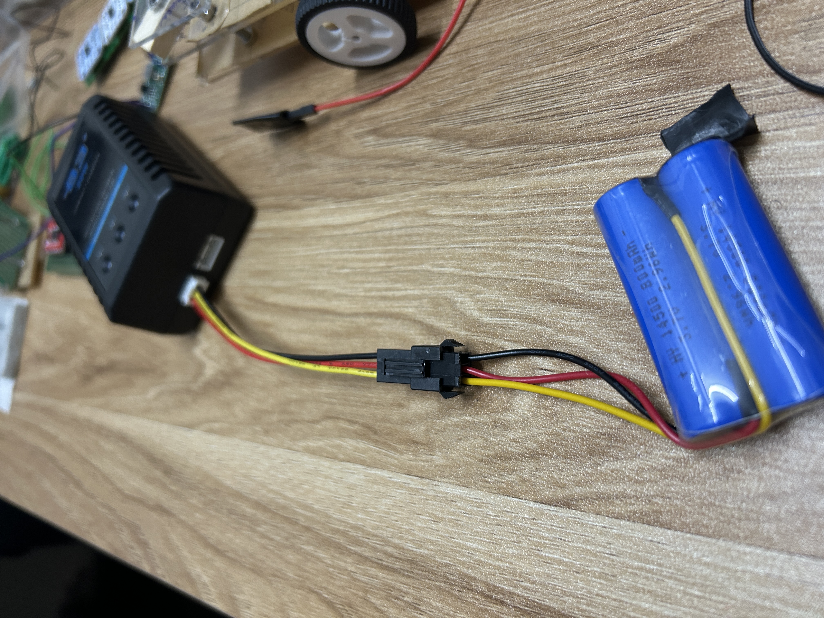
[picture p121: assets/img/IMG_9433.JPG]
battery charging
    
    <figcaption style="text-align:center; font-size:0.85rem;">the battery can be charged</figcaption>
  </figure>
</div>

#### 3. Preparing the motor wires

<div style="display:flex; flex-wrap:wrap; gap:12px; justify-content:center; align-items:flex-start;">
  <figure style="margin:0; flex:0 1 auto;">
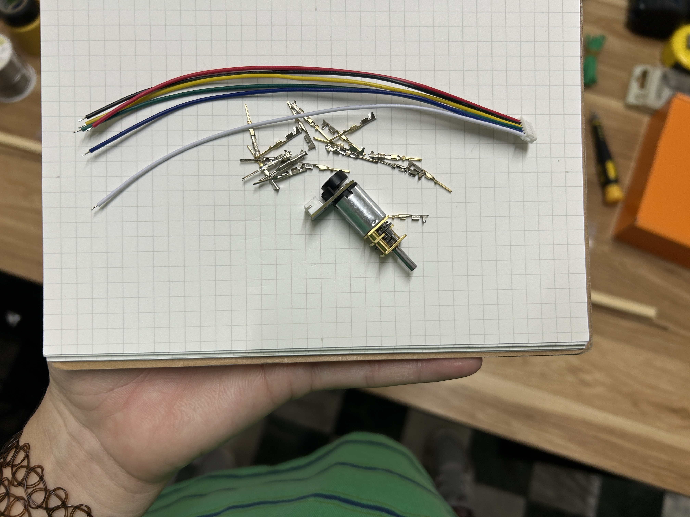
[picture p122: assets/img/IMG_9308.JPG]
motor
    
    <figcaption style="text-align:center; font-size:0.85rem;">what you need to wire the motor</figcaption>
  </figure>
  <figure style="margin:0; flex:0 1 auto;">
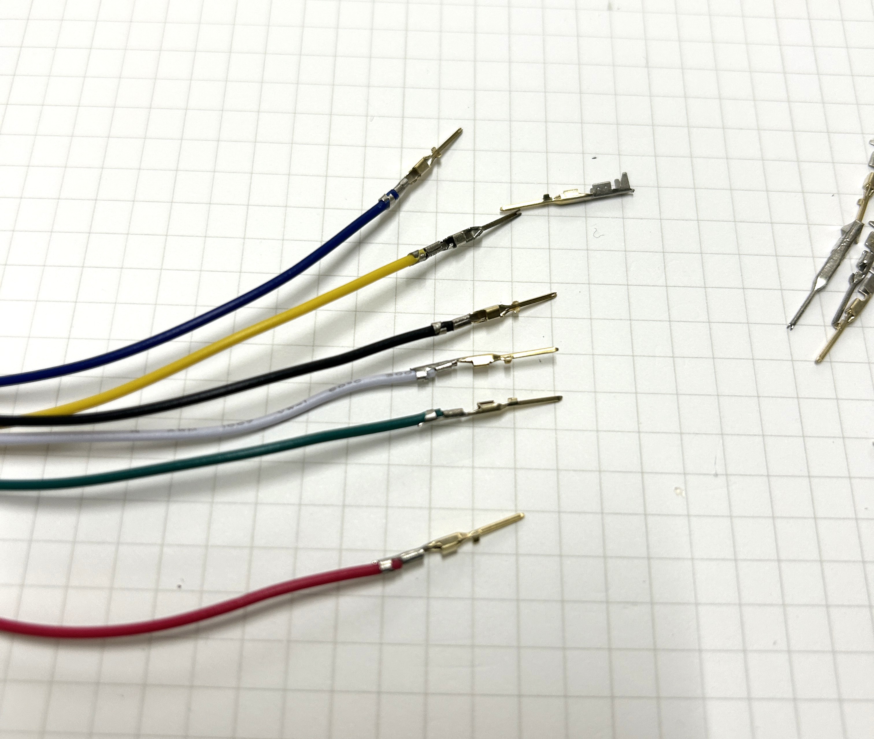
[picture p123: assets/img/IMG_9311.JPG]
motor wires
    
    <figcaption style="text-align:center; font-size:0.85rem;">strip the wires, then crimp</figcaption>
  </figure>
</div>

#### 4. The buck, setting the output to 5 V

<div style="display:flex; flex-wrap:wrap; gap:12px; align-items:flex-start;">
  <figure style="flex:1; min-width:150px; margin:0;">
the buck wired on the breadboard
    
    <figcaption style="text-align:center; font-size:0.85rem;">wired on the breadboard</figcaption>
  </figure>
  <figure style="flex:1; min-width:150px; margin:0;">
setting the output to 5 V
    
    <figcaption style="text-align:center; font-size:0.85rem;">setting OUT to 5 V</figcaption>
  </figure>
  <figure style="flex:1; min-width:150px; margin:0;">
checking with the multimeter
    
    <figcaption style="text-align:center; font-size:0.85rem;">checked with the multimeter, OUT = 5 V</figcaption>
  </figure>
</div>

The buck is cut to an unusual size, so it does not fit the rails of the board. To make it hold we would have to solder the pins bent, so we replace them with wires, (→ Holding it would mean soldering the pins bent, so I replace them with wires,) which gives a cleaner final assembly.

<div style="display:flex; flex-wrap:wrap; gap:12px; align-items:flex-start;">
  <figure style="flex:1; min-width:220px; margin:0;">
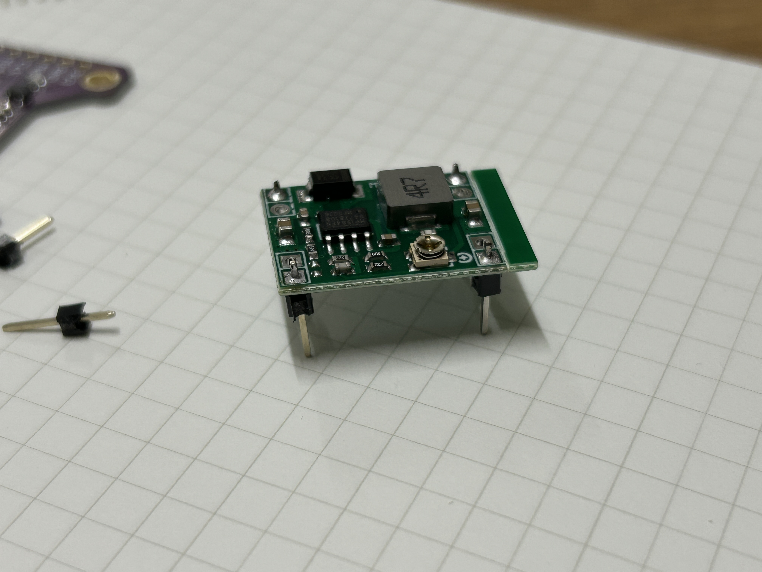
[picture p127: assets/img/IMG_9131.JPG]
buck MP1584
    
    <figcaption style="text-align:center; font-size:0.85rem;">buck MP1584 with its pins, 7.4 V → 5 V</figcaption>
  </figure>
  <figure style="flex:1; min-width:220px; margin:0;">
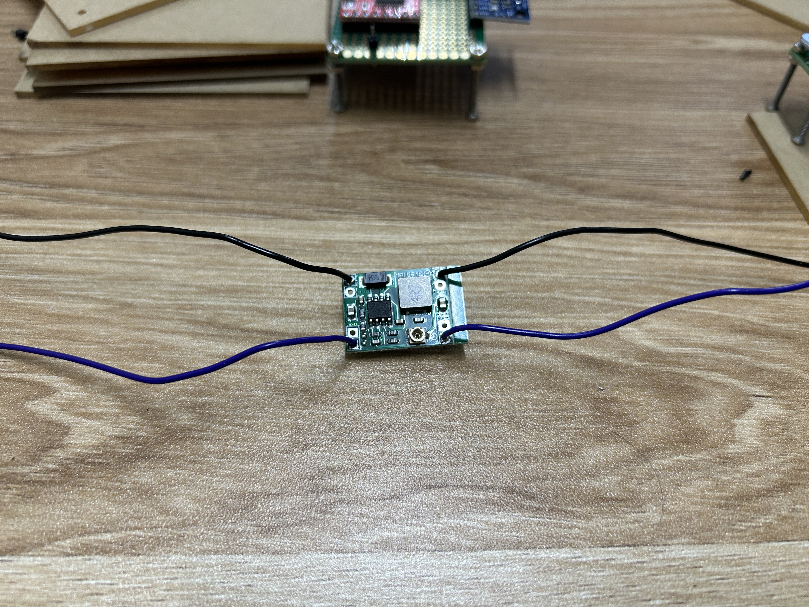
[picture p128: assets/img/IMG_9362.JPG]
wires soldered on the buck instead of the pins
    
    <figcaption style="text-align:center; font-size:0.85rem;">the pins replaced by wires</figcaption>
  </figure>
</div>

#### 5. The perfboard

<div style="display:flex; flex-wrap:nowrap; gap:12px; align-items:flex-start;">
  <figure style="margin:0; flex:0.99 1 0; min-width:0;">
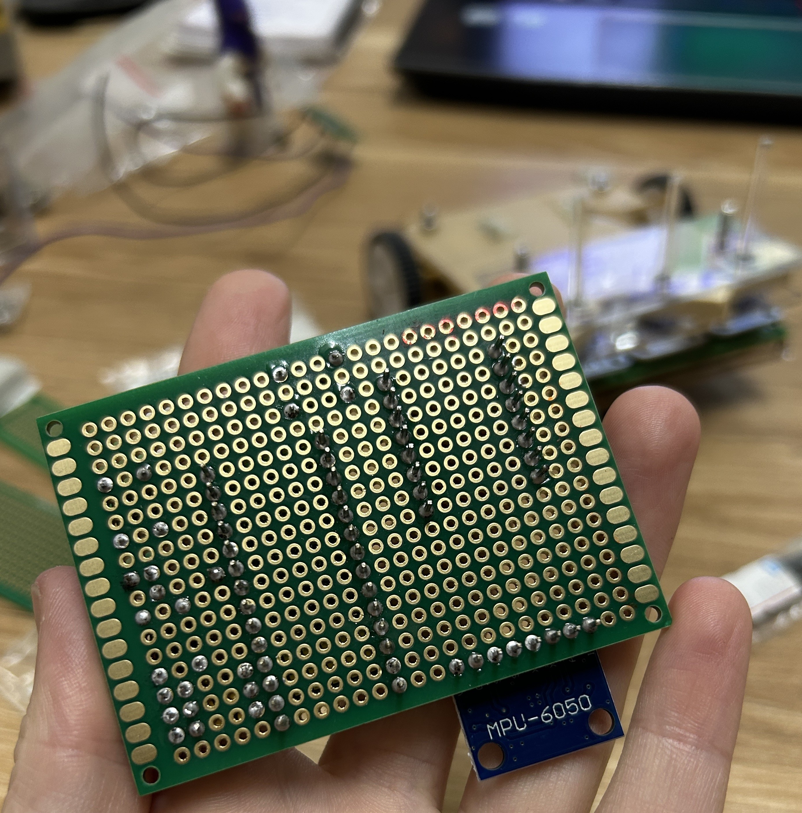
[picture p129: assets/img/IMG_9421.JPG]
soldering the pins on the perfboard
    
    <figcaption style="text-align:center; font-size:0.85rem;">solder all the pins</figcaption>
  </figure>
  <figure style="margin:0; flex:1.78 1 0; min-width:0;">
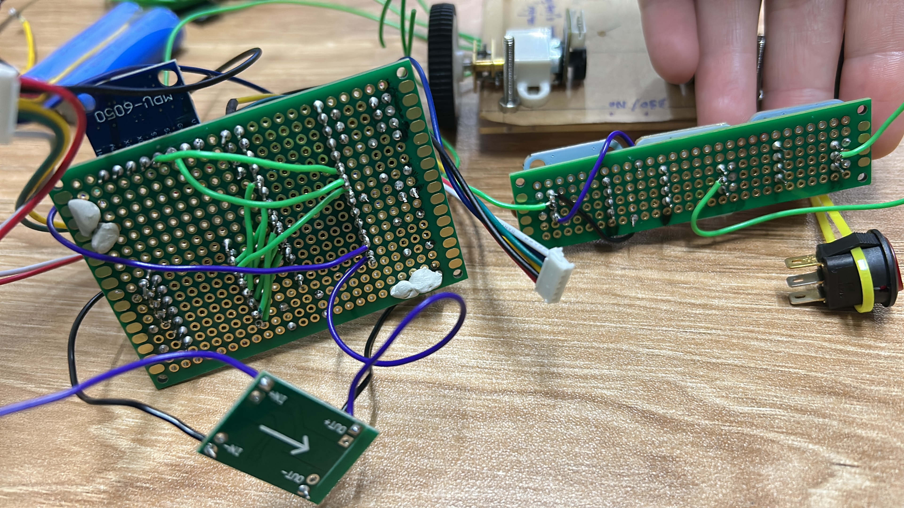
[picture p130: assets/img/EXQB1150.JPG]
connections between the pins marked with a coloured marker
    
    <figcaption style="text-align:center; font-size:0.85rem;">make the connections between the pins, using a coloured marker to help</figcaption>
  </figure>
  <figure style="margin:0; flex:0.88 1 0; min-width:0;">
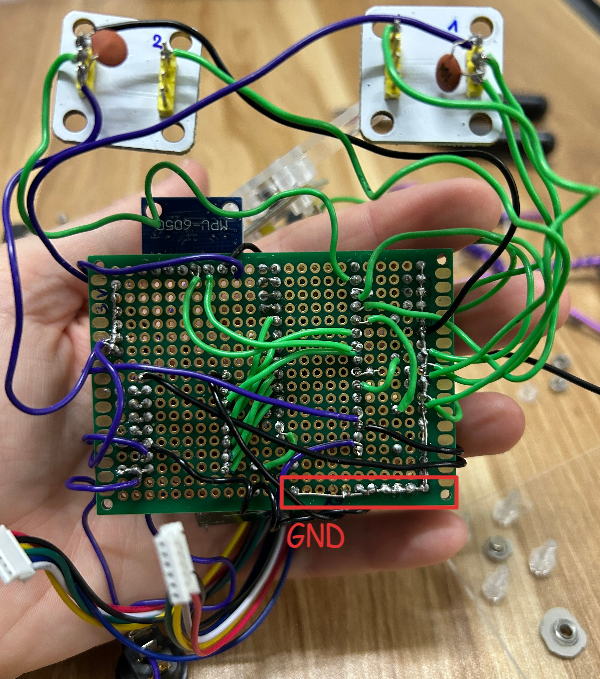
[picture p131: assets/img/perfboard_GND.png]
The GND line on the perfboard
    
    <figcaption style="text-align:center; font-size:0.85rem;">the common GND line</figcaption>
  </figure>
</div>

<br>

Now that everything is connected and the structure looks stable, it is time for the first scripts: read the sensor values, so the mouse can feel its environment, sense an obstacle, know that it is one, and decide what to do about it.

<br>

[^1]: [Adafruit — Making a good solder joint](https://learn.adafruit.com/adafruit-guide-excellent-soldering/making-a-good-solder-joint), the step-by-step technique, and the last page of that guide covers the common defects
