lili-lines/ratatouille/assets/img/creality_app_print.jpg

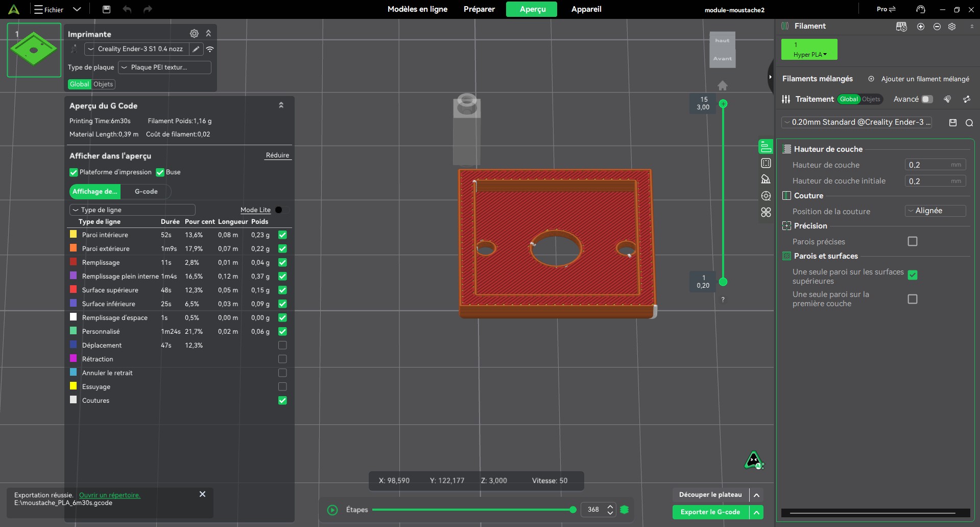
assets/img/creality_app_print.jpg
