lili-lines/ratatouille/test/traduction-1-deroule-stage.md

# Annexe 1 — Déroulé du stage (traduction FR)

*Fichier original : `附件1-研習營流程.tif`*

| Heure | Contenu | Formateurs |
|---|---|---|
| 08:30–09:00 | Accueil des participants | — |
| 09:00–10:00 | Présentation de l'environnement de programmation du robot autonome **bi-plateforme** | Su Jing-Hui, Li Bing-Hui |
| 10:00–11:55 | Piloter le robot autonome avec **MakeCode** | Su Jing-Hui, Li Bing-Hui |
| 12:00–13:00 | Déjeuner & échange d'expériences | — |
| 13:00–14:30 | Piloter le robot autonome en **langage C** | Su Jing-Hui, Li Bing-Hui |
| 14:30–16:00 | **Atelier pratique : course de suivi de ligne** (循線競速) | Su Jing-Hui, Li Bing-Hui |
