lili-lines/ratatouille/test/附件3-2026TMIRC暑期營-雙平台輪型機器人.pdf

# 雙平台輪型機器人設計與應用

2026/7/13

## 指導老師 : 蘇景暉 李炳輝

BitRacer Pro Max 開發者: 鄭力瑋 | 1

目錄

- 緒論

## - 硬體機構設計-機構、電路板 - 線路圖 - 雙平台開發架構

## - MakeCode積木程式設計

## - Arduino IDE程式設計

## - 實際應用與結論

2

# 緒論- BitRacer Pro Max 教學輪型機器人

## 針對108課綱中，關於程式寫

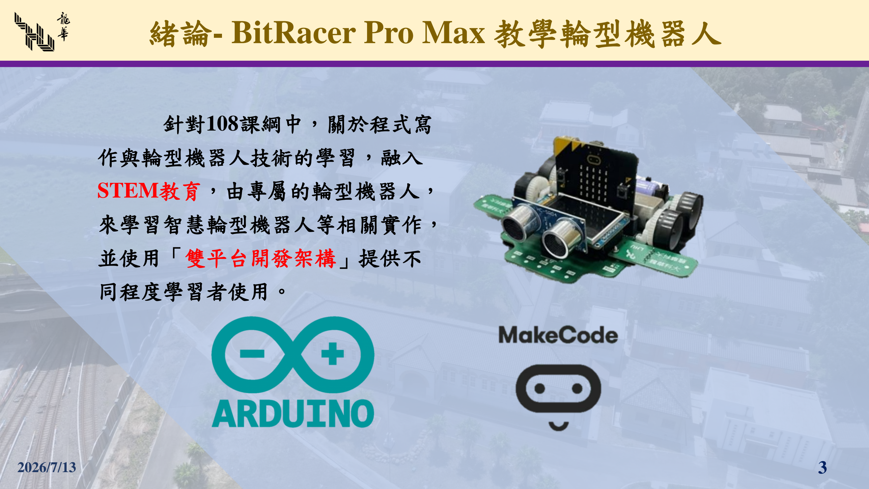
[picture p133: page 3]

## 作與輪型機器人技術的學習，融入 STEM教育，由專屬的輪型機器人， 來學習智慧輪型機器人等相關實作， 並使用「雙平台開發架構」提供不 同程度學習者使用。

3

# 硬體機構設計-馬達四輪

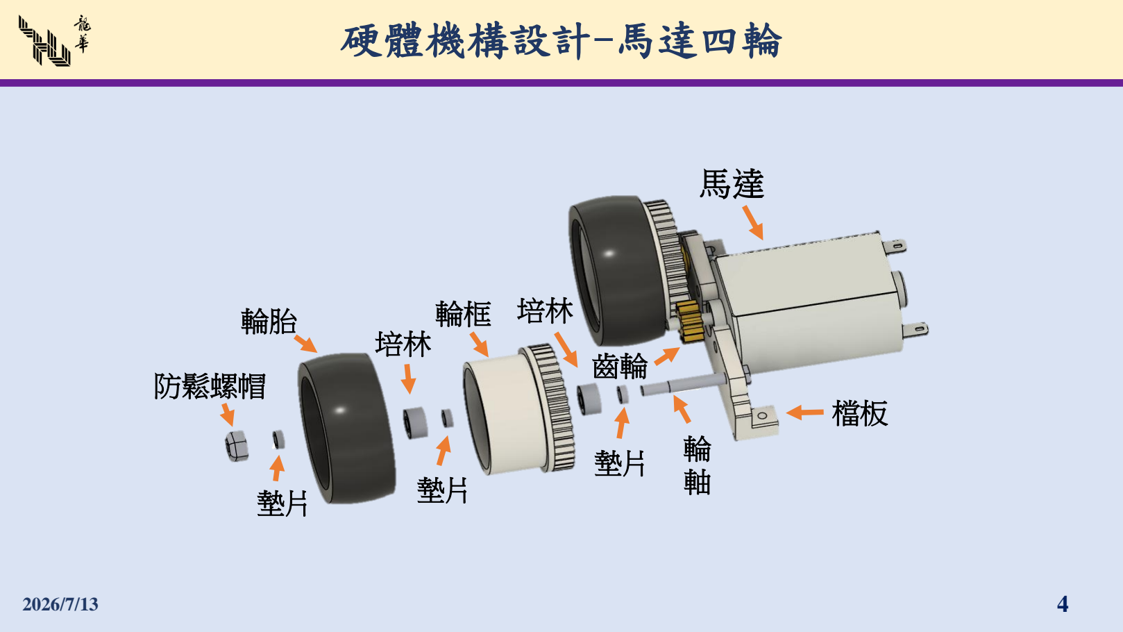
[picture p134: page 4]

馬達

檔板
輪
軸

輪胎

墊片

## 防鬆螺帽

培林

齒輪

墊片

培林

墊片

輪框

4

# 硬體機構設計-紅外線機構

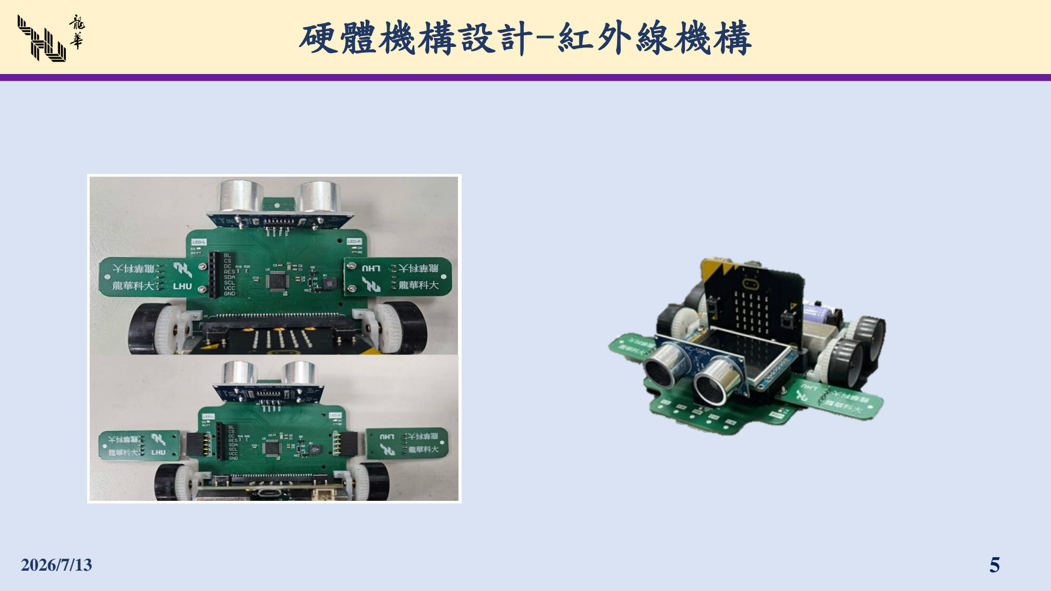
[picture p135: page 5]

2026/7/13 | 5

# 硬體機構設計

# 電路板設計

6

# BitRacer Pro Max教學輪型機器人

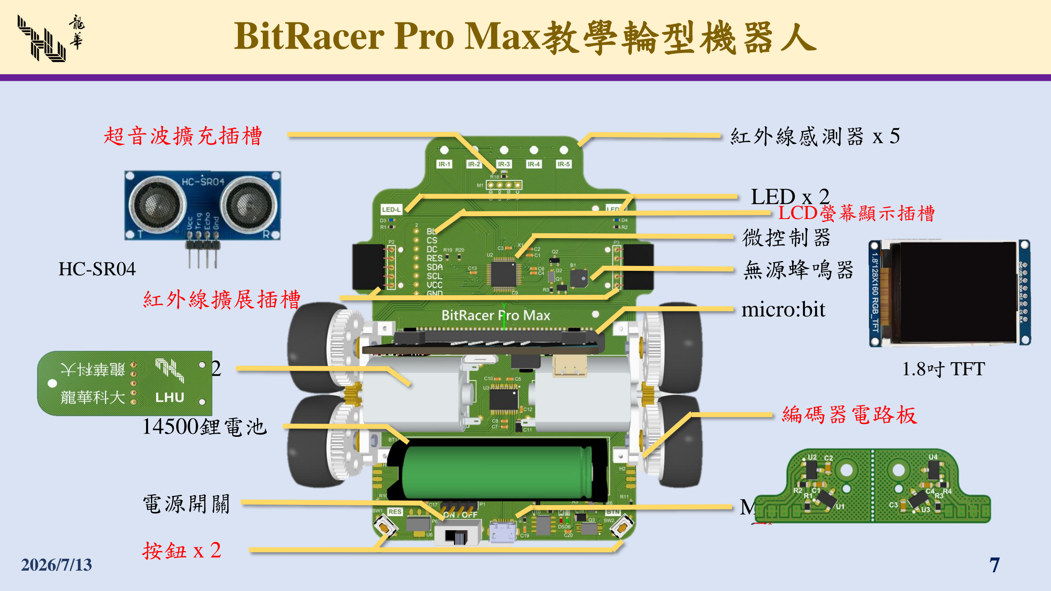
[picture p136: page 7]

超音波擴充插槽

紅外線擴展插槽 | micro:bit

馬達 x 2

按鈕 x 2

編碼器電路板

電源開關

14500鋰電池

微控制器

LED x 2

Micro USB座

無源蜂鳴器

紅外線感測器 x 5

LCD螢幕顯示插槽

HC-SR04

1.8吋 TFT

7

# 紅外線擴展機構

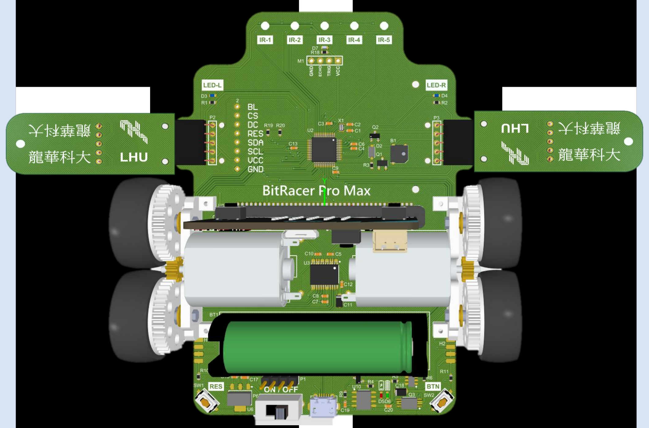
[picture p137: figure]

2026/7/13 | 8

# 線路圖

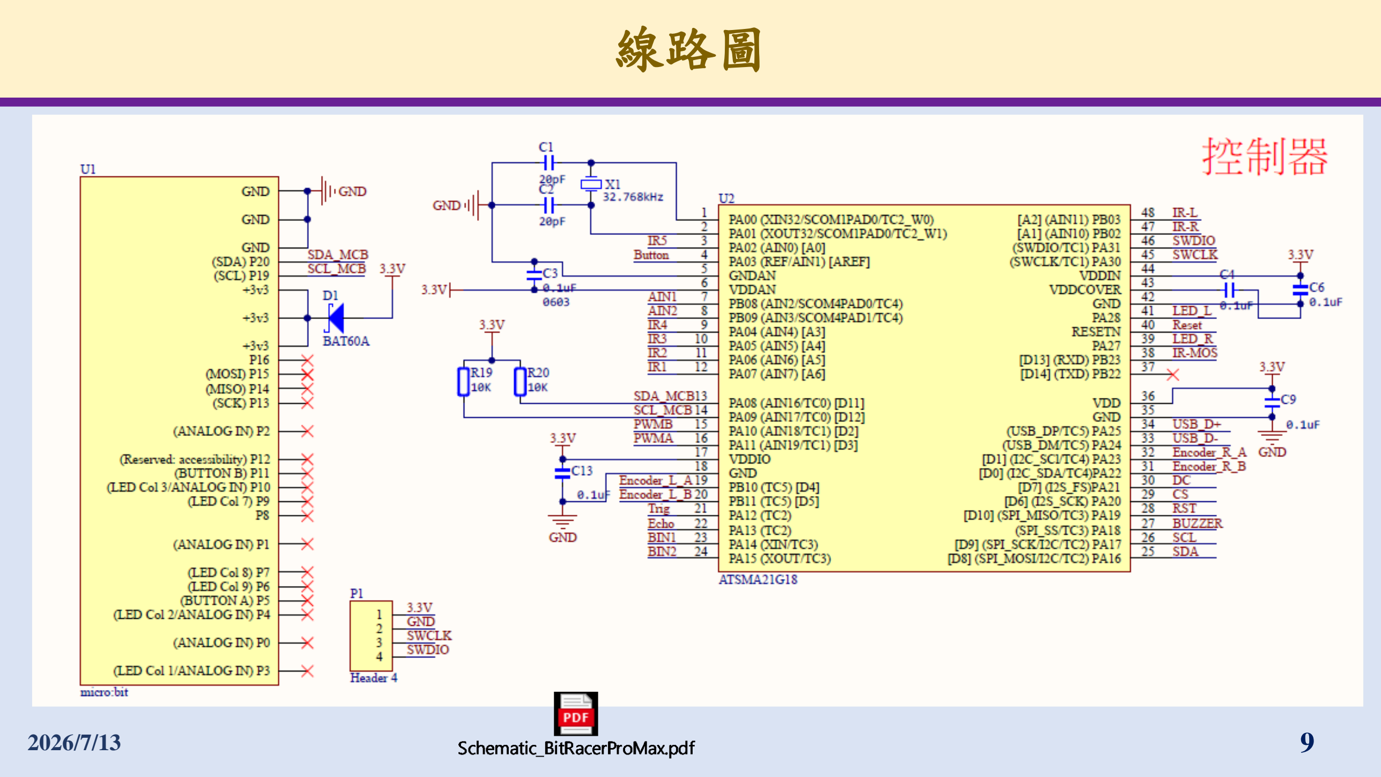
[picture p138: page 9]

2026/7/13 | 9

# 線路圖

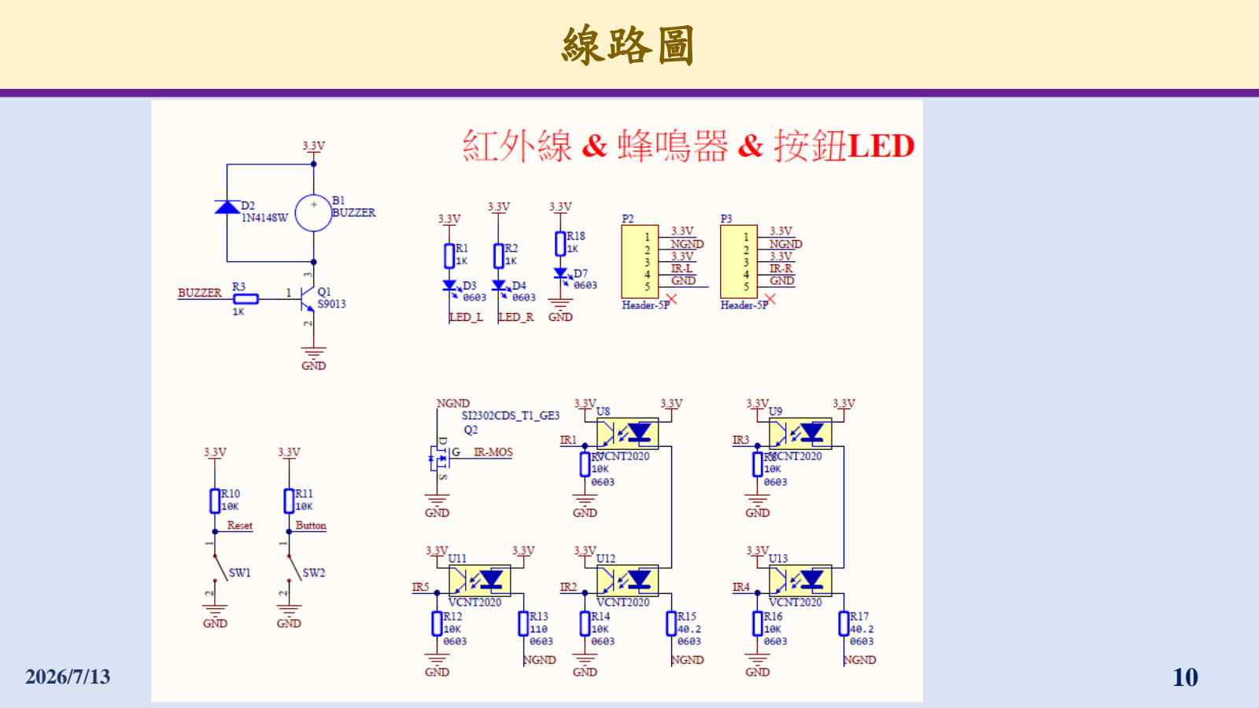
[picture p139: page 10]

2026/7/13 | 10

# 線路圖

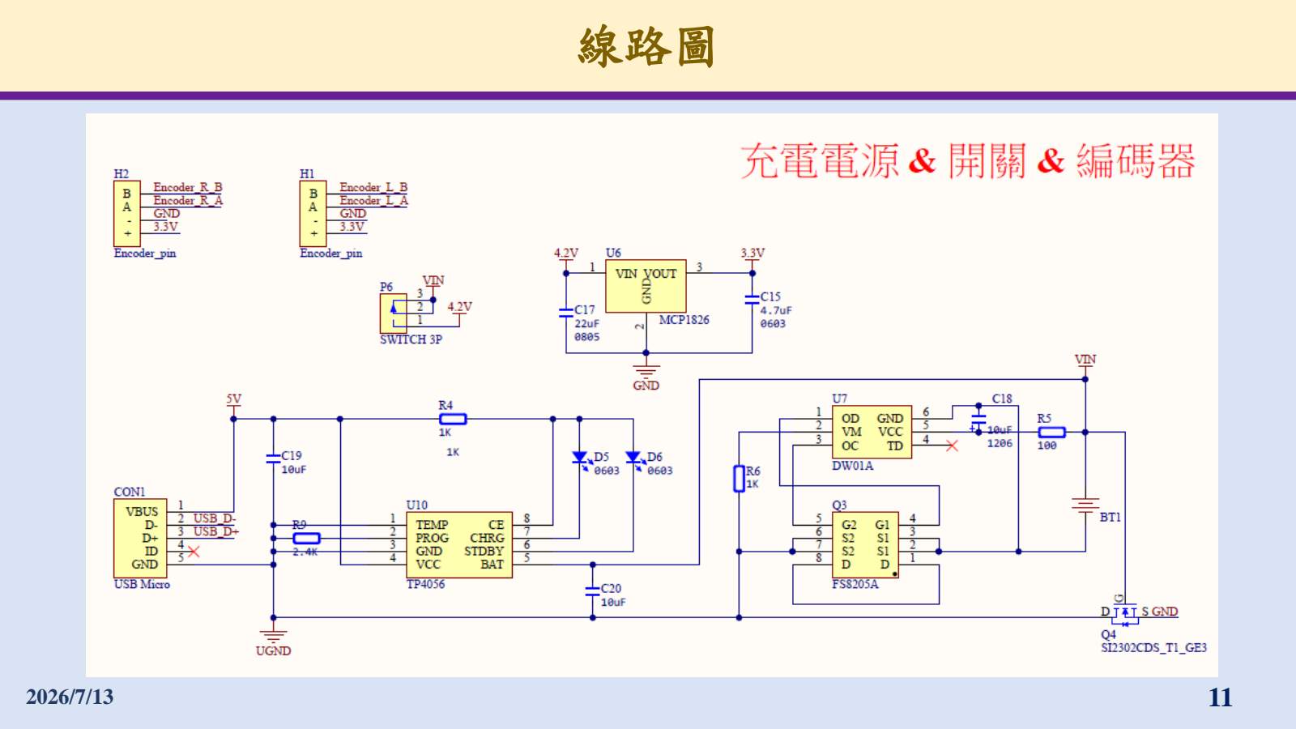
[picture p140: page 11]

2026/7/13 | 11

# 線路圖

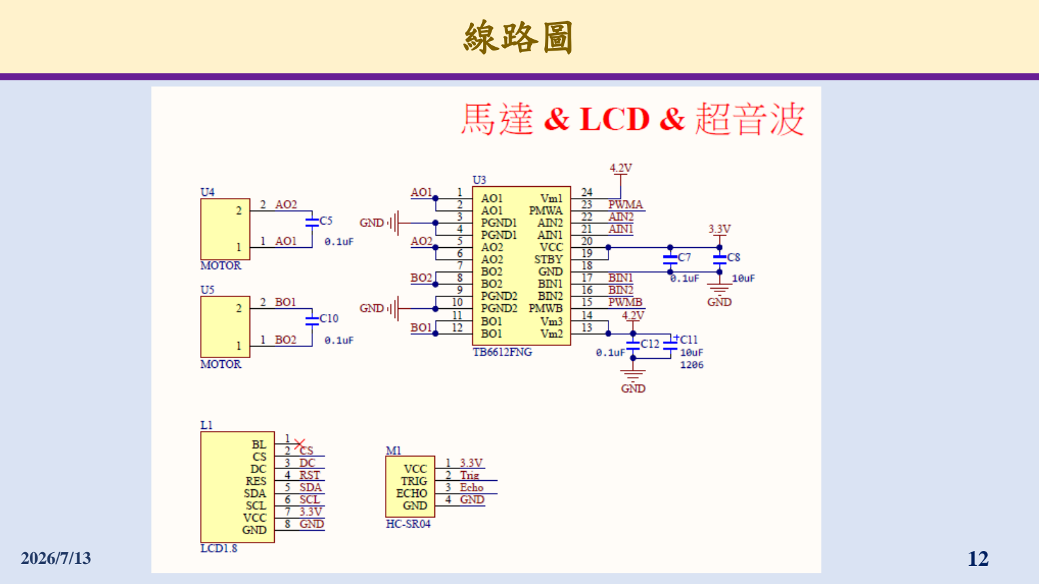
[picture p141: page 12]

2026/7/13 | 12

# 硬體機構設計

# 系統架構

13

# BitRacer Pro Max 系統架構

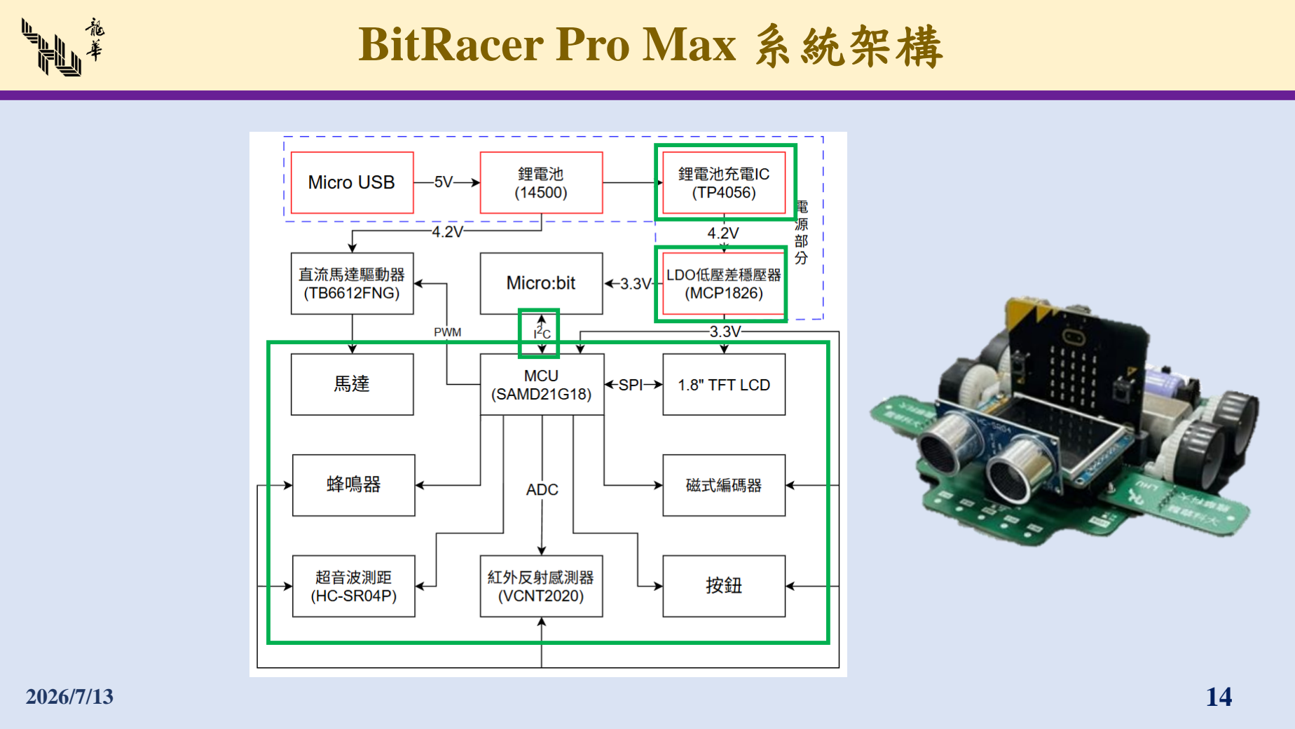
[picture p142: page 14]

2026/7/13 | 14

# 雙平台軟韌體架構

15

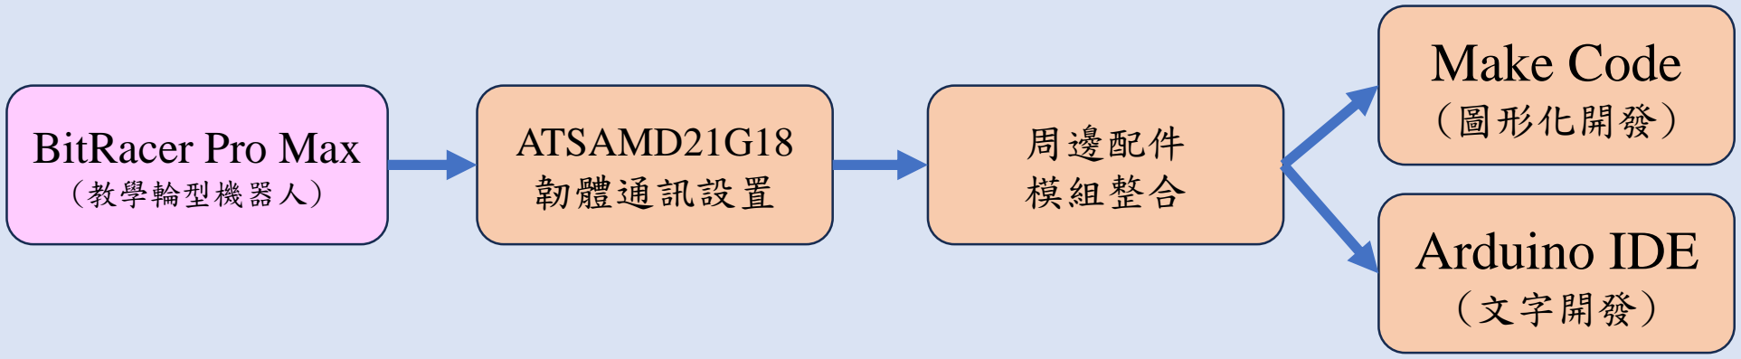
[picture p143: figure]
ATSAMD21G18 韌體通訊設置; 周邊配件 模組整合; Arduino IDE (文字開發); Make Code (圖形化開發); BitRacer Pro Max (教學輪型機器人)

# I2C通訊協定

## - 透過I2C傳輸資料

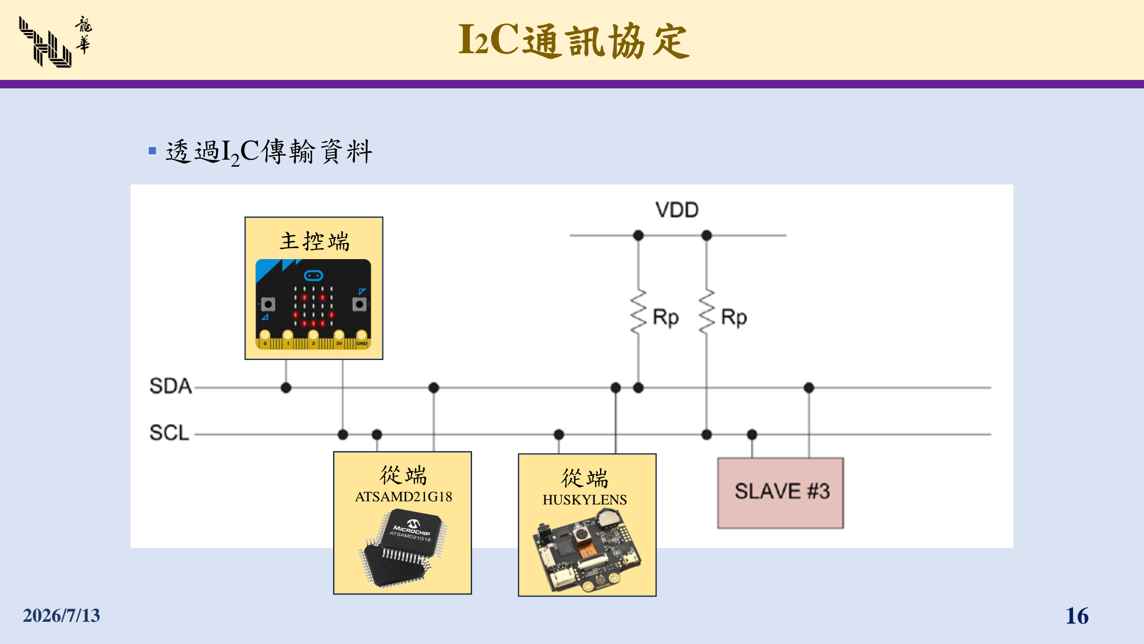
[picture p144: page 16]

從端

N76E003AT20

主控端

從端

HUSKYLENS

從端

ATSAMD21G18

16

# BitRacer Pro Max基礎命令功能

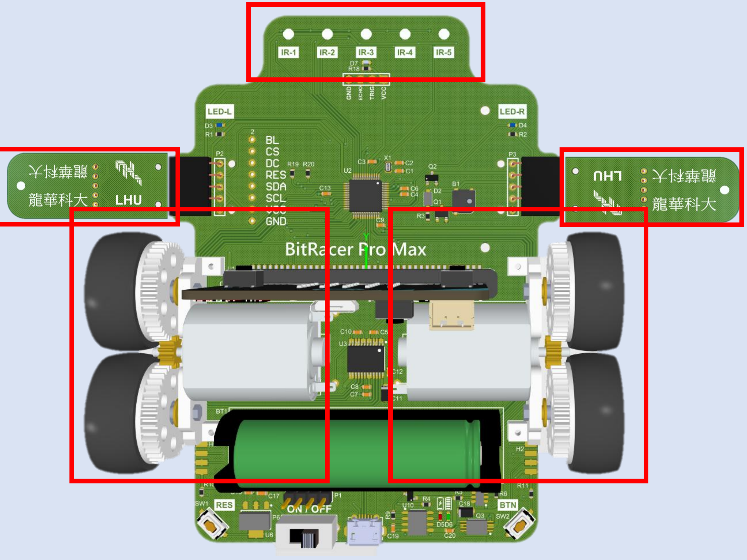
[picture p145: figure]

功能 | 命令編號 | 讀/寫
馬達左輪 | 0x20 | W
馬達右輪 | 0x21 | W
馬達雙輪 | 0x22 | W
讀取IR-1 | 0x30 | R
讀取IR-2 | 0x31 | R
讀取IR-3 | 0x32 | R
讀取IR-4 | 0x33 | R
讀取IR-5 | 0x34 | R
讀取IR-L | 0x35 | R
讀取IR-R | 0x36 | R
控制 IR 開關 | 0x37 | W
讀取所有IR | 0x38 | R

17

# BitRacer Pro Max周邊命令功能

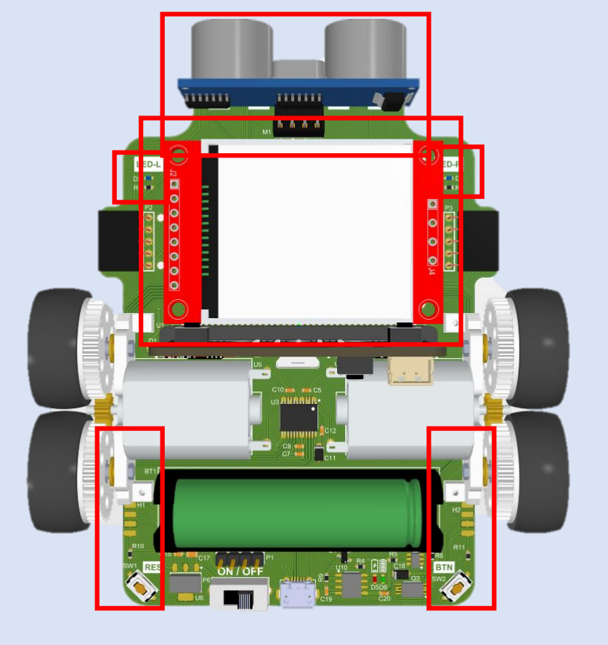
[picture p146: figure]

功能 | 命令編號 | 讀/寫
讀取編碼器數值 | 0x40 | R
編碼器歸零 | 0x41 | W
LED 控制 | 0x42 | W
讀取超音波距離 | 0x43 | R
顯示文字/數字 | 0x44 | W
清除畫面 | 0x45 | W
顯示圖片 | 0x46 | W
設定背景顏色 | 0x47 | W

18

目錄

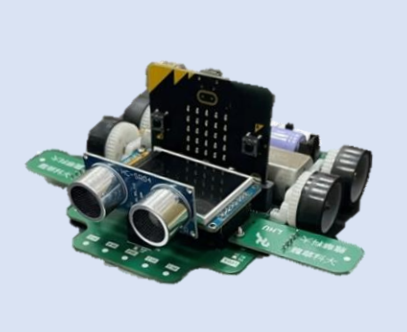
[picture p147: figure]

MakeCode積木單元化設計

### 1 發展環境 & 擴展積木 2 紅外線數值 & 正規化 3 賽道位置數據估測 4 比例差分回授控制 5 超音波距離監控

### 6 編碼器 & LCD螢幕顯示

19

# 發展環境 & 擴展積木

### - 使用Microsoft MakeCode 開發環境

積木的停車程式
https://makecode.microbit.org/S92273-39996-50243-07370

20

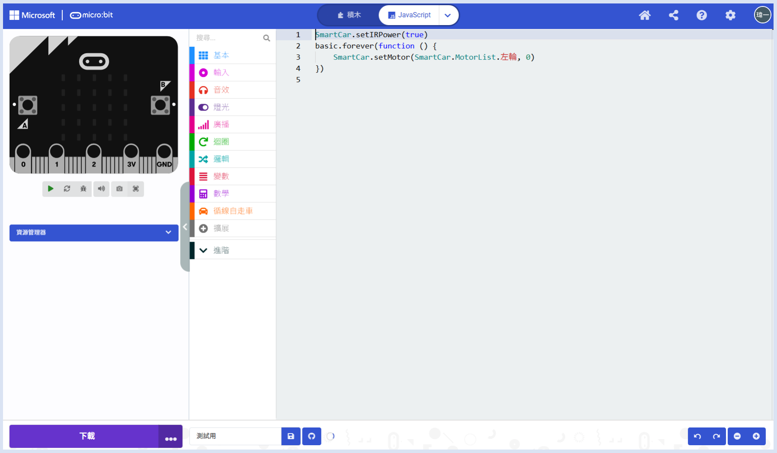
[picture p148: figure]

# 發展環境 & 擴展積木

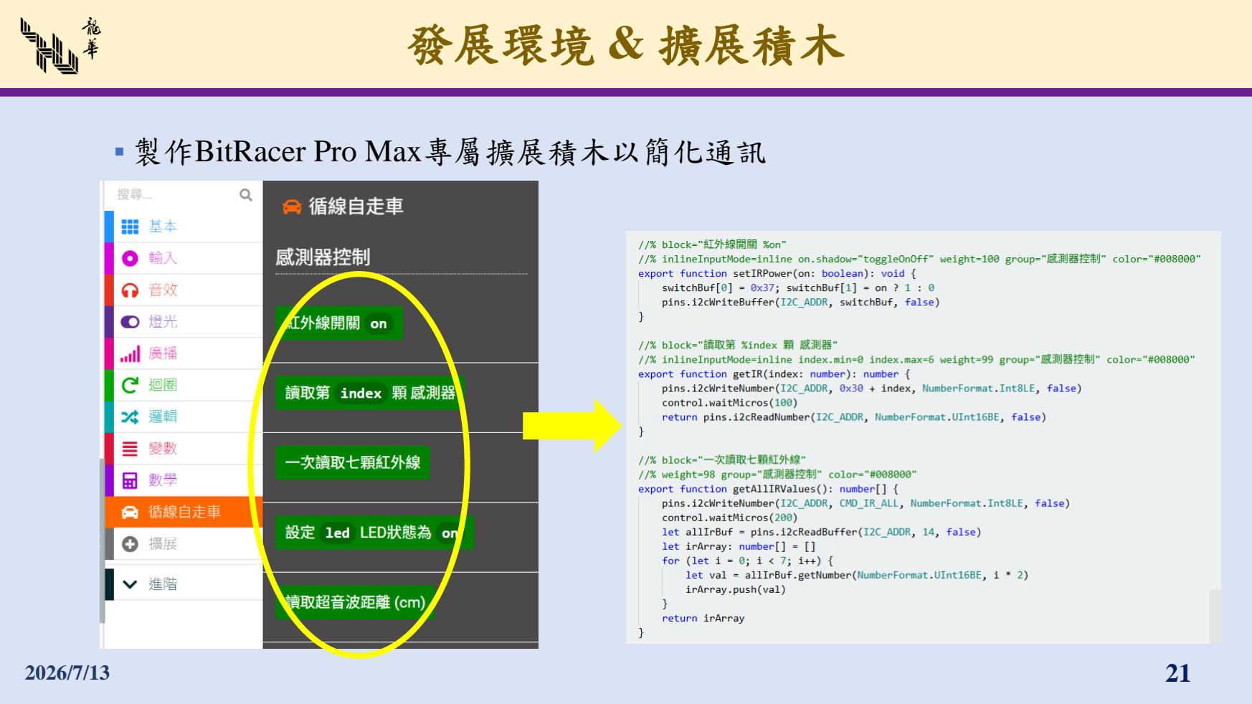
[picture p149: page 21]

### - 製作BitRacer Pro Max專屬擴展積木以簡化通訊

21

# MakeCode積木設計

# 紅外線數值 & 歸一化

22

# 紅外線數值 & 歸一化

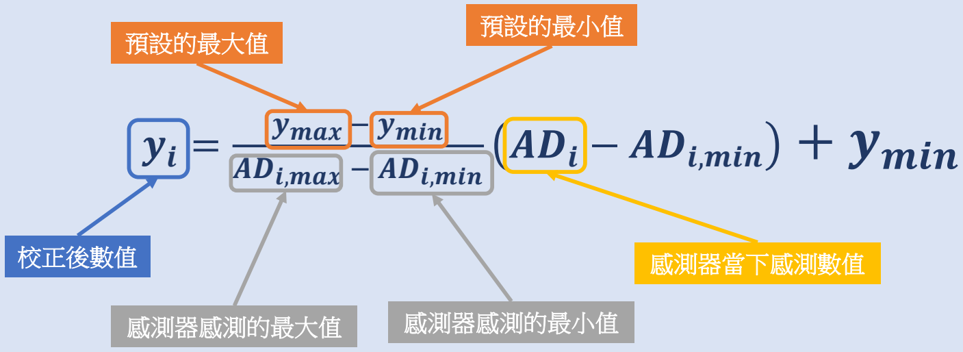
[picture p150: figure]
ymax − ymin; ADi,max − ADi,min; ADi − ADi,min + ymin; 預設的最大值; 預設的最小值; 校正後數值; 感測器感測的最大值; 感測器感測的最小值; 感測器當下感測數值

=

5000−0
4000−100
校正後數值 | 2000 − 0 +0 ≅ 2500
- 學習目標:讓學生了解「如何校正不同紅外線感測器間的輸出值」。

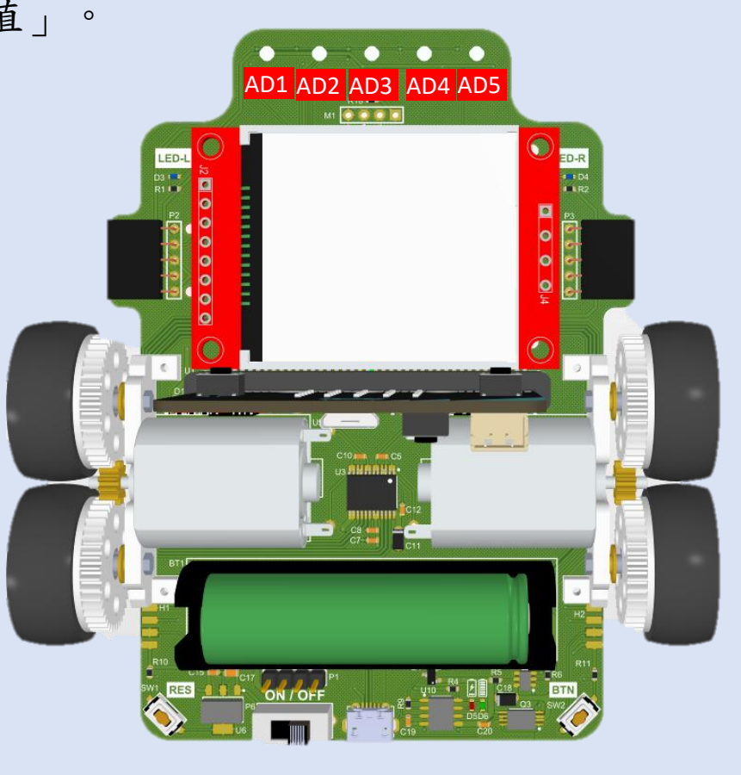
[picture p151: figure]

23

# 紅外線數值 & 歸一化

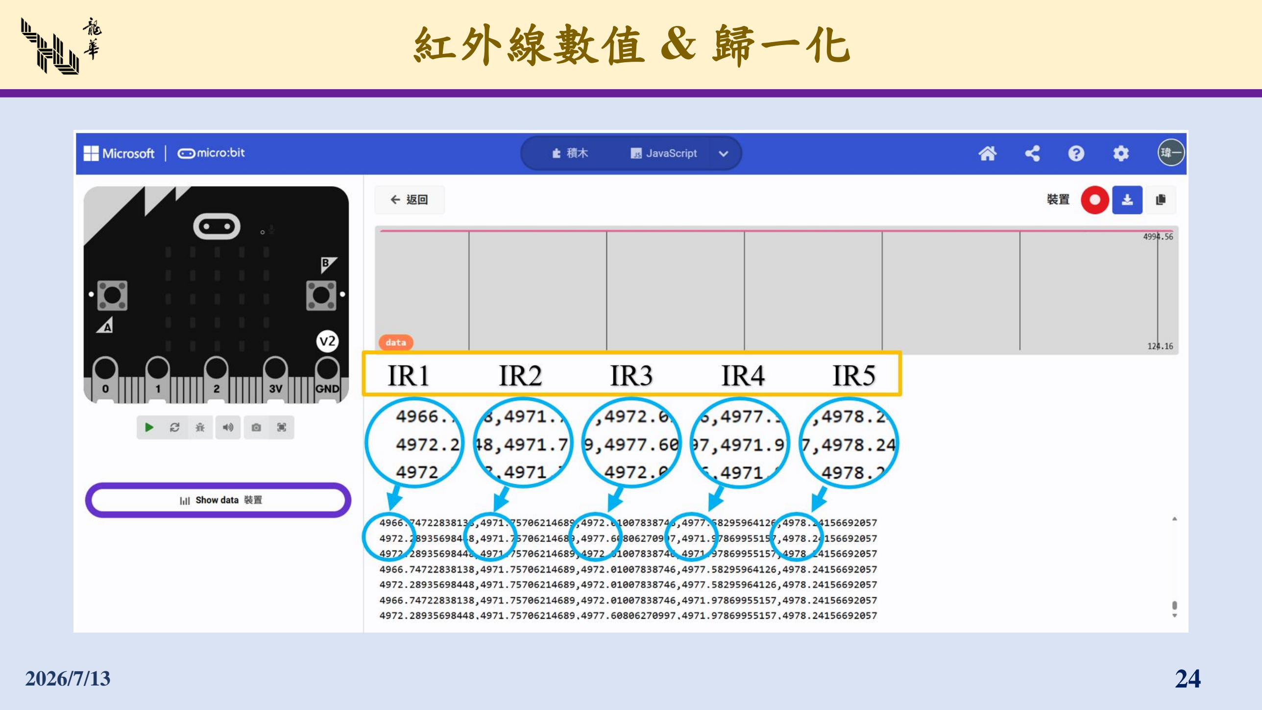
[picture p152: page 24]

2026/7/13 | 24

# MakeCode積木設計

# 賽道位置數據估測

25

# 賽道位置數據估測

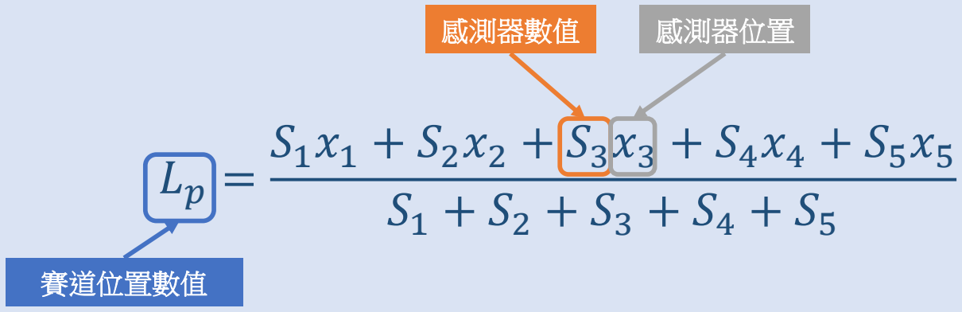
[picture p153: figure]
賽道位置數值; 感測器數值; 感測器位置
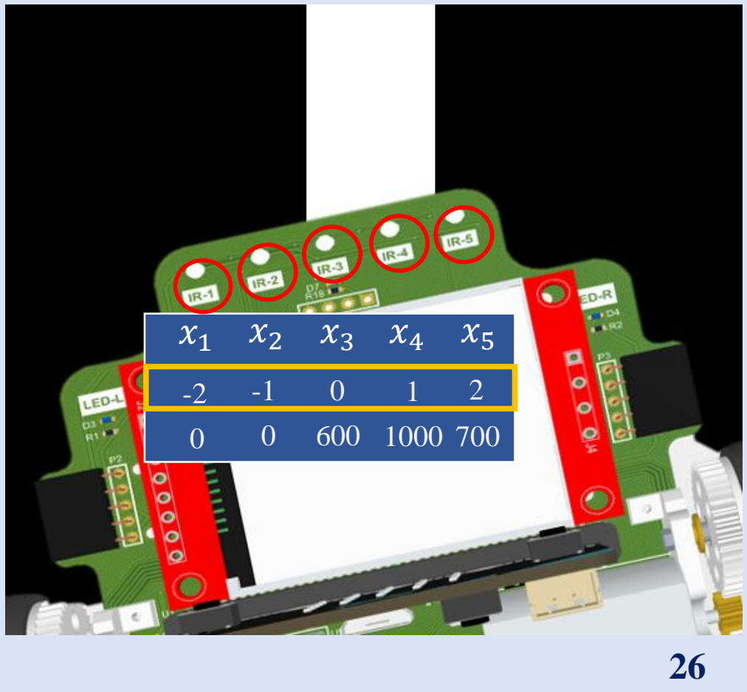
[picture p154: figure]

Lp =

700 ∗ 2 + 1000 ∗ 1 + 600 ∗ 0 + 0 ∗ −1 + 0 ∗ −2 700 + 1000 + 600 + 0 + 0

=

2400
2300

= 1.0434

- 學習目標:讓學生們了解「如何利用紅外線數值計算出賽道的位置」。

# 賽道位置數據估測

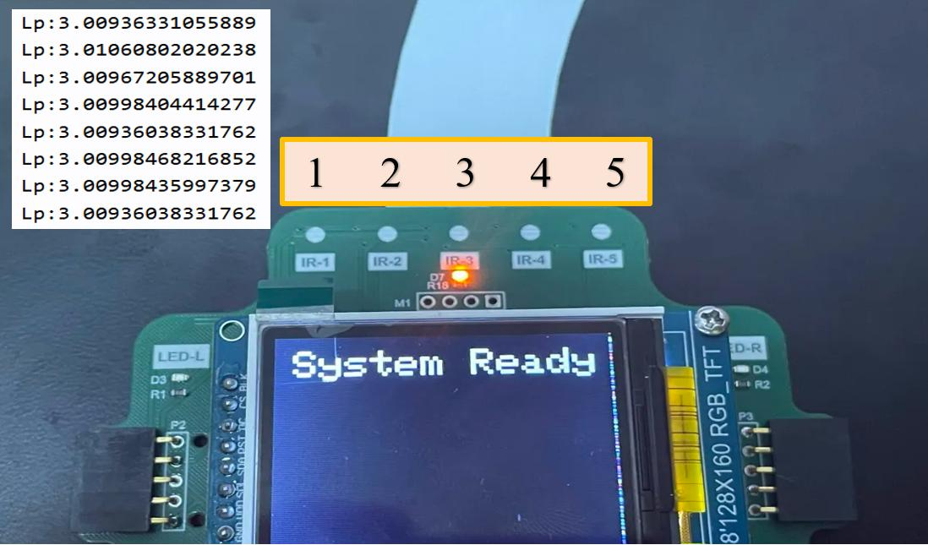
[picture p155: figure]

2026/7/13 | 27

# MakeCode積木設計

# 比例差分回授控制

28

# 比例差分回授控制

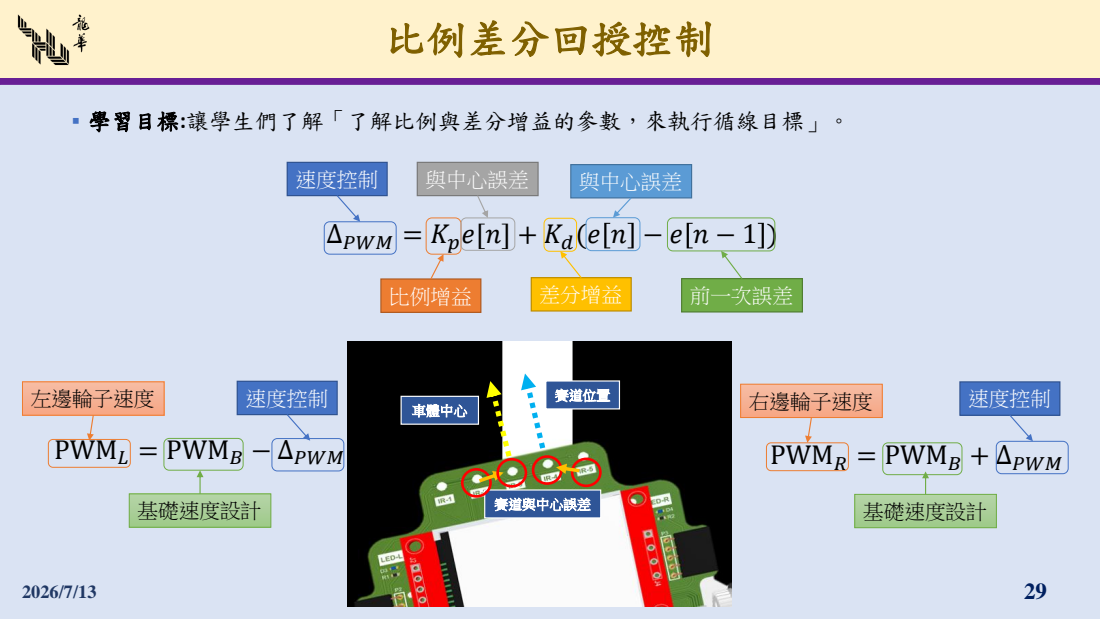
[picture p156: page 29]
ΔPWM = Kpe[n] + Kd(e; 速度控制; 比例增益; 差分增益; 與中心誤差; 前一次誤差; 基礎速度設計; 左邊輪子速度; 車體中心; 賽道位置; 右邊輪子速度; 賽道與中心誤差

▪ 學習目標:讓學生們了解「了解比例與差分增益的參數，來執行循線目標」。

PWMR = PWMB + ΔPWM PWML = PWMB − ΔPWM

# 比例差分回授控制

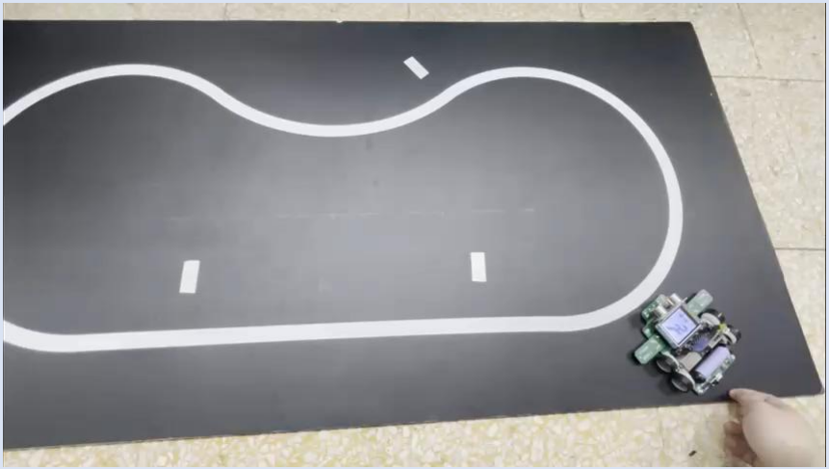
[picture p157: figure]

2026/7/13 | 30

# MakeCode積木設計

# 超音波距離監控

31

# 超音波距離監控

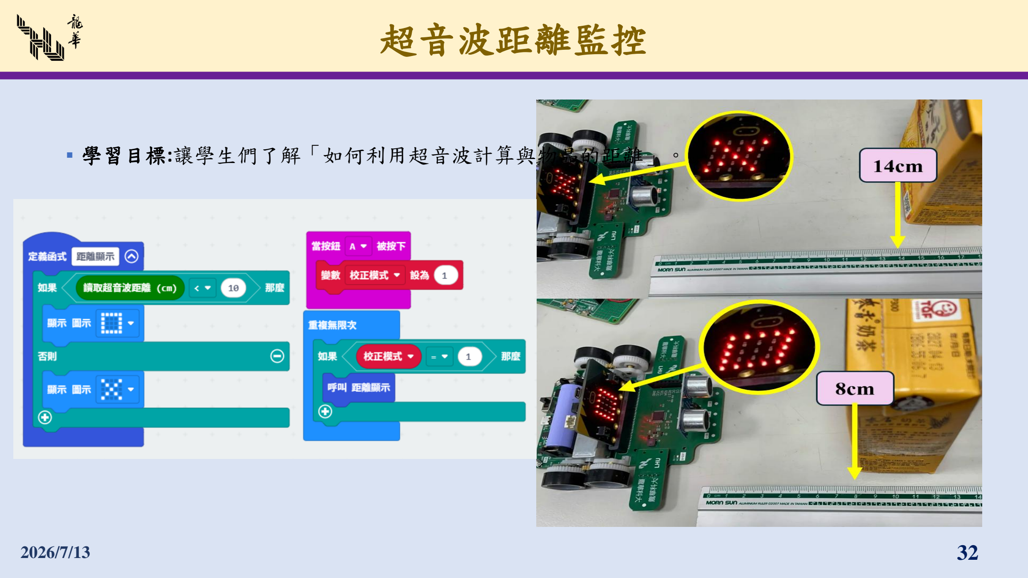
[picture p158: page 32]

D =

t × 340
2

距離(公分)

持續時間

每秒聲速(公尺)
來回
- 學習目標:讓學生們了解「如何利用超音波計算與物品的距離」。

32

# MakeCode積木設計

# 編碼器 & LCD螢幕顯示

33

# 編碼器 & LCD螢幕顯示

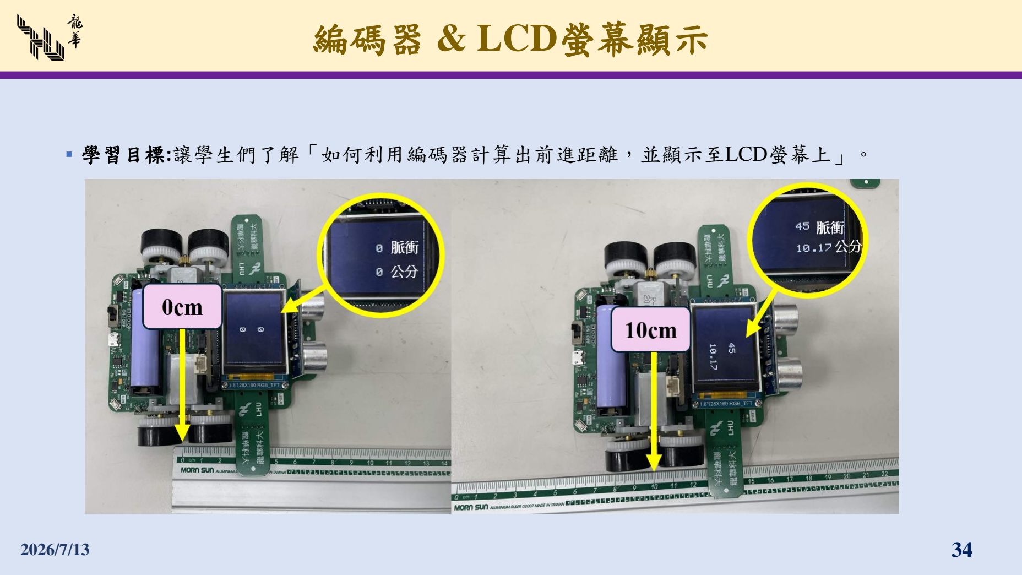
[picture p159: page 34]

d =

## PL + PR

2

×

π × 23
32

距離(毫米)

馬達脈衝數值

兩輪平均

輪直徑

脈衝數

- 學習目標:讓學生們了解「如何利用編碼器計算出前進距離，並顯示至LCD螢幕上」。

34

# MakeCode積木程式設計

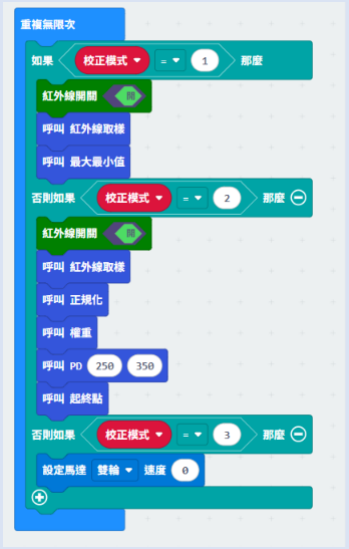
[picture p160: figure]

2026/7/13 | 35

# MakeCode積木程式設計

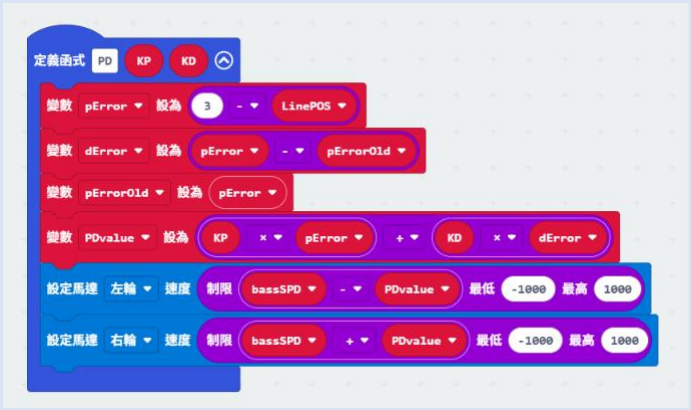
[picture p161: figure]

2026/7/13 | 36

# MakeCode積木程式設計

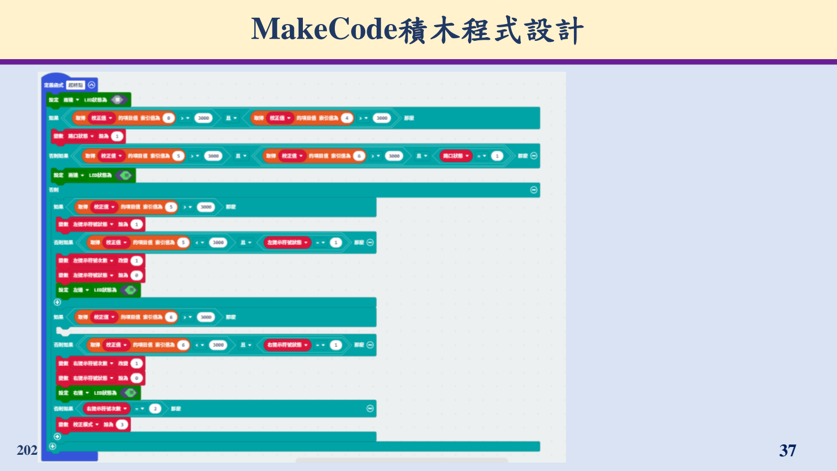
[picture p162: page 37]

2026/7/13 | 37

# MakeCode積木程式設計

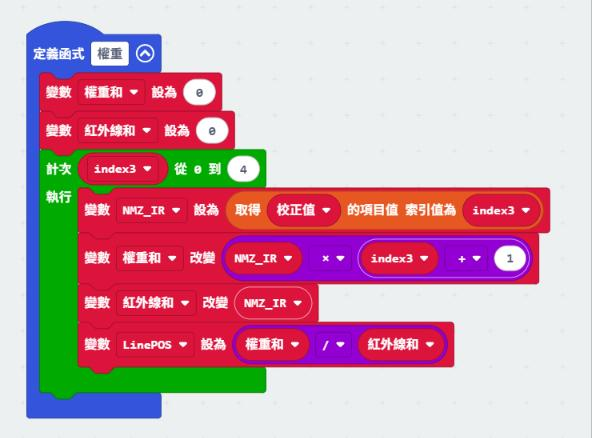
[picture p163: figure]

2026/7/13 | 38

# MakeCode積木程式設計

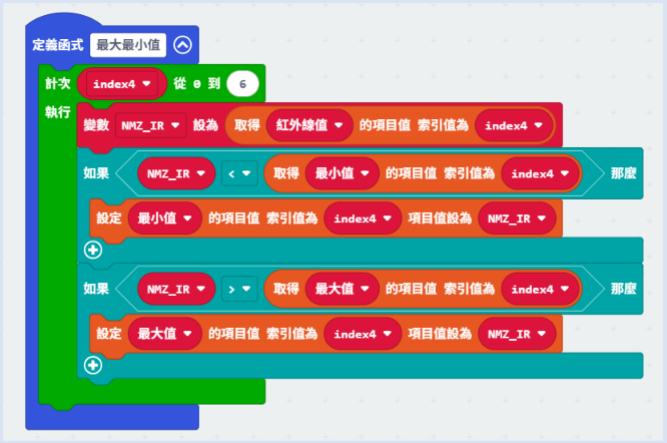
[picture p164: figure]

2026/7/13 | 39

# MakeCode積木程式設計

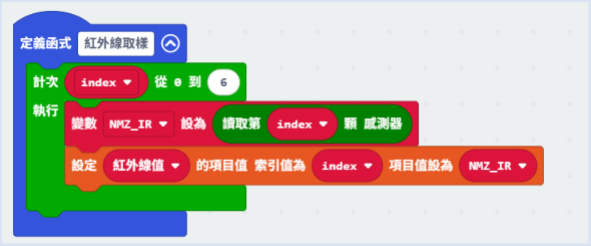
[picture p165: figure]

2026/7/13 | 40

# MakeCode積木程式設計

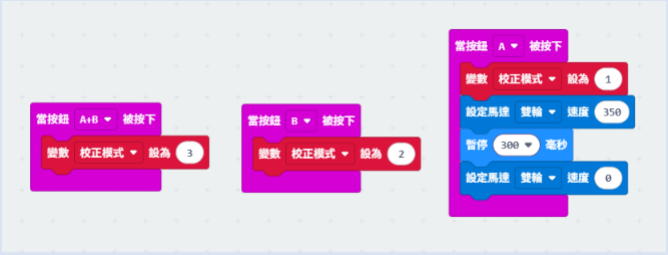
[picture p166: figure]

2026/7/13 | 41

# MakeCode積木程式設計

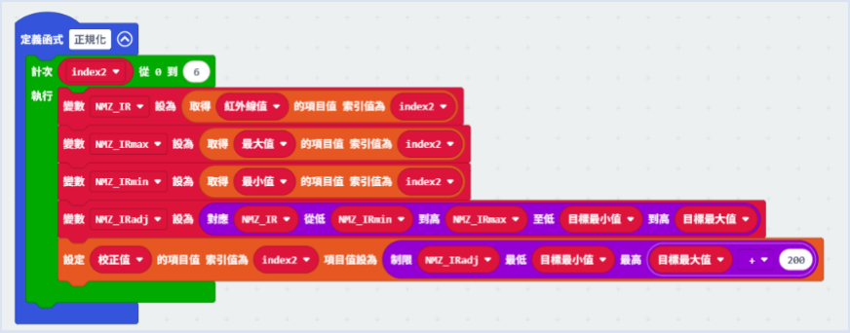
[picture p167: figure]

2026/7/13 | 42

# MakeCode積木程式設計

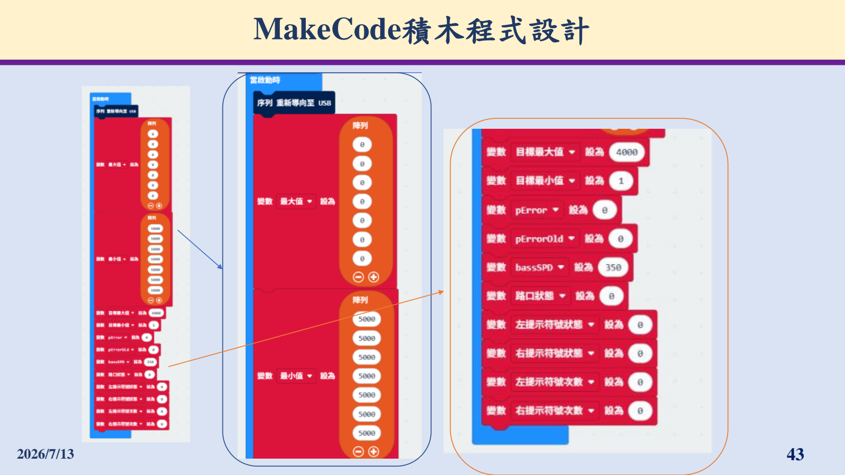
[picture p168: page 43]

2026/7/13 | 43

# Arduino IDE程式設計

2026/7/13 | 44
定義腳位 | //------紅外線感測器控制-----// #define IR_1 A6 #define IR_2 A5 #define IR_3 A4 #define IR_4 A3 #define IR_5 A0 #define IR_L A2 #define IR_R A1 #define IRcontrol 13 //------LED&BUT控制-----// #define LED_R 30 //LED燈右邊 #define LED_L 31 //LED燈左邊 #define BUTTON 25 //按鈕 //-------馬達控制-----------// #define PWML 2 //左邊馬達腳 #define BIN_1 28 //左邊馬達正反腳

1
| #define BIN_2 29 //左邊馬達正反腳
2
| #define AIN_1 32 //右邊馬達正反腳
1
| #define AIN_2 33 //右邊馬達正反腳
2
| #define PWMR 3 //右邊馬達腳

2026/7/13 | 45

//-------速度PD種控制-----------// #define kp 100 //100
#define kd 200 //200

#define Basic_speed 100

//-------陣列設置--------------//
int IR[7] = { 0 }; | //紅外線初始值
int IR_Max[7] = { 1, 1, 1, 1, 1, 1, 1 }; | //紅外線最大
初始值
int IR_Min[7] = { 1023, 1023, 1023, 1023, 1023, 1023, 1023 }; //紅外線最小初始值
float IR_Nor[7] = { 0 }; | //紅外線正規化初
始值
//-------變數設置--------------//
float x = 0, err = 0, ekd = 0, errold = 0;
int pd = 0; //L = 0;
int L_Cnt = 0, R_Cnt = 0;

定義參數

# 初始設定

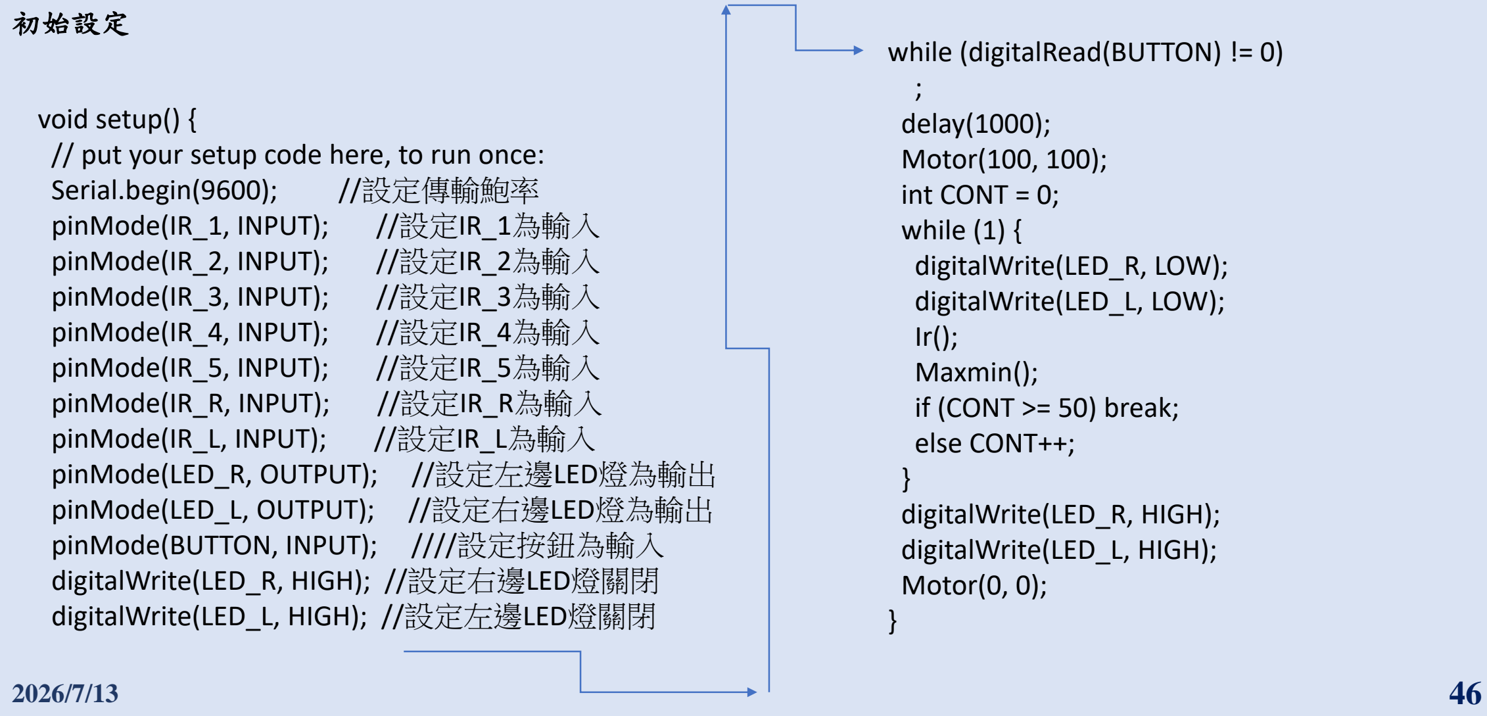
[picture p169: figure]
void setup() {; Serial.begin(9600);; //設定傳輸鮑率; pinMode(IR_1, INPUT);; //設定IR_1為輸入; pinMode(IR_2, INPUT);; //設定IR_2為輸入; pinMode(IR_3, INPUT);; //設定IR_3為輸入; pinMode(IR_4, INPUT);; //設定IR_4為輸入; pinMode(IR_5, INPUT);; //設定IR_5為輸入; pinMode(IR_R, INPUT);; //設定IR_R為輸入; pinMode(IR_L, INPUT);; //設定IR_L為輸入; pinMode(LED_R, OUTPUT); //設定左邊LED燈為輸出 pinMode(LED_L, OUTPUT); //設定右邊LED燈為輸出 pinMode(BUTTON, INPUT); ////設定按鈕為輸入 digitalWrite(LED_R, HIGH); //設定右邊LED燈關閉 digitalWrite(LED_L, HIGH); //設定左邊LED燈關閉; while (digitalRead(BUTTON) != 0) ; delay(1000); Motor(100, 100); int CONT = 0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

// put your setup code here, to run once:

# 主程式

2026/7/13 | 47

void loop() {
while (digitalRead(BUTTON) == 0) { delay(1000);
while (1) {
follow();
prompt();
if (R_Cnt == 2) {
follow();
delay(400);
break;
}
}
while (1) {
Motor(0, 0);
}
}
}

主程式

void follow() {
Ir(); | //呼叫Ir副程式
Nor(); | //呼叫正規劃副程式
weights(); //呼叫權重副程式
Print1();
}

副程式

1

# 副程式

# -紅外線控制

2026/7/13 | 48

void Ir() //Ir副程式 {

digitalWrite(IRcontrol, HIGH); //開啟紅外線
IR[6] = analogRead(IR_L); //讀取IR_L的數值並儲存在IR 陣 列第
6

位
IR[0] = analogRead(IR_R); //讀取IR_R的數值並儲存在IR

陣
列第
0

位
IR[3] = analogRead(IR_3); //讀取IR_3的數值並儲存在IR 陣 列第
3

位
IR[4] = analogRead(IR_4); //讀取IR_4的數值並儲存在IR 陣 列第
4

位
IR[2] = analogRead(IR_2); //讀取IR_2的數值並儲存在IR 陣 列第
2

位
IR[5] = analogRead(IR_5); //讀取IR_5的數值並儲存在IR 陣 列第
5

位
IR[1] = analogRead(IR_1); //讀取IR_1的數值並儲存在IR 陣 列第
1

位
digitalWrite(IRcontrol, LOW); //關閉紅外線 }

副程式

2

# 視窗監控

2026/7/13 | 49

void Print1() //顯示副程式
{

// Serial.print(IR[1]); //顯示IR陣列第0位的數值 // Serial.print(" \t "); //顯示空格
// Serial.print(IR[2]); //顯示IR陣列第1位的數值 // Serial.print(" \t "); //顯示空格
// Serial.print(IR[3]); //顯示IR陣列第2位的數值 // Serial.print(" \t "); //顯示空格
// Serial.print(IR[4]); //顯示IR陣列第3位的數值 // Serial.print(" \t "); //顯示空格
// Serial.print(IR[5]); //顯示IR陣列第4位的數值 //
//
// Serial.print(" Nor: "); //顯示正規劃
// Serial.print(IR_Nor[1]); //顯示正規劃後IR陣列的第0位的 數值
// Serial.print(" \t "); //顯示空格
// Serial.print(IR_Nor[2]); //顯示正規劃後IR陣列的第1位的 數值

// Serial.print(" \t "); //顯示空格
// Serial.print(IR_Nor[3]); //顯示正規劃後IR陣列的第2位的 數值
// Serial.print(" \t "); //顯示空格
// Serial.print(IR_Nor[4]); //顯示正規劃後IR陣列的第3位的 數值
// Serial.print(" \t "); //顯示空格
// Serial.print(IR_Nor[5]); //顯示正規劃後IR陣列的第3位的 數值
// Serial.print(" \t "); //顯示空格

# 副程式-最大值與最小值、歸一化

2026/7/13 | 50

void Maxmin() //最大最小值副程式
{
Ir(); | //Ir副程式
for (int j = 0; j < 6; j++) //迴圈(j開始0; j小於6; j加1) {
if (IR[j] > IR_Max[j]) //如果(IR[j]大於IR[j]_最大) {
IR_Max[j] = IR[j]; //IR[j]_最大等於IR[j]
}
if (IR[j] < IR_Min[j]) //如果(IR[j]小於IR[j]_最小) {
IR_Min[j] = IR[j]; //IR[j]_最小等於IR[j]
}
}
}

void Nor() //歸一化副程式
{
for (int i = 0; i < 6; i++) //迴圈(i開始0; i小於6; i加1) {
IR_Nor[i] = (1023.0 / (IR_Max[i] - IR_Min[i])) * (IR[i] -IR_Min[i]);
if (IR_Nor[i] > 1023) //如果正規化後的IR[i]大於1023 {
IR_Nor[i] = 1023; //規化後的IR[i]等於1023
}
if (IR_Nor[i] < 1) //如果正規化後的IR[i]小於1 {
IR_Nor[i] = 1; //規化後的IR[i]等於1
}
}
}

# 副程式

# -權重與PD控制

2026/7/13 | 51

void weights() //權重 {

char mode = 'C';
if (mode == 'C') {
if (IR_Nor[1] > 700 || IR_Nor[2] > 700 || IR_Nor[3] > 700 || IR_Nor[4] > 700 || IR_Nor[5] > 700)
x = (IR_Nor[1] *

-2.0 + IR_Nor[2] *

-1.0 + IR_Nor[3] * 0 +
IR_Nor[4] * 1.0 + IR_Nor[5] * 2.0) / (IR_Nor[1] + IR_Nor[2] + IR_Nor[3] + IR_Nor[4] + IR_Nor[5]);
} //(規化後的IR[1]

乘

2加規化後的IR[2]

乘

1加規化後的IR[3]
乘

0加規化後的IR[4]

乘

1加規化後的IR[5]

乘2)

除

(規化後的IR[1]
加規化後的IR[2]加規化後的IR[3]加規化後的IR[4]加規化後的 IR[5])

errold = err;
err = 0
- x;
ekd = err
- errold;
pd = (kp * err) + (kd * ekd); Motor(Basic_speed
- pd, Basic_speed + pd);
}

# 副程式-驅動馬達

2026/7/13 | 52

void Motor(int16_t PWM_L, int16_t PWM_R) { if (PWM_R >= 255) PWM_R = 255;
else if (PWM_R <= -255) PWM_R = -255;
if (PWM_L >= 255) PWM_L = 255;
else if (PWM_L <= -255) PWM_L = -255;
if (PWM_L >= 0) {
digitalWrite(BIN_1, HIGH); //設定左邊馬達正反腳1為1 digitalWrite(BIN_2, LOW); //設定左邊馬達正反腳1為0 analogWrite(PWML, PWM_L); //設定左邊馬達速度為40 } else {
digitalWrite(BIN_1, LOW);
digitalWrite(BIN_2, HIGH);
analogWrite(PWML, abs(PWM_L)); }
if (PWM_R >= 0) {
digitalWrite(AIN_1, LOW);
digitalWrite(AIN_2, HIGH); analogWrite(PWMR, PWM_R);
}

else {
digitalWrite(AIN_1, HIGH); digitalWrite(AIN_2, LOW);
analogWrite(PWMR, abs(PWM_R)); }
}

# 副程式-提示符號控制

2026/7/13 | 53

void prompt() {
static int L_status = 0, R_status = 0, C_status = 0;
if (C_status == 0 && IR[1] > 600 && IR[3] > 600 && IR[5] > 600) {
C_status = 1;
digitalWrite(LED_L, LOW);
digitalWrite(LED_R, LOW);
} else if (C_status == 1) {
if (IR[6] > 400) L_status = 1;
if (IR[0] > 400) R_status = 1;
else if (L_status == 1 && R_status == 1 && IR[6] < 400 && IR[0] < 400) {
digitalWrite(LED_L, HIGH);
digitalWrite(LED_R, HIGH);
L_status = 0;
R_status = 0;
C_status = 0;
}
}

else {
if (L_status == 0 && IR[6] > 400) { L_status = 1;
digitalWrite(LED_L, LOW);
} else if (L_status == 1 && IR[6] < 400) { digitalWrite(LED_L, HIGH);
L_status = 0;
L_Cnt++;
}

if (R_status == 0 && IR[0] > 400) { R_status = 1;
digitalWrite(LED_R, LOW);
} else if (R_status == 1 && IR[0] < 400) { digitalWrite(LED_R, HIGH);
R_status = 0;
R_Cnt++;
}
}
}

# 實際應用與結論

# BitRacer Pro Max 教學輪型機器人

# 實際應用

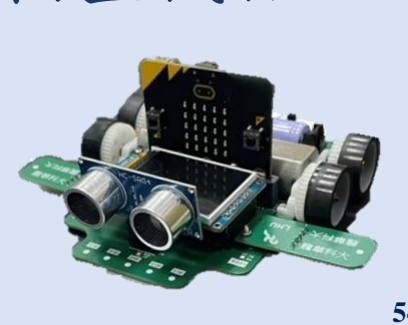
[picture p170: figure]

54

# BitRacer Pro Max 教學輪型機器人

### - Microsoft MakeCode

55

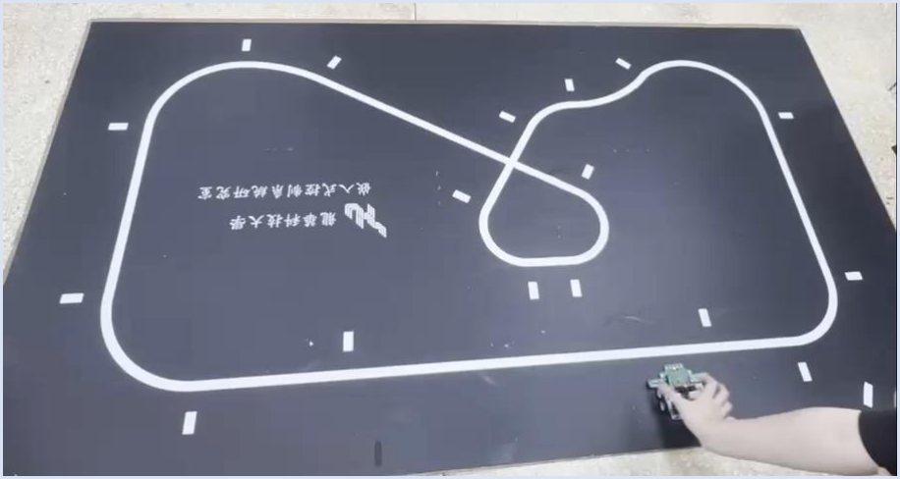
[picture p171: figure]

# BitRacer Pro Max 教學輪型機器人

### - Arduino IDE

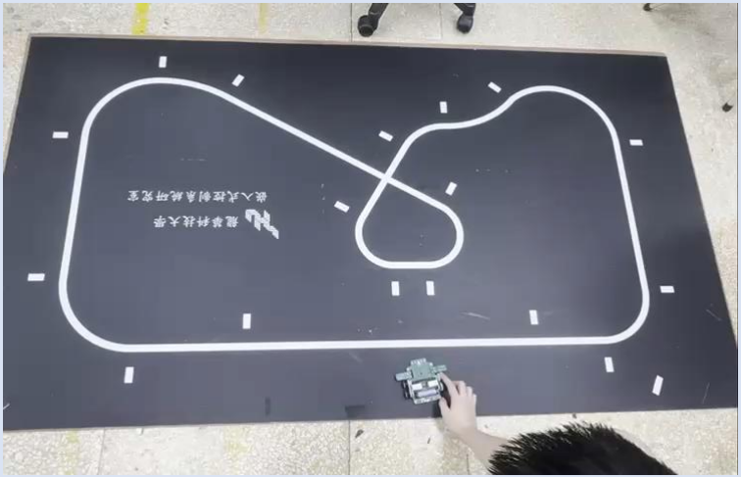
[picture p172: figure]

56

# BitRacer Pro Max 教學輪型機器人

## - 計算場地總長

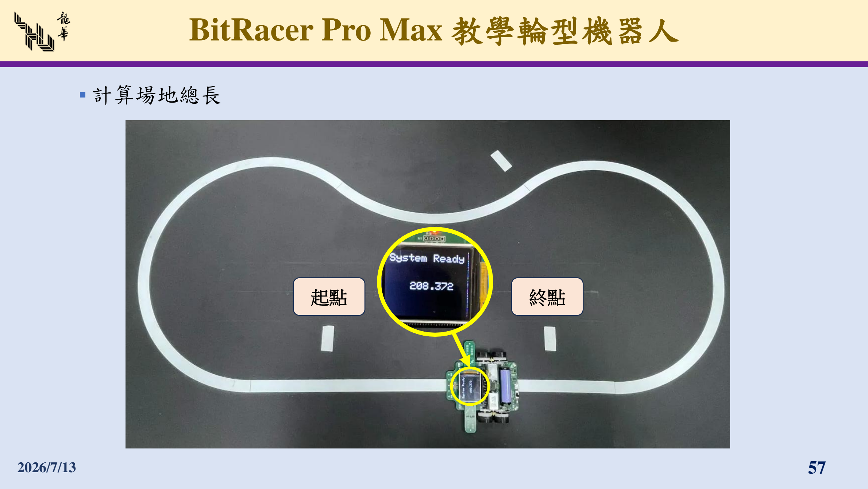
[picture p173: page 57]

起點 | 終點

57

結論

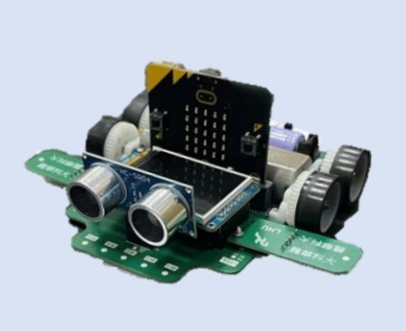
[picture p174: figure]

## BitRacer Pro Max教學輪型機器人，則

## 是以雙平台架構為主並保留了Arduino 的硬體與感測器驅動，開發了專屬的 MakeCode擴充積木。這使得這台教具 『教育的易用性』，讓不同年齡層的學 生都能輕鬆跨過學習門檻。

58

結論

### - 將擴展積木分享至Github https://github.com/CorgiQQQ/BitRacer_Pro_Max

59

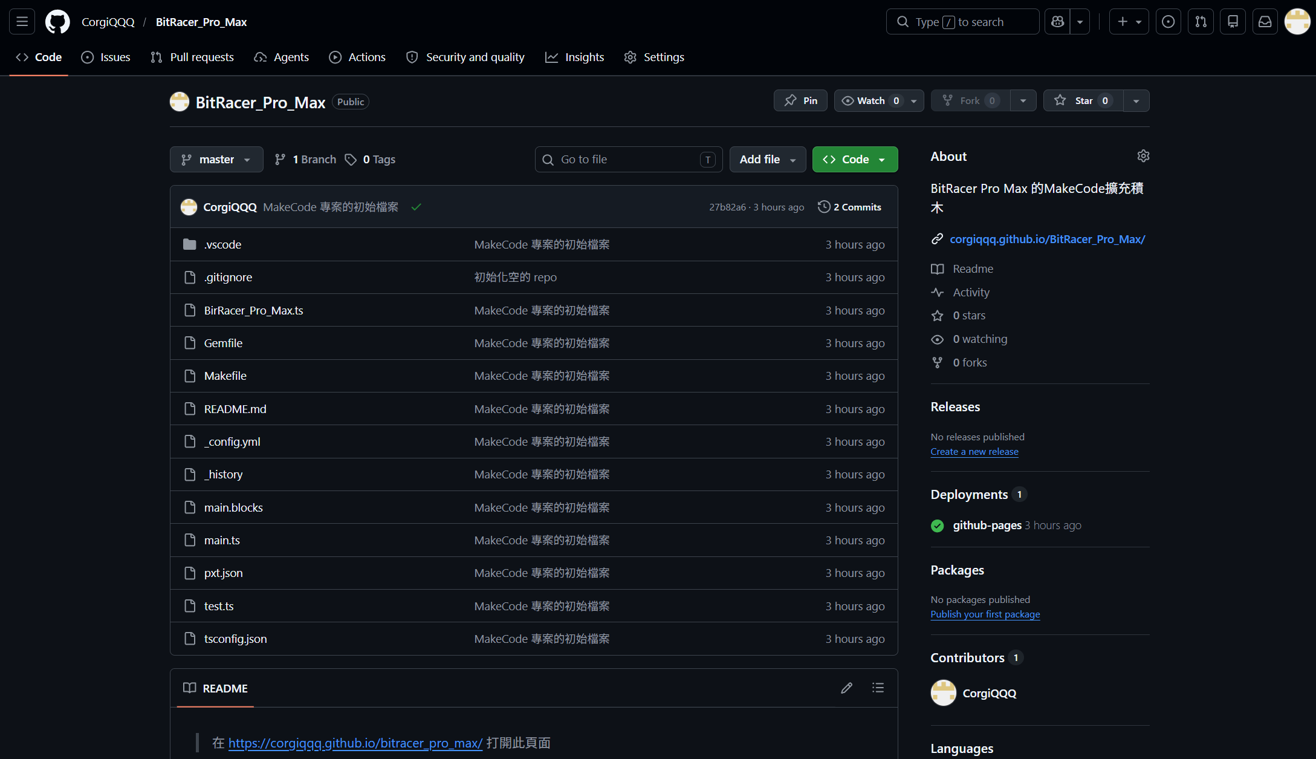
[picture p175: figure]

Q
&

A

60
