lili-lines/ratatouille/test/traduction-2-plan-campus.md

# Annexe 2 — Plan du campus (traduction FR)

*Fichier original : `附件2-龍華科大平面圖-研習營位置.pdf`*
*Université : Lunghwa University of Science and Technology (龍華科技大學)*

## 📍 Lieu du stage
**Bâtiment C (C棟) — Département de génie électronique** (電子工程系 / Department of Electronic Engineering), repéré par le **cadre/épingle rouge** sur le plan.
Entrée du campus : **校門** (portail, flèche rouge en bas), près du bâtiment N.

## Principaux bâtiments
| Repère | Nom |
|---|---|
| A | Génie mécanique 2 (Mechanical Eng. Building 2) |
| B | Génie mécanique 1 |
| **C** | **Génie électronique ← stage** |
| D | Restaurant + Centre d'incubation |
| E | Centre de recherche plasma / instruments |
| F | Bâtiment polyvalent (info, génie électrique, réseaux) |
| G | Bâtiment multimédia |
| H | Génie des semi-conducteurs + cafétéria |
| K | Bâtiment commerce (finance, gestion, marketing) |
| L | Bibliothèque universitaire (Faming Building) |
| M | Dortoir garçons |
| N | Bâtiment Faming : salles intelligentes, administration, sécurité |
| P | Centre de langues |
| S | Bâtiment d'enseignement 1 |
| T | Bâtiment d'enseignement 2 (amphis, tourisme/loisirs, sécurité campus) |
| U | Centre d'activités étudiantes + services étudiants + café |
| W | Dortoir filles 1 |

Autres repères : parkings (P), distributeurs (ATM), boîte aux lettres, place « Star Square », dortoirs 2 et 3, poste de sécurité.
