lili-lines/ratatouille/test/附件2-龍華科大平面圖-研習營位置.pdf

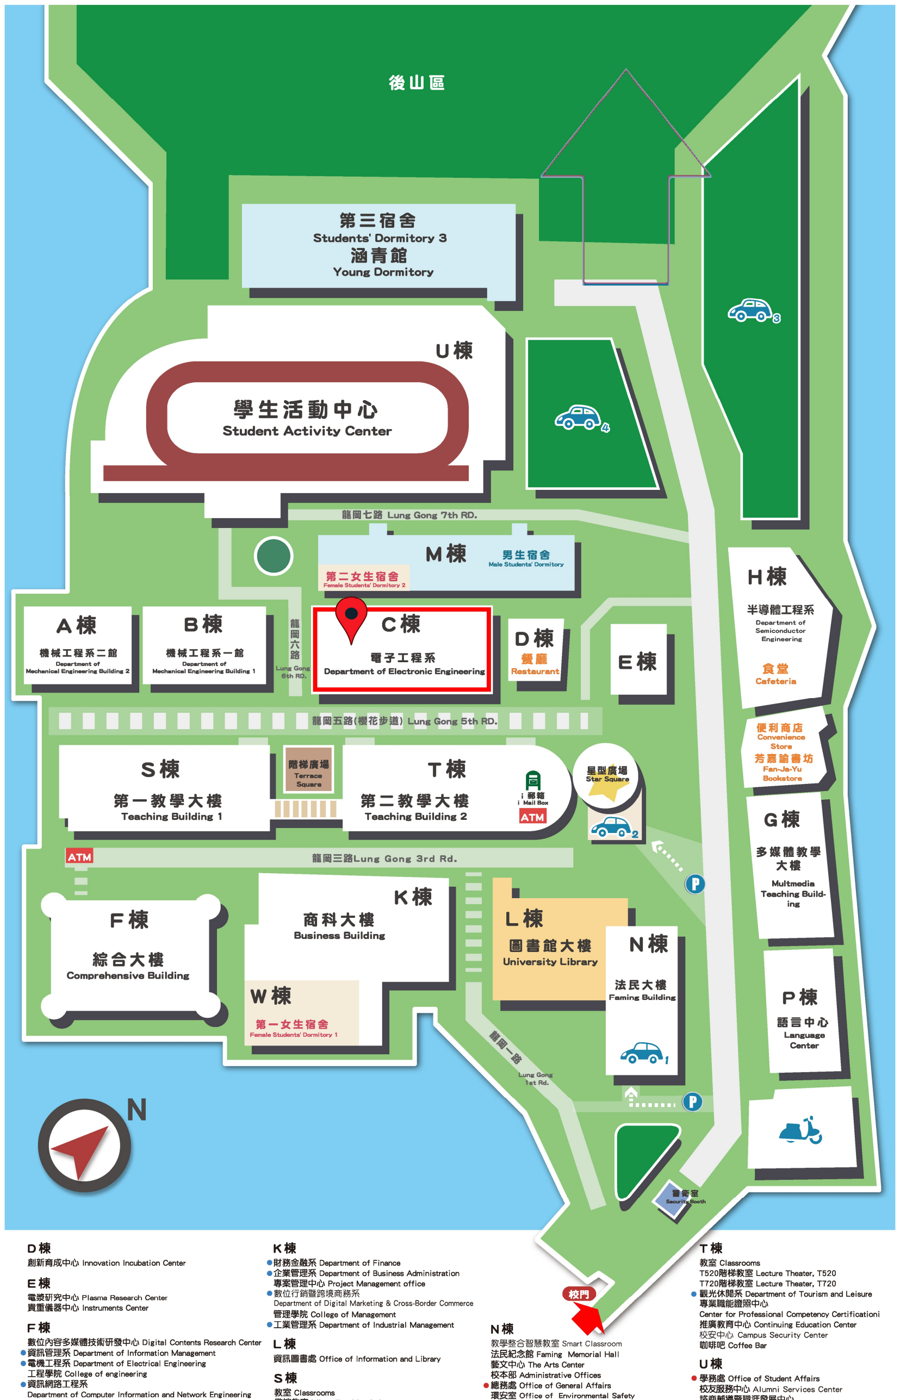
[picture p176: page 1]
