lili-lines/ratatouille/test/附件1-研習營流程.tif

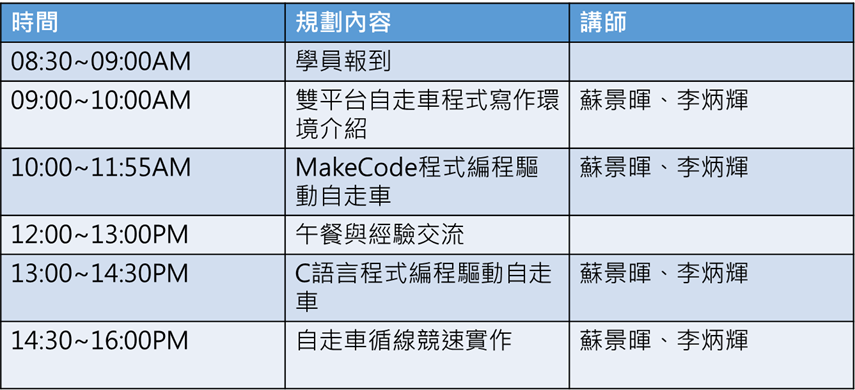
test/附件1-研習營流程.tif
