lili-lines/ratatouille/(commit log)

2026-06-28 maj bom
2026-06-29 maj thme + post mustache start
    [berceau_motor.stl]
2026-08-03 maj odometry
    [bras.stl, module-moustache2.stl]
2026-09-04 maj post
    [xp1_whisker_log_1786722526.csv, xp_motor0_odometry_log_1786865483.csv, xp_motor0_odometry_log_1786866265.csv, xp_motor130_noCondD_whisker_log_1786773717.csv, xp_motor130_noCondD_whisker_log_1786774641.csv, xp_motor130_noCondR_whisker_log_1786773834.csv, xp_motor130_noCondR_whisker_log_1786774712.csv, xp_motor130_noRC_whisker_log_1786773494.csv]
2026-09-13 maj wiring et xps
    [jeton_corps.3mf, jeton_corps.FCStd, jeton_river3d.3mf, river.FCStd]
