lili-lines/ratatouille/assets/img/IMG_9714.JPG

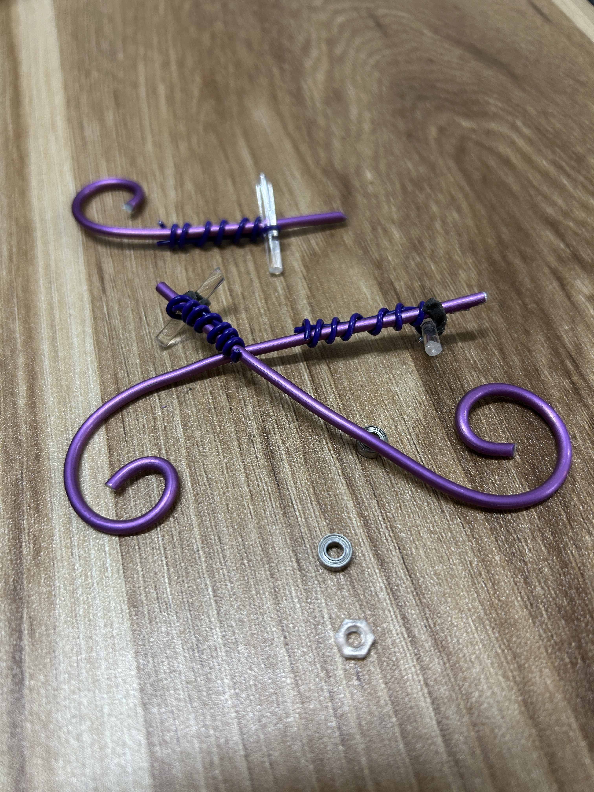
[picture p7: assets/img/IMG_9714.JPG]
assets/img/IMG_9714.JPG
