lili-lines/ratatouille/assets/img/xps_as3.JPG

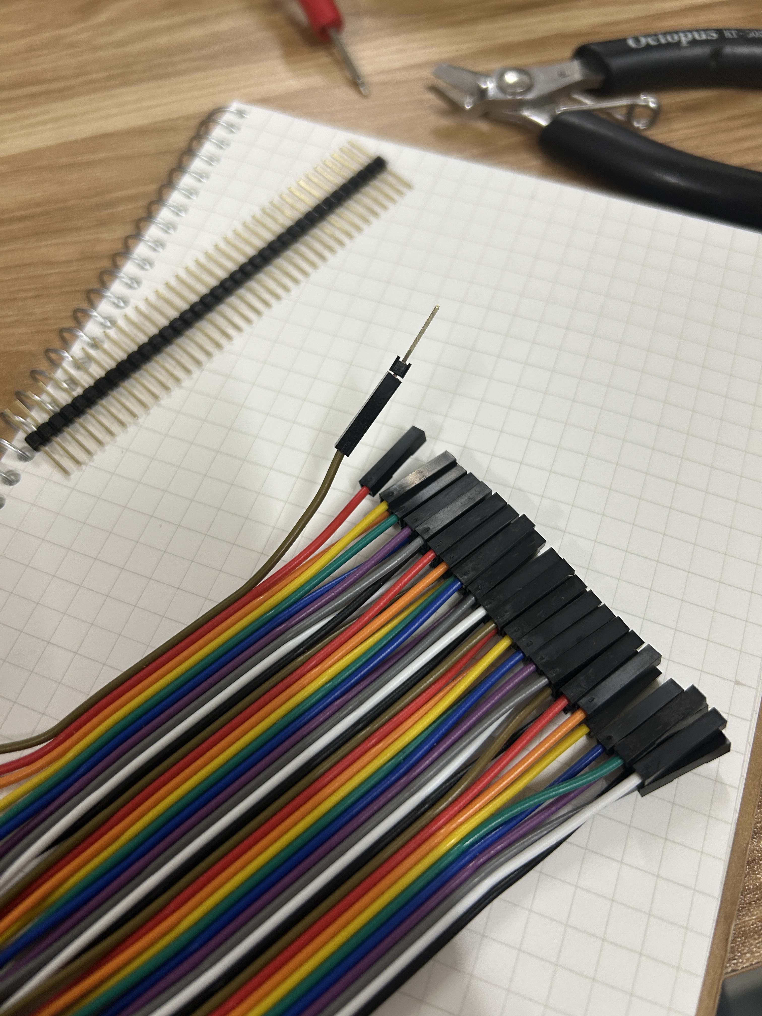
[picture p12: assets/img/xps_as3.JPG]
assets/img/xps_as3.JPG
