lili-lines/ratatouille/assets/img/IMG_9432.JPG

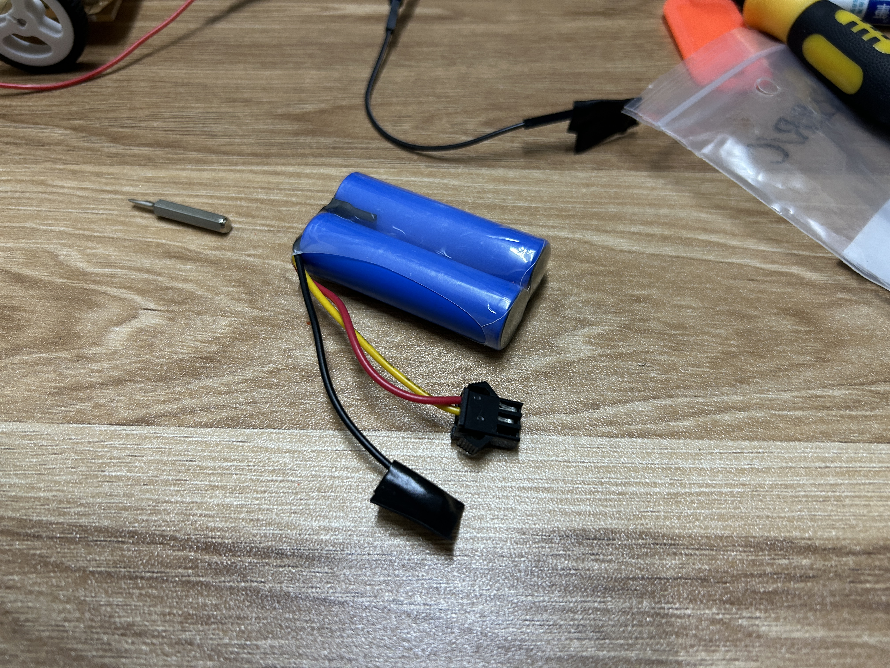
[picture p120: assets/img/IMG_9432.JPG]
assets/img/IMG_9432.JPG
