lili-lines/ratatouille/assets/img/IMG_9135.JPG

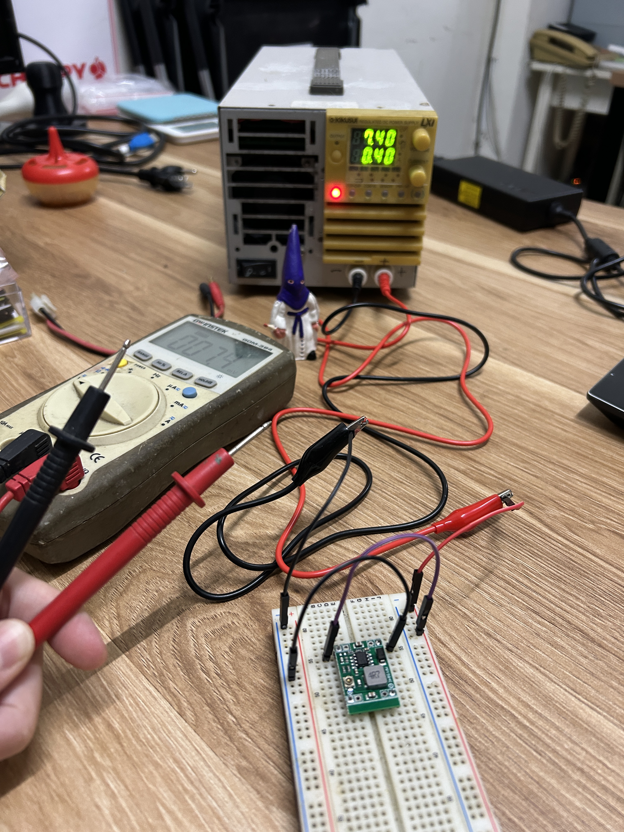
[picture p124: assets/img/IMG_9135.JPG]
assets/img/IMG_9135.JPG
