lili-lines/ratatouille/assets/img/IMG_9140.JPG

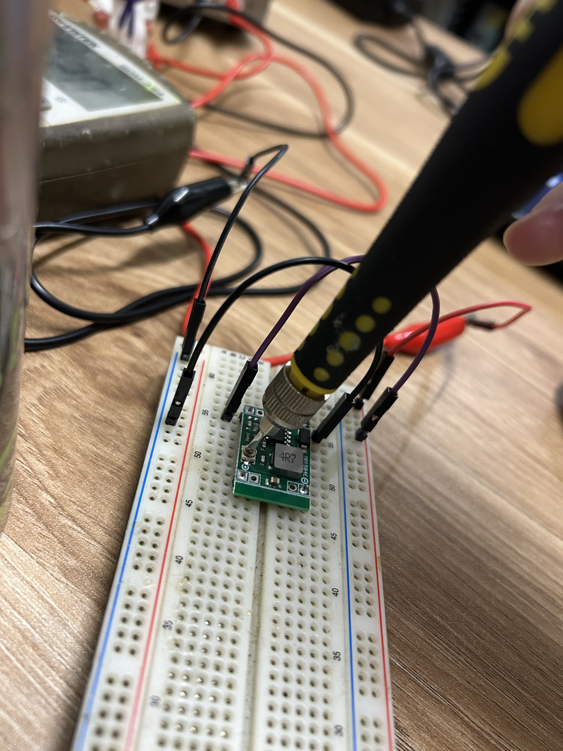
[picture p125: assets/img/IMG_9140.JPG]
assets/img/IMG_9140.JPG
