lili-lines/ratatouille/assets/img/IMG_9139.JPG

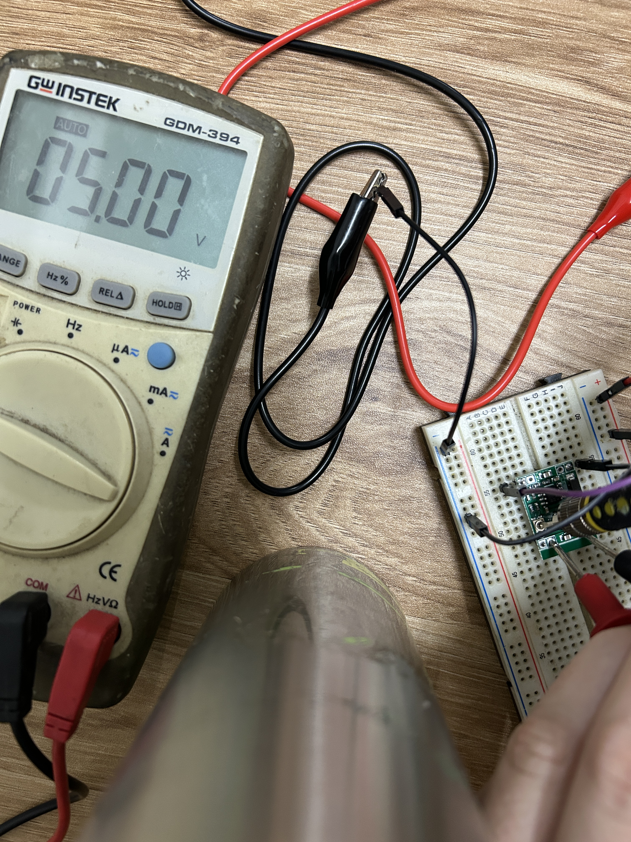
[picture p126: assets/img/IMG_9139.JPG]
assets/img/IMG_9139.JPG
